ratul-hasibulkarim/Pipe-crawller/docs/acceptance_report.md

# Acceptance test report (software-in-the-loop)

Generated by `tests/acceptance/run_acceptance.py` on 2026-10-12 04:15.
The firmware core runs unmodified against the physics plant; HARDWARE rows need the bench procedures in docs/test_plan.md.

| Test | Size | Result | Criterion | Measured |
|---|---|---|---|---|
| T1 Grip hold, vertical, power off, 3x mass | S | **PASS** | zero axial slip (<0.1 mm) over 10 min at 3x mass, MCU unpowered | drift 0.000 mm, max slip 0.000 mm, unpowered=True |
| T2 Grip hold at 0/30/45/60/90 deg | S | **PASS** | holds at every angle, zero slip (<0.1 mm), powered then unpowered | 0 deg: 0.0 mm, 30 deg: 0.0 mm, 45 deg: 0.0 mm, 60 deg: 0.0 mm, 90 deg: 0.0 mm |
| T3 Crawl speed accuracy | S | **PASS** | true speed within +/-10 % of command (25/50/100 % up, 50 % down, vertical + horizontal), no wheel slip | worst error 0.2 % |
| T4 Diameter sweep | S | **PASS** | 102<->200 mm each way in < 20 s, repeatable and accurate to +/-1 mm | slowest 12.4 s, repeatability 0.03 mm, accuracy 0.32 mm |
| T5 Centering | S | **DEVIATION** | robot axis within 3 mm of the pipe axis at 5 diameters (vertical); horizontal gravity sag reported, bounded by 6.5 mm; reported pipe ID within 2 mm while gripping | vertical worst 0.00 mm, horizontal worst 5.81 mm (spring sag; see docs/real_world_issues.md); reported ID error 0.06 mm |
| T6 Pipe material matrix | S | **PASS** | climbs 0.5 m of 45 deg pipe in steel, PVC, HDPE, cast iron, concrete-lined (dry and wet); biofilm informational | biofilm dry: ok; biofilm wet: cannot climb |
| T7 Wet traction | S | **PASS** | holds and climbs 0.5 m of vertical wet pipe at mu = 0.42 | climbed 0.502 m, max slip 0.00 mm |
| T8 Elbow traversal (geometry) | S | **PASS** | rigid segments fit a 90 deg elbow of bend radius 306 mm at the minimum pipe ID | rear segment passes 90 deg elbow at min pipe: 228.0 vs 335.0; front segment passes 90 deg elbow at min pipe: 182.0 vs 335.0; articulation joint angle needed in the bend: 42.1 vs 45.0 |
| T9 Joint / weld bead traversal | S | **PASS** | crosses a 5 mm bead and a 5 mm step climbing vertically at 80 % speed; no stall, every arm keeps wall contact | reached 1.90 m, min true arm force 28.0 N, faults [] |
| T10 Video latency | S | **HARDWARE** | < 150 ms glass-to-glass over 50 m tether | bench: film a running ms clock and the phone screen together at 240 fps (docs/test_plan.md T10) |
| T11 Telemetry integrity | S | **PASS** | 20 Hz, < 0.1 % packet loss over 60 min, link BER 1e-7 both ways, corrupt frames rejected by CRC | 71991/72000 packets, loss 0.013 %, CRC rejects: host 9, MCU 0 |
| T12 Thermal | S | **PASS** | hottest modelled component (motor winding / driver) < 85 C through 60 min of vertical crawl at 40 C ambient, still crawling at the end | max 69.6 C, derate not needed, no trip, still climbing at end |
| T13 IP68 submersion | S | **HARDWARE** | 30 min at 1 m, no ingress (pressure-decay test first, then dunk) | bench: docs/test_plan.md T13 (vacuum decay 300 mbar / 10 min, then 1 m dunk, humidity log) |
| T14 Failsafe (tether cut mid-crawl) | S | **PASS** | tether power + data lost while climbing at full speed: stops within 1 s, holds, no downward motion | stopped after 20 ms, sank 0.00 mm, supply none (worms hold unpowered) |
| T15 Endurance | S | **N/A** | battery runtime | size S is tether-powered only (no battery) |
| T1 Grip hold, vertical, power off, 3x mass | M | **PASS** | zero axial slip (<0.1 mm) over 10 min at 3x mass, MCU unpowered | drift 0.000 mm, max slip 0.000 mm, unpowered=True |
| T2 Grip hold at 0/30/45/60/90 deg | M | **PASS** | holds at every angle, zero slip (<0.1 mm), powered then unpowered | 0 deg: 0.0 mm, 30 deg: 0.0 mm, 45 deg: 0.0 mm, 60 deg: 0.0 mm, 90 deg: 0.0 mm |
| T3 Crawl speed accuracy | M | **PASS** | true speed within +/-10 % of command (25/50/100 % up, 50 % down, vertical + horizontal), no wheel slip | worst error 0.2 % |
| T4 Diameter sweep | M | **PASS** | 152<->320 mm each way in < 20 s, repeatable and accurate to +/-1 mm | slowest 13.7 s, repeatability 0.01 mm, accuracy 0.32 mm |
| T5 Centering | M | **DEVIATION** | robot axis within 3 mm of the pipe axis at 5 diameters (vertical); horizontal gravity sag reported, bounded by 6.5 mm; reported pipe ID within 2 mm while gripping | vertical worst 0.00 mm, horizontal worst 5.86 mm (spring sag; see docs/real_world_issues.md); reported ID error 0.10 mm |
| T6 Pipe material matrix | M | **PASS** | climbs 0.5 m of 45 deg pipe in steel, PVC, HDPE, cast iron, concrete-lined (dry and wet); biofilm informational | biofilm dry: ok; biofilm wet: cannot climb |
| T7 Wet traction | M | **PASS** | holds and climbs 0.5 m of vertical wet pipe at mu = 0.42 | climbed 0.504 m, max slip 0.00 mm |
| T8 Elbow traversal (geometry) | M | **PASS** | rigid segments fit a 90 deg elbow of bend radius 456 mm at the minimum pipe ID | rear segment passes 90 deg elbow at min pipe: 351.0 vs 526.5; front segment passes 90 deg elbow at min pipe: 192.0 vs 526.5; articulation joint angle needed in the bend: 37.6 vs 45.0 |
| T9 Joint / weld bead traversal | M | **PASS** | crosses a 5 mm bead and a 5 mm step climbing vertically at 80 % speed; no stall, every arm keeps wall contact | reached 1.90 m, min true arm force 65.4 N, faults [] |
| T10 Video latency | M | **HARDWARE** | < 150 ms glass-to-glass over 50 m tether | bench: film a running ms clock and the phone screen together at 240 fps (docs/test_plan.md T10) |
| T11 Telemetry integrity | M | **PASS** | 20 Hz, < 0.1 % packet loss over 60 min, link BER 1e-7 both ways, corrupt frames rejected by CRC | 71991/72000 packets, loss 0.013 %, CRC rejects: host 9, MCU 0 |
| T12 Thermal | M | **PASS** | hottest modelled component (motor winding / driver) < 85 C through 60 min of vertical crawl at 40 C ambient, still crawling at the end | max 70.0 C, derate engaged, no trip, still climbing at end |
| T13 IP68 submersion | M | **HARDWARE** | 30 min at 1 m, no ingress (pressure-decay test first, then dunk) | bench: docs/test_plan.md T13 (vacuum decay 300 mbar / 10 min, then 1 m dunk, humidity log) |
| T14 Failsafe (tether cut mid-crawl) | M | **PASS** | tether power + data lost while climbing at full speed: stops within 1 s, holds, no downward motion | stopped after 240 ms, sank 0.00 mm, supply battery |
| T15 Endurance | M | **PASS** | >= 60 min battery-only crawl (50 % speed, horizontal), then LOW_POWER_SAFE holding grip | runtime 149 min, final state LOW_POWER_SAFE |
| T1 Grip hold, vertical, power off, 3x mass | L | **PASS** | zero axial slip (<0.1 mm) over 10 min at 3x mass, MCU unpowered | drift 0.000 mm, max slip 0.000 mm, unpowered=True |
| T2 Grip hold at 0/30/45/60/90 deg | L | **PASS** | holds at every angle, zero slip (<0.1 mm), powered then unpowered | 0 deg: 0.0 mm, 30 deg: 0.0 mm, 45 deg: 0.0 mm, 60 deg: 0.0 mm, 90 deg: 0.0 mm |
| T3 Crawl speed accuracy | L | **PASS** | true speed within +/-10 % of command (25/50/100 % up, 50 % down, vertical + horizontal), no wheel slip | worst error 0.4 % |
| T4 Diameter sweep | L | **PASS** | 300<->650 mm each way in < 20 s, repeatable and accurate to +/-1 mm | slowest 15.2 s, repeatability 0.01 mm, accuracy 0.31 mm |
| T5 Centering | L | **DEVIATION** | robot axis within 3 mm of the pipe axis at 5 diameters (vertical); horizontal gravity sag reported, bounded by 6.5 mm; reported pipe ID within 2 mm while gripping | vertical worst 0.00 mm, horizontal worst 5.99 mm (spring sag; see docs/real_world_issues.md); reported ID error 0.30 mm |
| T6 Pipe material matrix | L | **PASS** | climbs 0.5 m of 45 deg pipe in steel, PVC, HDPE, cast iron, concrete-lined (dry and wet); biofilm informational | biofilm dry: ok; biofilm wet: cannot climb |
| T7 Wet traction | L | **PASS** | holds and climbs 0.5 m of vertical wet pipe at mu = 0.42 | climbed 0.502 m, max slip 0.00 mm |
| T8 Elbow traversal (geometry) | L | **PASS** | rigid segments fit a 90 deg elbow of bend radius 900 mm at the minimum pipe ID | rear segment passes 90 deg elbow at min pipe: 510.0 vs 1100.3; front segment passes 90 deg elbow at min pipe: 235.0 vs 1100.3; articulation joint angle needed in the bend: 26.6 vs 45.0 |
| T9 Joint / weld bead traversal | L | **PASS** | crosses a 5 mm bead and a 5 mm step climbing vertically at 80 % speed; no stall, every arm keeps wall contact | reached 1.90 m, min true arm force 233.3 N, faults [] |
| T10 Video latency | L | **HARDWARE** | < 150 ms glass-to-glass over 50 m tether | bench: film a running ms clock and the phone screen together at 240 fps (docs/test_plan.md T10) |
| T11 Telemetry integrity | L | **PASS** | 20 Hz, < 0.1 % packet loss over 60 min, link BER 1e-7 both ways, corrupt frames rejected by CRC | 71991/72000 packets, loss 0.013 %, CRC rejects: host 9, MCU 0 |
| T12 Thermal | L | **PASS** | hottest modelled component (motor winding / driver) < 85 C through 60 min of vertical crawl at 40 C ambient, still crawling at the end | max 70.6 C, derate engaged, no trip, still climbing at end |
| T13 IP68 submersion | L | **HARDWARE** | 30 min at 1 m, no ingress (pressure-decay test first, then dunk) | bench: docs/test_plan.md T13 (vacuum decay 300 mbar / 10 min, then 1 m dunk, humidity log) |
| T14 Failsafe (tether cut mid-crawl) | L | **PASS** | tether power + data lost while climbing at full speed: stops within 1 s, holds, no downward motion | stopped after 240 ms, sank 0.00 mm, supply battery |
| T15 Endurance | L | **PASS** | >= 60 min battery-only crawl (50 % speed, horizontal), then LOW_POWER_SAFE holding grip | runtime 180 min (still running at end of sim), final state CRAWLING |

## Details

- T1 S: `{"drift_mm": 0.0}`
- T2 S: `{"0 deg": 0.0, "30 deg": 0.0, "45 deg": 0.0, "60 deg": 0.0, "90 deg": 0.0}`
- T3 S: `{"0deg 15mm/s": 15.0, "0deg 30mm/s": 30.0, "0deg 60mm/s": 60.1, "0deg -30mm/s": -30.0, "90deg 15mm/s": 15.0, "90deg 30mm/s": 30.0, "90deg 60mm/s": 60.1, "90deg -30mm/s": -30.0}`
- T4 S: `{"times_s": [12.45, 12.35, 12.25, 12.35, 12.2, 12.35], "hi": [199.68538532722695, 199.7051261738537, 199.67528394753992], "lo": [102.30971284118687, 102.29364131746902, 102.31530294335711]}`
- T5 S: `{"90deg 102mm": 0.0, "90deg 126mm": 0.0, "90deg 151mm": 0.0, "90deg 176mm": 0.0, "90deg 200mm": 0.0, "0deg 102mm": 5.81, "0deg 126mm": 5.81, "0deg 151mm": 5.81, "0deg 176mm": 5.81, "0deg 200mm": 5.81}`
- T6 S: `{"steel dry": "0.50 m", "steel wet": "0.50 m", "pvc dry": "0.50 m", "pvc wet": "0.50 m", "hdpe dry": "0.50 m", "hdpe wet": "0.50 m", "cast_iron dry": "0.50 m", "cast_iron wet": "0.50 m", "concrete_lined dry": "0.50 m", "concrete_lined wet": "0.50 m", "biofilm_drain dry": "0.50 m", "biofilm_drain wet": "-1.00 m FAIL"}`
- T1 M: `{"drift_mm": 0.0}`
- T2 M: `{"0 deg": 0.0, "30 deg": 0.0, "45 deg": 0.0, "60 deg": 0.0, "90 deg": 0.0}`
- T3 M: `{"0deg 24mm/s": 24.0, "0deg 48mm/s": 48.0, "0deg 95mm/s": 95.1, "0deg -48mm/s": -48.0, "90deg 24mm/s": 24.0, "90deg 48mm/s": 48.1, "90deg 95mm/s": 95.1, "90deg -48mm/s": -48.0}`
- T4 M: `{"times_s": [13.7, 13.7, 13.55, 13.7, 13.55, 13.7], "hi": [319.70058153696004, 319.68895429772954, 319.69799766534595], "lo": [152.30944709877522, 152.31521255611705, 152.30829406071163]}`
- T5 M: `{"90deg 152mm": 0.0, "90deg 194mm": 0.0, "90deg 236mm": 0.0, "90deg 278mm": 0.0, "90deg 320mm": 0.0, "0deg 152mm": 5.86, "0deg 194mm": 5.86, "0deg 236mm": 5.86, "0deg 278mm": 5.86, "0deg 320mm": 5.86}`
- T6 M: `{"steel dry": "0.50 m", "steel wet": "0.50 m", "pvc dry": "0.50 m", "pvc wet": "0.50 m", "hdpe dry": "0.50 m", "hdpe wet": "0.50 m", "cast_iron dry": "0.50 m", "cast_iron wet": "0.50 m", "concrete_lined dry": "0.50 m", "concrete_lined wet": "0.50 m", "biofilm_drain dry": "0.50 m", "biofilm_drain wet": "-1.00 m FAIL"}`
- T1 L: `{"drift_mm": 0.0}`
- T2 L: `{"0 deg": 0.0, "30 deg": 0.0, "45 deg": 0.0, "60 deg": 0.0, "90 deg": 0.0}`
- T3 L: `{"0deg 18mm/s": 18.0, "0deg 35mm/s": 35.1, "0deg 70mm/s": 70.1, "0deg -35mm/s": -35.0, "90deg 18mm/s": 18.1, "90deg 35mm/s": 35.1, "90deg 70mm/s": 70.1, "90deg -35mm/s": -35.1}`
- T4 L: `{"times_s": [15.1, 15.2, 15.2, 15.2, 15.05, 15.2], "hi": [649.6954932157279, 649.7079596335313, 649.7011609057913], "lo": [300.3092881055281, 300.3043819199976, 300.30928817776004]}`
- T5 L: `{"90deg 300mm": 0.0, "90deg 388mm": 0.0, "90deg 475mm": 0.0, "90deg 562mm": 0.0, "90deg 650mm": 0.0, "0deg 300mm": 5.99, "0deg 388mm": 5.99, "0deg 475mm": 5.99, "0deg 562mm": 5.99, "0deg 650mm": 5.99}`
- T6 L: `{"steel dry": "0.50 m", "steel wet": "0.50 m", "pvc dry": "0.50 m", "pvc wet": "0.50 m", "hdpe dry": "0.50 m", "hdpe wet": "0.50 m", "cast_iron dry": "0.50 m", "cast_iron wet": "0.50 m", "concrete_lined dry": "0.50 m", "concrete_lined wet": "0.50 m", "biofilm_drain dry": "0.50 m", "biofilm_drain wet": "-1.00 m FAIL"}`
