ratul-hasibulkarim/Pipe-crawller/docs/mass_report.md

# Mass report

Generated by `cad/build.py`. Made parts: CAD volume x density; purchased parts: catalogue mass.

## Size S

| Module | Mass (kg) |
|---|---|
| A_body | 0.348 |
| B_expansion | 0.365 |
| C_wheel | 0.170 |
| D_gimbal | 0.016 |
| E_accessories | 0.043 |
| purchased | 0.551 |
| **CAD total** | **1.492** |
| + 12 % wiring/grease/potting/fasteners | 0.179 |
| **Estimated flight mass** | **1.671** |

Target 1.8 kg: within target. CG at [-0.13, -0.02, 53.84] mm (radial offset 0.13 mm; roll calc assumes 3 mm).

## Size M

| Module | Mass (kg) |
|---|---|
| A_body | 0.681 |
| B_expansion | 1.034 |
| C_wheel | 0.459 |
| D_gimbal | 0.030 |
| E_accessories | 0.088 |
| purchased | 1.302 |
| **CAD total** | **3.593** |
| + 12 % wiring/grease/potting/fasteners | 0.431 |
| **Estimated flight mass** | **4.024** |

Target 4.2 kg: within target. CG at [-0.2, -0.03, 67.76] mm (radial offset 0.21 mm; roll calc assumes 5 mm).

## Size L

| Module | Mass (kg) |
|---|---|
| A_body | 2.076 |
| B_expansion | 4.605 |
| C_wheel | 1.251 |
| D_gimbal | 0.123 |
| E_accessories | 0.313 |
| purchased | 4.953 |
| **CAD total** | **13.321** |
| + 12 % wiring/grease/potting/fasteners | 1.599 |
| **Estimated flight mass** | **14.920** |

Target 15.0 kg: within target. CG at [0.09, -0.06, 61.67] mm (radial offset 0.11 mm; roll calc assumes 8 mm).
