ratul-hasibulkarim/Pipe-crawller/docs/fastener_table.md

# Fastener table

Per robot, generated by `cad/build.py` (rule 6: M2/M2.5/M3/M4 SHCS + heat-set inserts only).

## Size S

| Fastener | Qty |
|---|---|
| E-clip | 28 |
| M2 heat-set insert | 4 |
| M2.5 heat-set insert | 8 |
| M2.5x10 SHCS | 8 |
| M2.5x10 SHCS (spine) | 4 |
| M2.5x5 SHCS | 8 |
| M2.5x6 SHCS | 6 |
| M2.5x6 SHCS (pod) | 12 |
| M2.5x8 SHCS | 8 |
| M2.5x8 SHCS (radial) | 24 |
| M2x4 SHCS | 4 |
| M2x5 SHCS | 4 |
| M2x6 SHCS | 16 |
| M2x8 SHCS (eccentric) | 3 |
| M3 set screw | 2 |
| centring torsion spring | 2 |
| hose clamp | 2 |
| oil-impregnated bronze bushing (pivot) | 6 |
| split collet clamp (Kevlar strength member) | 1 |

## Size M

| Fastener | Qty |
|---|---|
| E-clip | 28 |
| M2 heat-set insert | 4 |
| M2.5 heat-set insert | 8 |
| M2.5x5 SHCS | 8 |
| M2x4 SHCS | 4 |
| M2x5 SHCS | 4 |
| M2x6 SHCS | 4 |
| M2x8 SHCS (eccentric) | 3 |
| M3 set screw | 2 |
| M3x10 SHCS | 8 |
| M3x10 SHCS (spine) | 4 |
| M3x6 SHCS | 6 |
| M3x6 SHCS (pod) | 12 |
| M3x8 SHCS | 20 |
| M3x8 SHCS (radial) | 24 |
| centring torsion spring | 2 |
| hose clamp | 2 |
| oil-impregnated bronze bushing (pivot) | 6 |
| split collet clamp (Kevlar strength member) | 1 |

## Size L

| Fastener | Qty |
|---|---|
| E-clip | 28 |
| M2 heat-set insert | 4 |
| M2.5 heat-set insert | 8 |
| M2.5x5 SHCS | 8 |
| M2x4 SHCS | 4 |
| M2x5 SHCS | 4 |
| M2x6 SHCS | 4 |
| M2x8 SHCS (eccentric) | 3 |
| M3 set screw | 2 |
| M3x8 SHCS | 12 |
| M4x10 SHCS | 8 |
| M4x10 SHCS (spine) | 4 |
| M4x6 SHCS | 6 |
| M4x6 SHCS (pod) | 12 |
| M4x8 SHCS | 8 |
| M4x8 SHCS (radial) | 24 |
| centring torsion spring | 2 |
| hose clamp | 2 |
| oil-impregnated bronze bushing (pivot) | 6 |
| split collet clamp (Kevlar strength member) | 1 |
