ratul-hasibulkarim/Pipe-crawller/cad/exports/common/png/tether_reel_frame.png

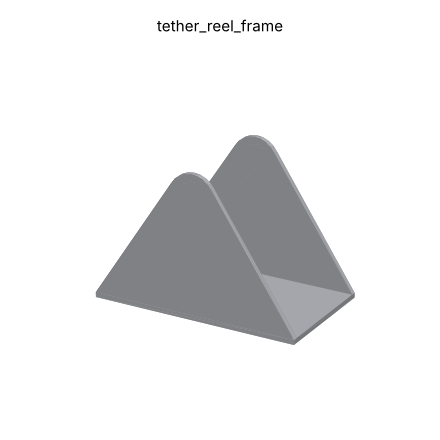
cad/exports/common/png/tether_reel_frame.png
