ratul-hasibulkarim/Pipe-crawller/cad/exports/common/png/tether_reel_motor_NEMA17.png

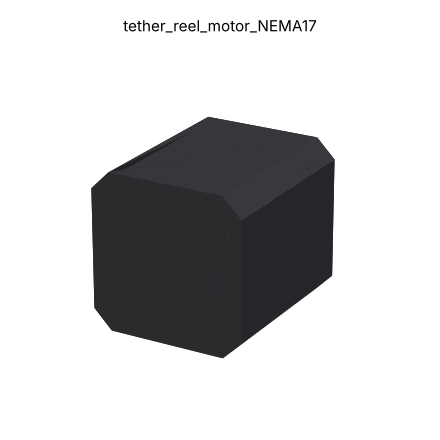
cad/exports/common/png/tether_reel_motor_NEMA17.png
