ratul-hasibulkarim/Pipe-crawller/cad/exports/common/png/tether_reel_slip_ring.png

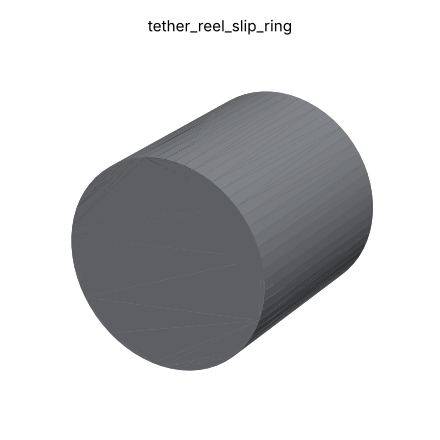
cad/exports/common/png/tether_reel_slip_ring.png
