ratul-hasibulkarim/Pipe-crawller/cad/exports/common/png/tether_reel_spool.png

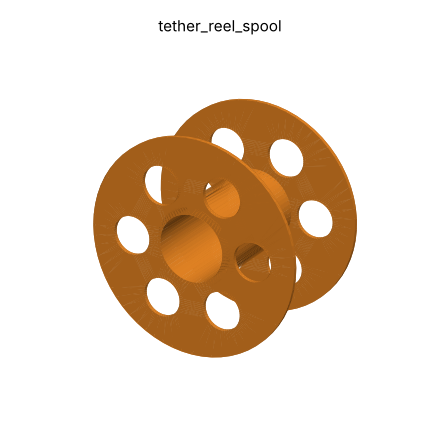
cad/exports/common/png/tether_reel_spool.png
