ratul-hasibulkarim/Pipe-crawller/cad/exports/common/tether_reel.png

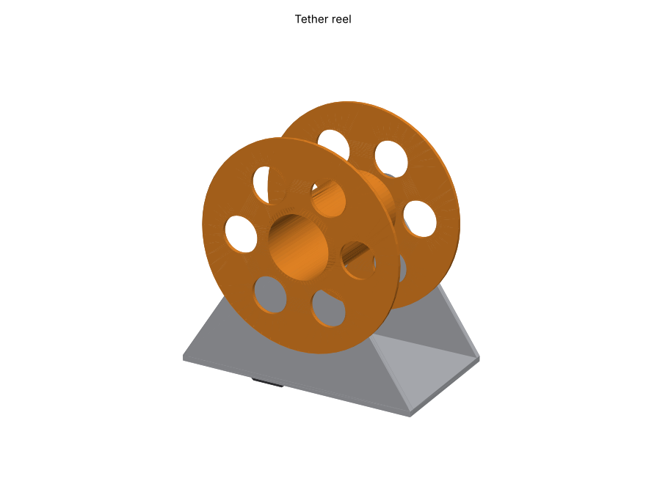
cad/exports/common/tether_reel.png
