ratul-hasibulkarim/Pipe-crawller/cad/exports/L/exploded.png

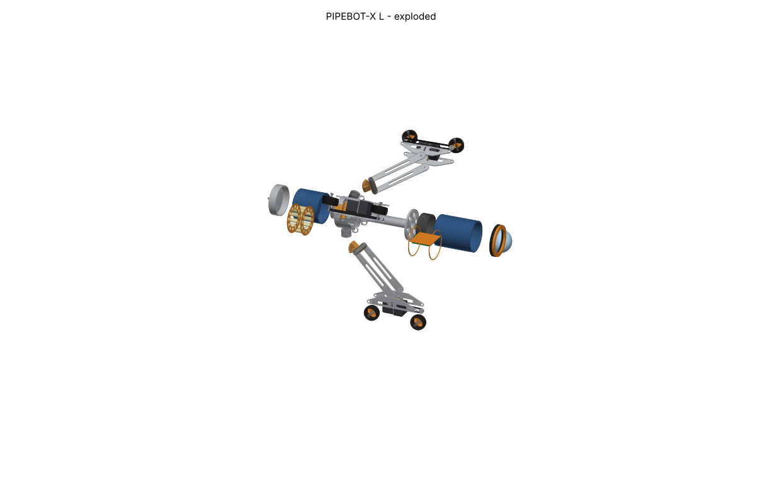
cad/exports/L/exploded.png
