ratul-hasibulkarim/Pipe-crawller/cad/exports/L/front_view_max.png

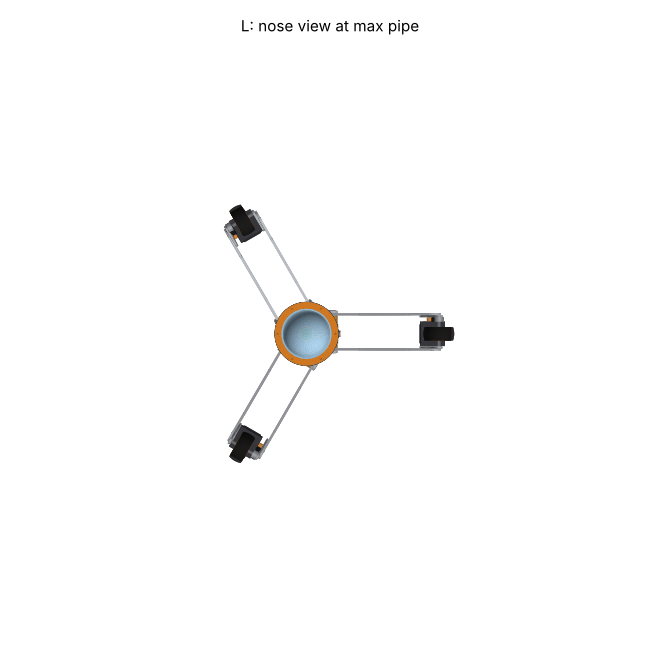
cad/exports/L/front_view_max.png
