ratul-hasibulkarim/Pipe-crawller/cad/exports/L/png/articulation_spider.png

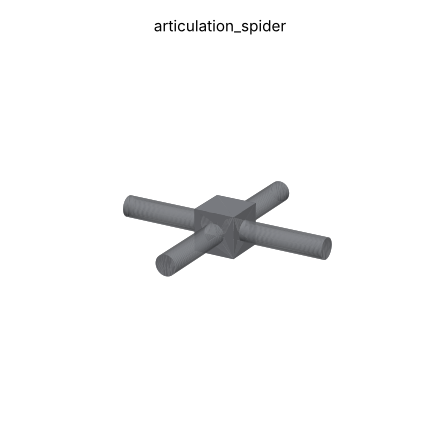
cad/exports/L/png/articulation_spider.png
