ratul-hasibulkarim/Pipe-crawller/cad/exports/L/png/articulation_yoke_front.png

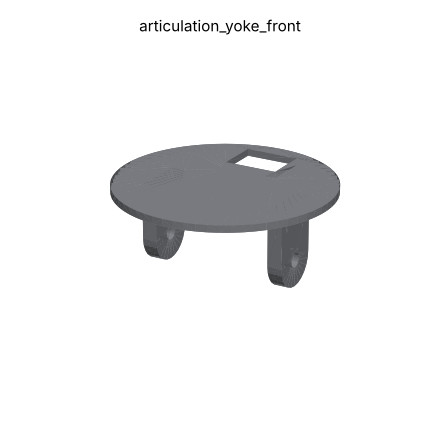
cad/exports/L/png/articulation_yoke_front.png
