ratul-hasibulkarim/Pipe-crawller/cad/exports/L/png/articulation_yoke_rear.png

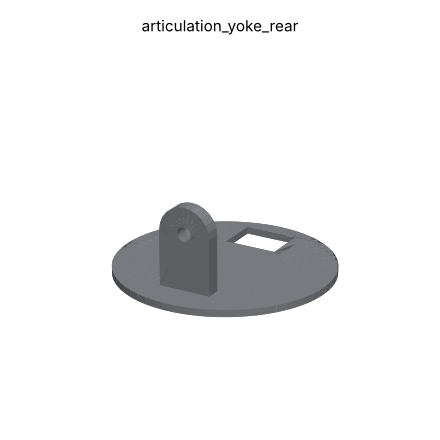
cad/exports/L/png/articulation_yoke_rear.png
