ratul-hasibulkarim/Pipe-crawller/cad/exports/L/png/battery_caddy.png

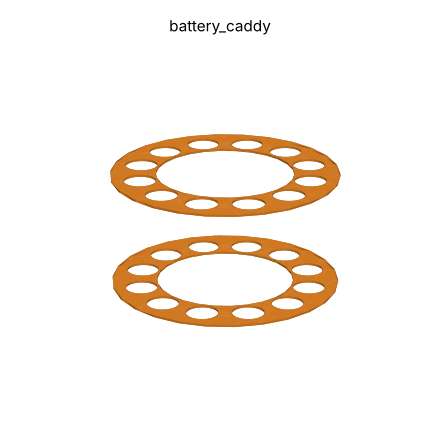
cad/exports/L/png/battery_caddy.png
