ratul-hasibulkarim/Pipe-crawller/cad/exports/L/png/bearing_MR128ZZ.png

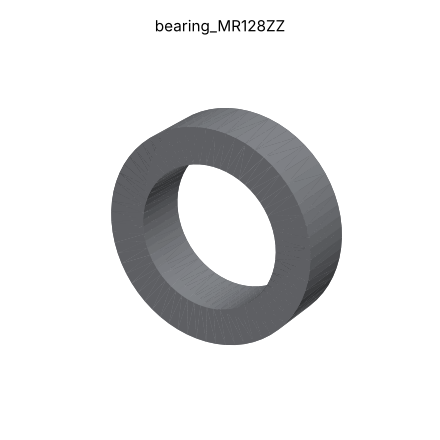
cad/exports/L/png/bearing_MR128ZZ.png
