ratul-hasibulkarim/Pipe-crawller/cad/exports/L/png/belt_tensioner.png

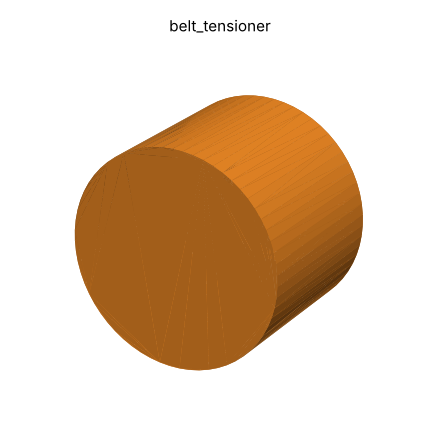
cad/exports/L/png/belt_tensioner.png
