ratul-hasibulkarim/Pipe-crawller/cad/exports/L/png/bevel_crown.png

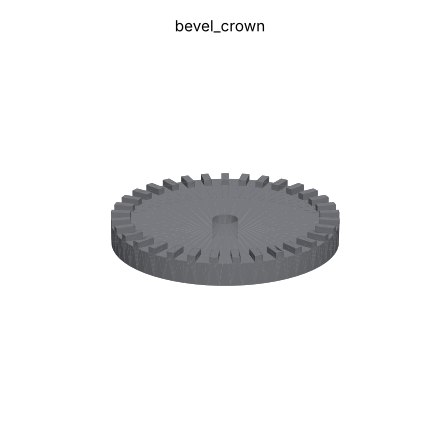
cad/exports/L/png/bevel_crown.png
