ratul-hasibulkarim/Pipe-crawller/cad/exports/L/png/bevel_pinion.png

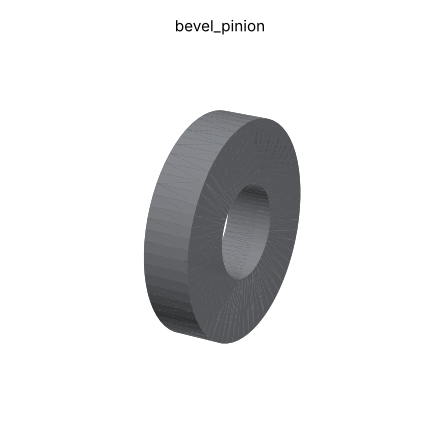
cad/exports/L/png/bevel_pinion.png
