ratul-hasibulkarim/Pipe-crawller/cad/exports/L/png/body_front_shell.png

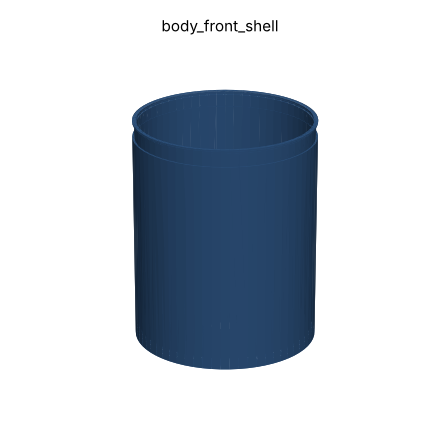
cad/exports/L/png/body_front_shell.png
