ratul-hasibulkarim/Pipe-crawller/cad/exports/L/png/body_mid_chassis.png

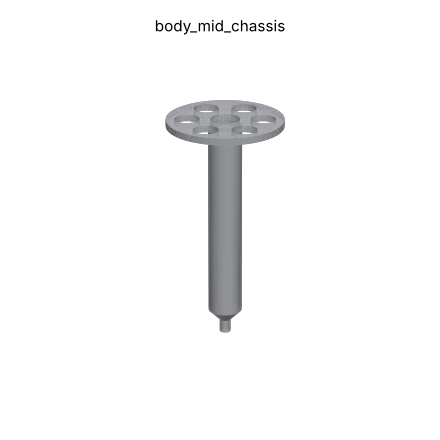
cad/exports/L/png/body_mid_chassis.png
