ratul-hasibulkarim/Pipe-crawller/cad/exports/L/png/buck_48v_12v_5v.png

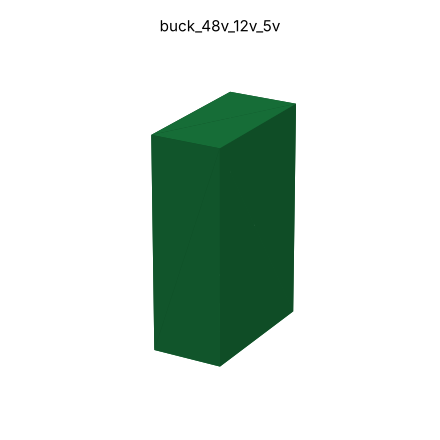
cad/exports/L/png/buck_48v_12v_5v.png
