ratul-hasibulkarim/Pipe-crawller/cad/exports/L/png/camera_module.png

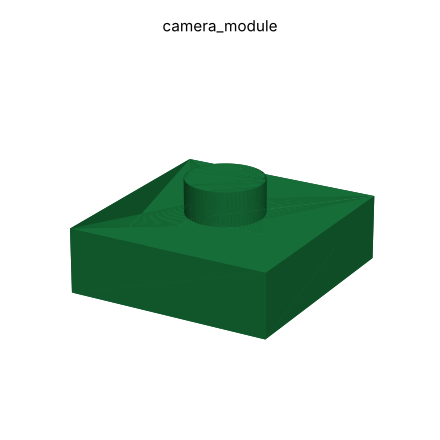
cad/exports/L/png/camera_module.png
