ratul-hasibulkarim/Pipe-crawller/cad/exports/L/png/cell_18650.png

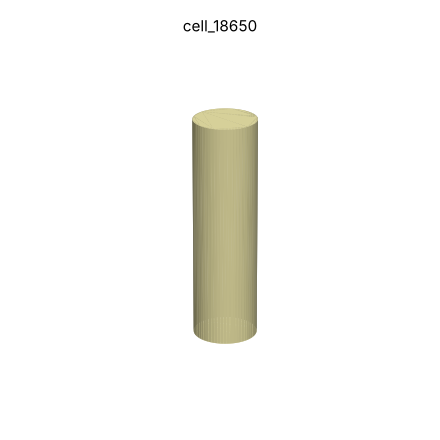
cad/exports/L/png/cell_18650.png
