ratul-hasibulkarim/Pipe-crawller/cad/exports/L/png/compliance_spring_retainer.png

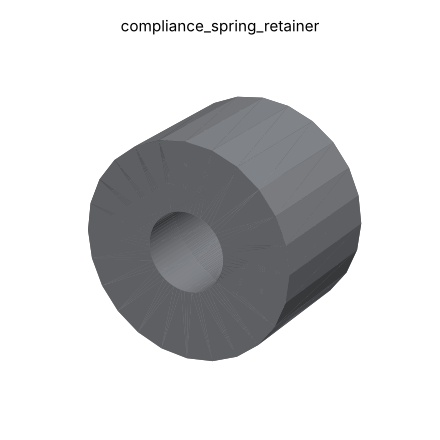
cad/exports/L/png/compliance_spring_retainer.png
