ratul-hasibulkarim/Pipe-crawller/cad/exports/L/png/drive_belt_GT2.png

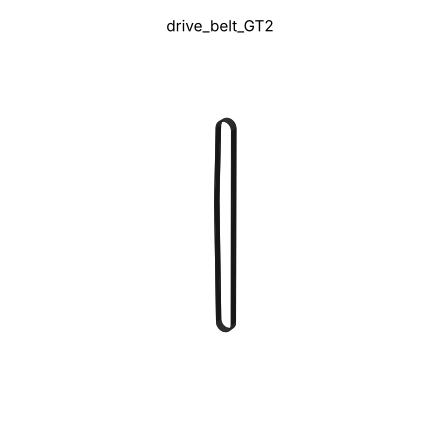
cad/exports/L/png/drive_belt_GT2.png
