ratul-hasibulkarim/Pipe-crawller/cad/exports/L/png/drive_motor_mount.png

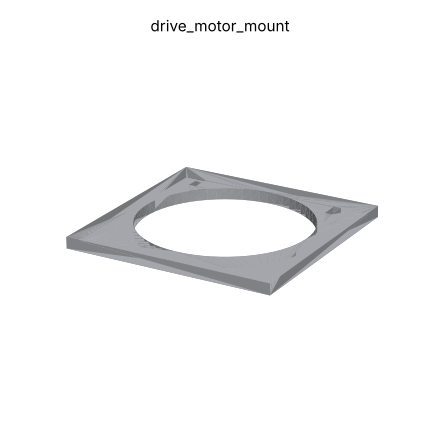
cad/exports/L/png/drive_motor_mount.png
