ratul-hasibulkarim/Pipe-crawller/cad/exports/L/png/drive_stepper_NEMA23.png

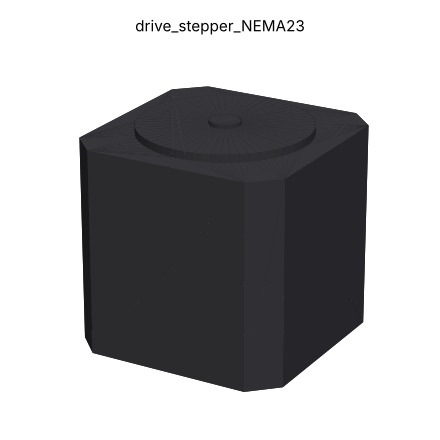
cad/exports/L/png/drive_stepper_NEMA23.png
