ratul-hasibulkarim/Pipe-crawller/cad/exports/L/png/drive_worm_gearbox_21to1.png

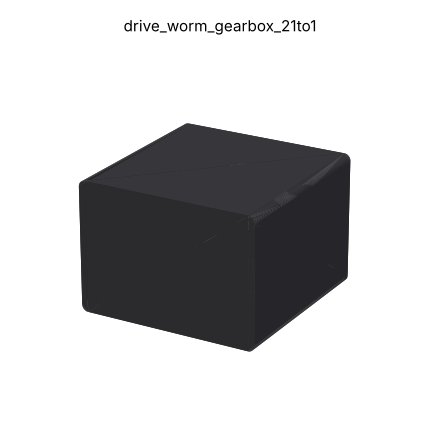
cad/exports/L/png/drive_worm_gearbox_21to1.png
