ratul-hasibulkarim/Pipe-crawller/cad/exports/L/png/electronics_tray.png

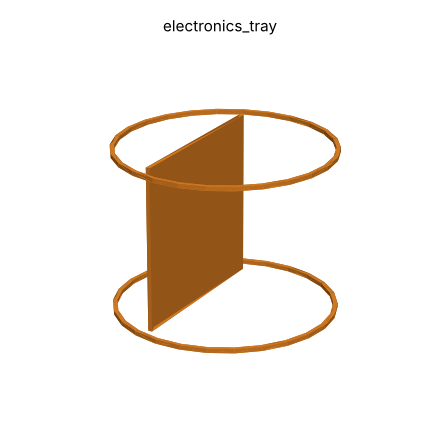
cad/exports/L/png/electronics_tray.png
