ratul-hasibulkarim/Pipe-crawller/cad/exports/L/png/expansion_motor_NEMA23L.png

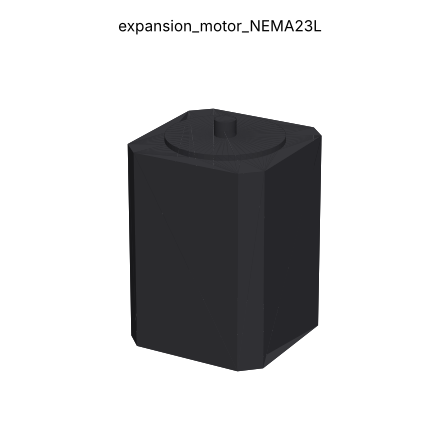
cad/exports/L/png/expansion_motor_NEMA23L.png
