ratul-hasibulkarim/Pipe-crawller/cad/exports/L/png/expansion_worm.png

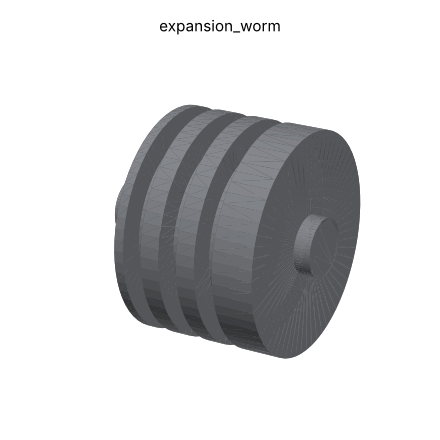
cad/exports/L/png/expansion_worm.png
