ratul-hasibulkarim/Pipe-crawller/cad/exports/L/png/gearbox_bulkhead.png

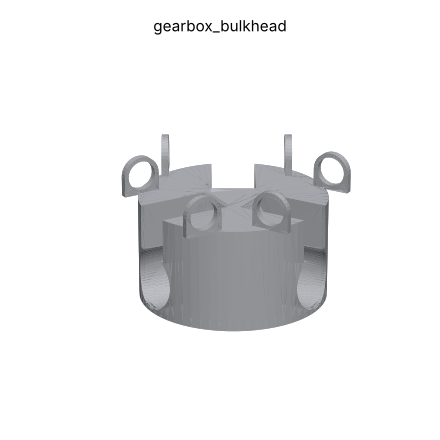
cad/exports/L/png/gearbox_bulkhead.png
