ratul-hasibulkarim/Pipe-crawller/cad/exports/L/png/gimbal_tilt_cradle.png

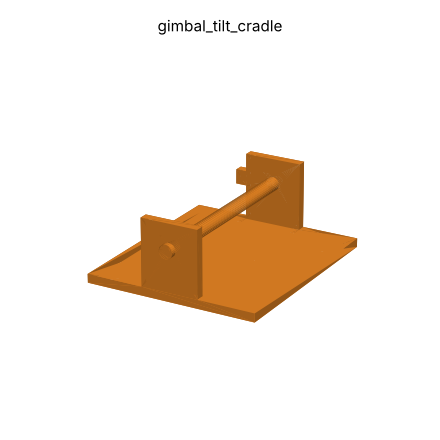
cad/exports/L/png/gimbal_tilt_cradle.png
