ratul-hasibulkarim/Pipe-crawller/cad/exports/L/png/joint_boot.png

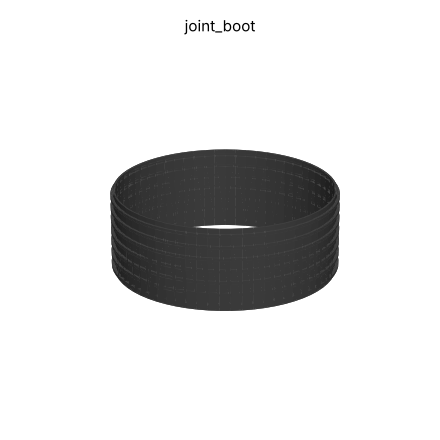
cad/exports/L/png/joint_boot.png
