ratul-hasibulkarim/Pipe-crawller/cad/exports/L/png/led_ring_mount.png

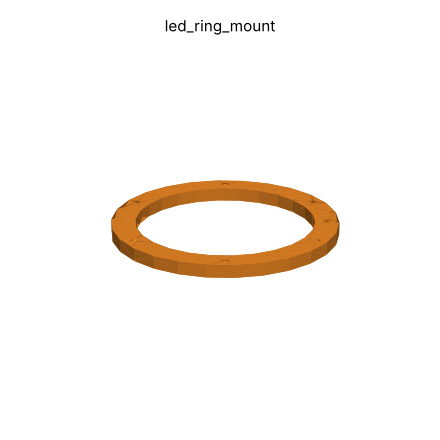
cad/exports/L/png/led_ring_mount.png
