ratul-hasibulkarim/Pipe-crawller/cad/exports/L/png/mcu_board_RP2040.png

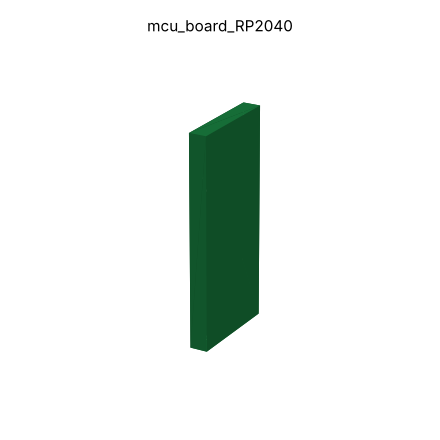
cad/exports/L/png/mcu_board_RP2040.png
