ratul-hasibulkarim/Pipe-crawller/cad/exports/L/png/pan_gearmotor_ga25.png

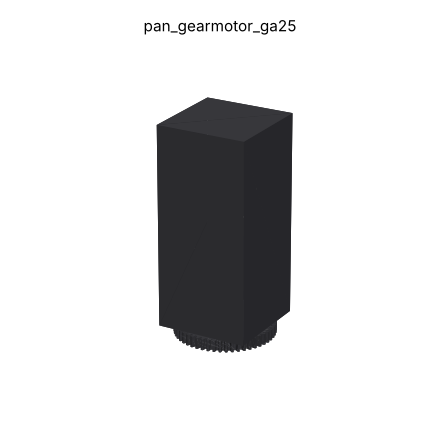
cad/exports/L/png/pan_gearmotor_ga25.png
