ratul-hasibulkarim/Pipe-crawller/cad/exports/L/png/pipe_size_adapter.png

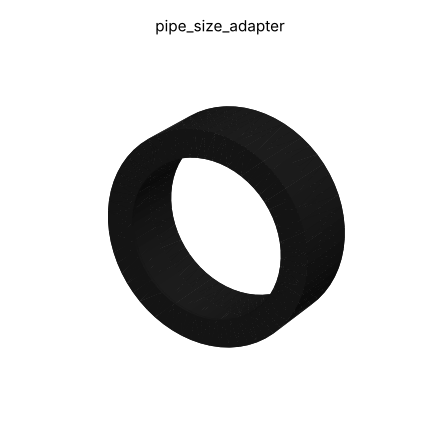
cad/exports/L/png/pipe_size_adapter.png
