ratul-hasibulkarim/Pipe-crawller/cad/exports/L/png/pivot_shaft.png

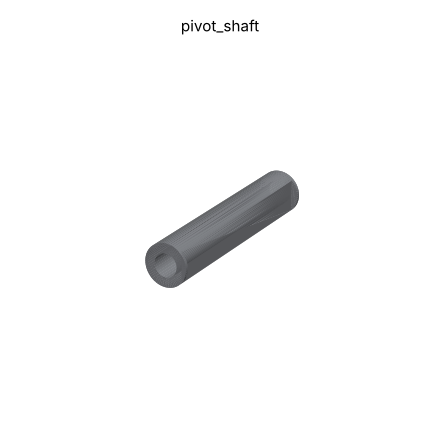
cad/exports/L/png/pivot_shaft.png
