ratul-hasibulkarim/Pipe-crawller/cad/exports/L/png/service_hatch_gasket.png

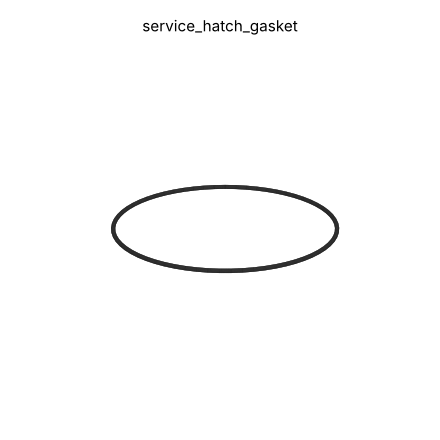
cad/exports/L/png/service_hatch_gasket.png
