ratul-hasibulkarim/Pipe-crawller/cad/exports/L/png/stub_pin.png

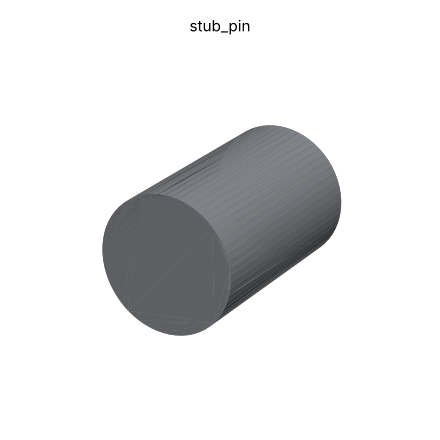
cad/exports/L/png/stub_pin.png
