ratul-hasibulkarim/Pipe-crawller/cad/exports/L/png/tether_strain_relief.png

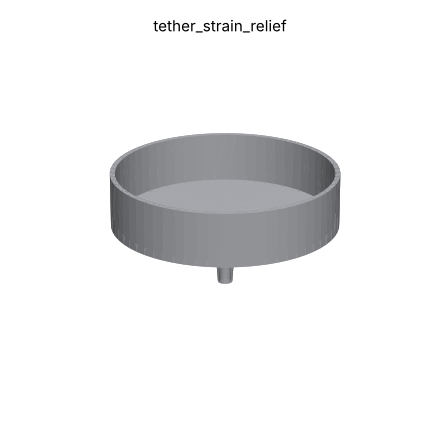
cad/exports/L/png/tether_strain_relief.png
