ratul-hasibulkarim/Pipe-crawller/cad/exports/L/png/tilt_servo_micro.png

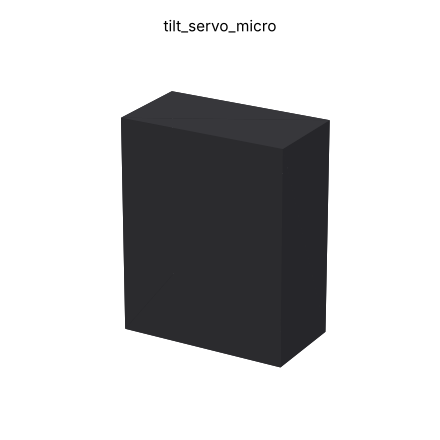
cad/exports/L/png/tilt_servo_micro.png
