ratul-hasibulkarim/Pipe-crawller/cad/exports/L/png/timing_pulley_GT2.png

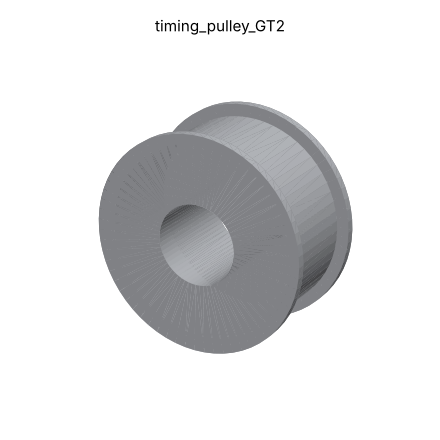
cad/exports/L/png/timing_pulley_GT2.png
