ratul-hasibulkarim/Pipe-crawller/cad/exports/L/png/wheel_crown_mold.png

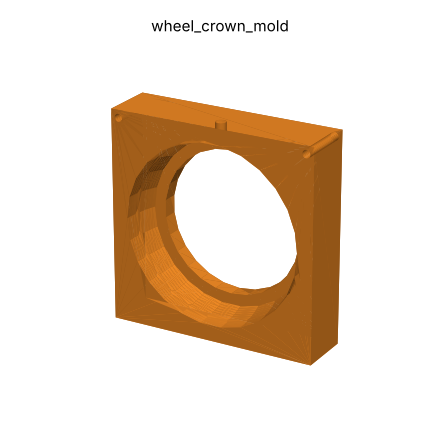
cad/exports/L/png/wheel_crown_mold.png
