ratul-hasibulkarim/Pipe-crawller/cad/exports/L/png/wheel_hub.png

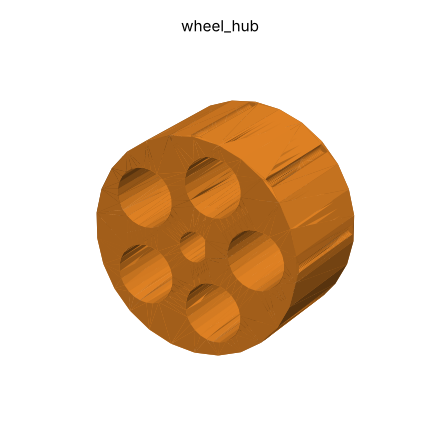
cad/exports/L/png/wheel_hub.png
