ratul-hasibulkarim/Pipe-crawller/cad/exports/L/png/wheel_tread.png

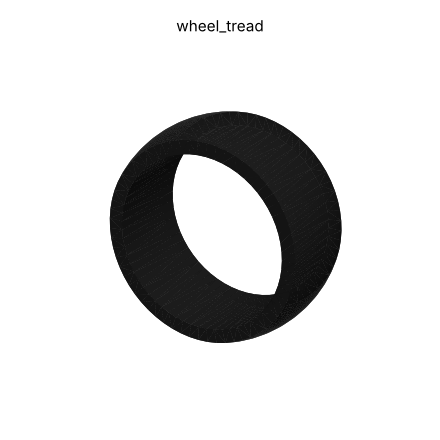
cad/exports/L/png/wheel_tread.png
