ratul-hasibulkarim/Pipe-crawller/cad/exports/L/png/worm_sector.png

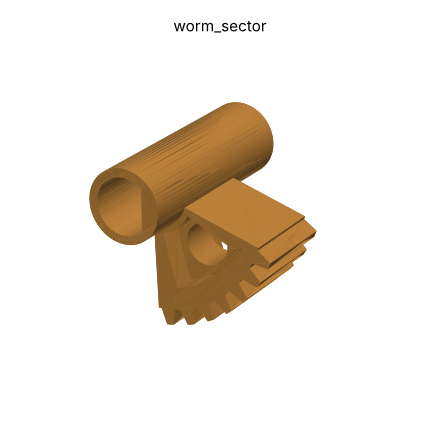
cad/exports/L/png/worm_sector.png
