ratul-hasibulkarim/Pipe-crawller/cad/exports/M/png/battery_caddy.png

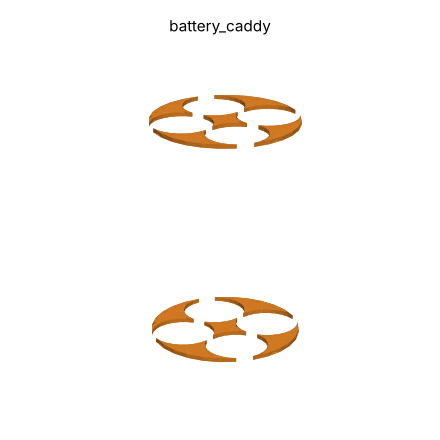
cad/exports/M/png/battery_caddy.png
