ratul-hasibulkarim/Pipe-crawller/cad/exports/M/png/drive_stepper_NEMA14.png

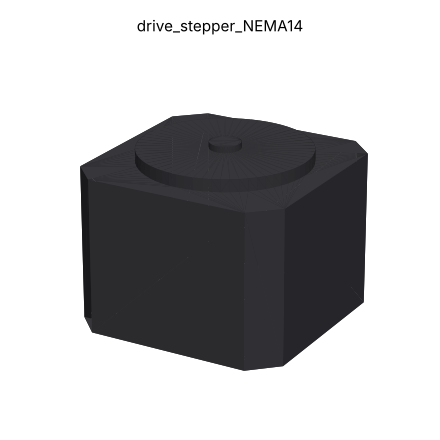
cad/exports/M/png/drive_stepper_NEMA14.png
