ratul-hasibulkarim/Pipe-crawller/cad/exports/M/png/electronics_tray.png

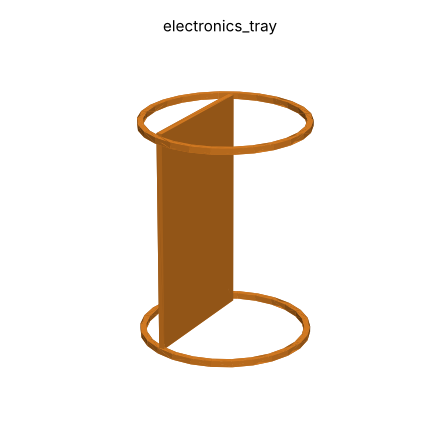
cad/exports/M/png/electronics_tray.png
