ratul-hasibulkarim/Pipe-crawller/cad/exports/M/png/gimbal_pan_yoke.png

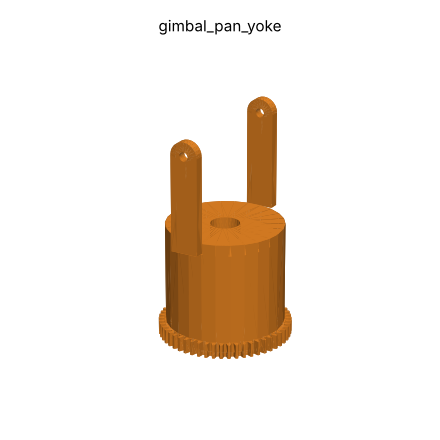
cad/exports/M/png/gimbal_pan_yoke.png
