ratul-hasibulkarim/Pipe-crawller/cad/exports/M/png/planetary_5to1.png

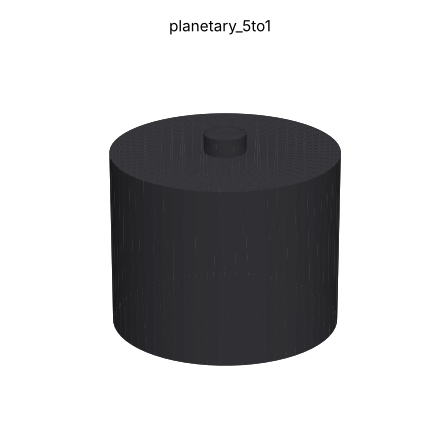
cad/exports/M/png/planetary_5to1.png
