ratul-hasibulkarim/Pipe-crawller/cad/exports/M/png/tilt_servo_nano.png

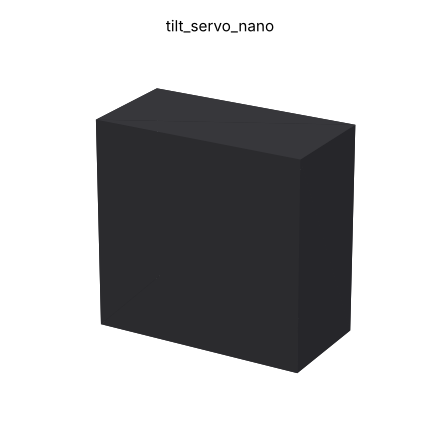
cad/exports/M/png/tilt_servo_nano.png
