ratul-hasibulkarim/Pipe-crawller/cad/exports/M/png/wheel_crown_mold.png

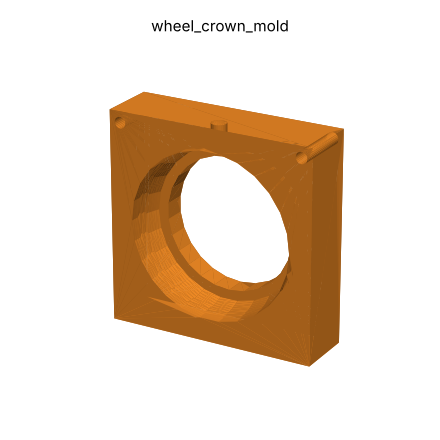
cad/exports/M/png/wheel_crown_mold.png
