ratul-hasibulkarim/Pipe-crawller/cad/exports/S/png/drive_motor_mount.png

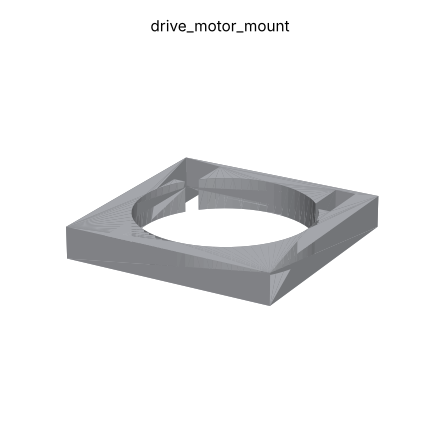
cad/exports/S/png/drive_motor_mount.png
