ratul-hasibulkarim/Pipe-crawller/cad/exports/S/png/expansion_motor_NEMA14.png

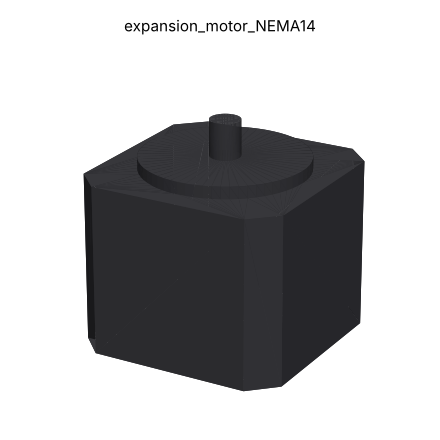
cad/exports/S/png/expansion_motor_NEMA14.png
