ratul-hasibulkarim/Pipe-crawller/cad/exports/S/png/tether_strain_relief.png

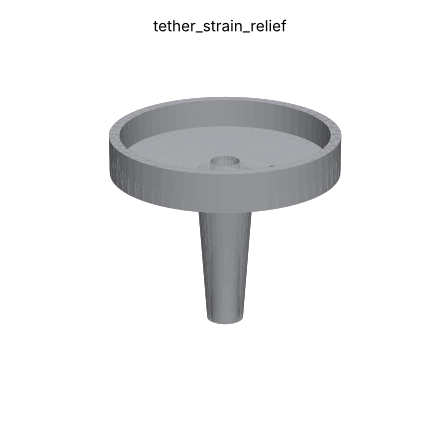
cad/exports/S/png/tether_strain_relief.png
