ratul-hasibulkarim/Pipe-crawller/docs/img/sil_T9_M.png

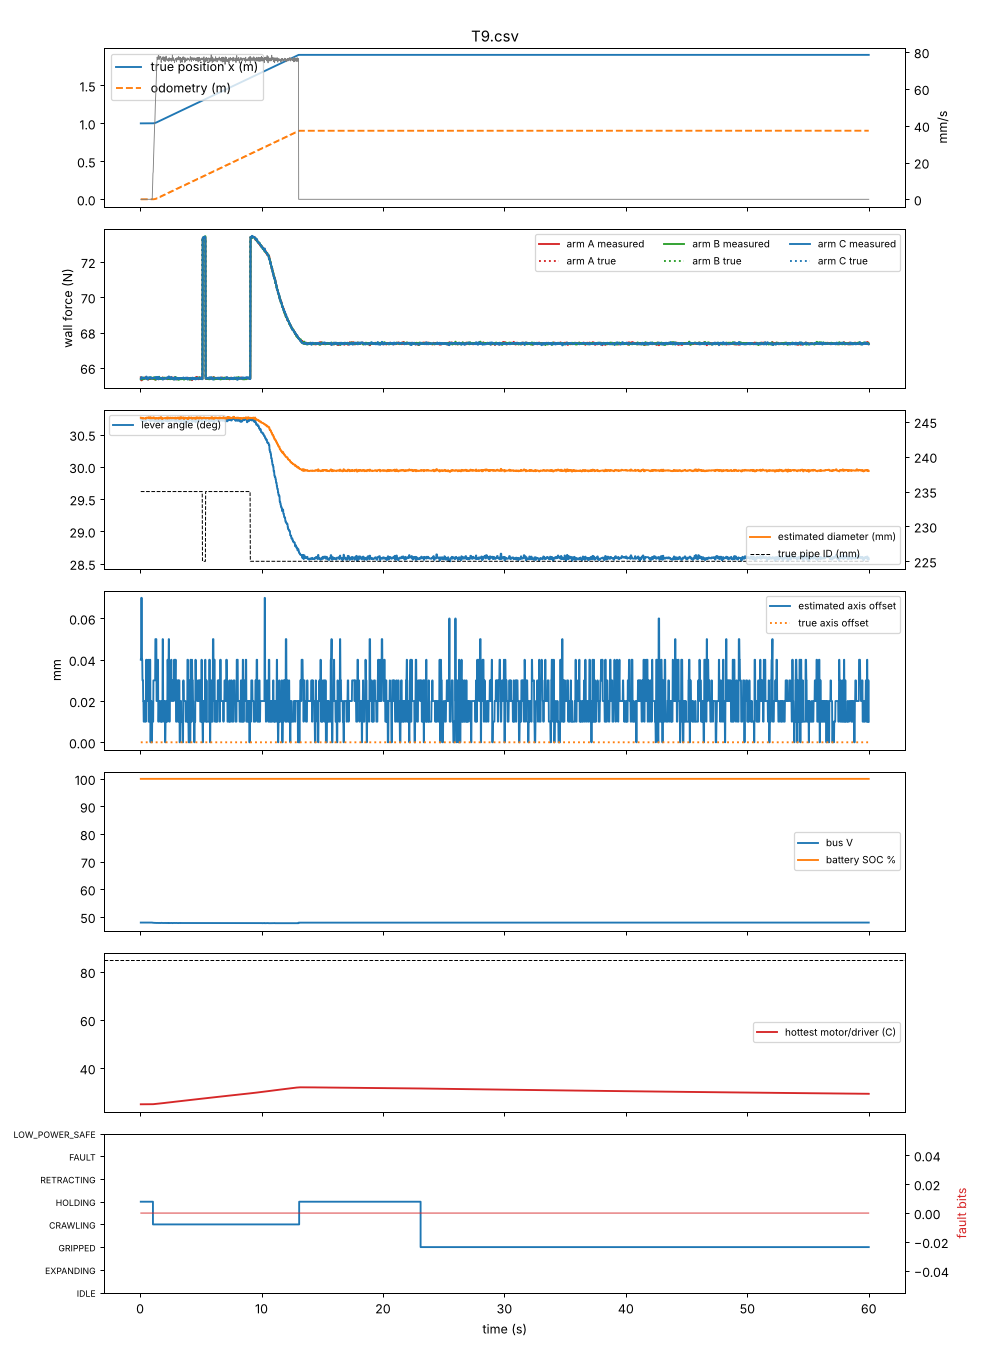
docs/img/sil_T9_M.png
