ratul-hasibulkarim/Pipe-crawller/docs/img/sil_T14_L.png

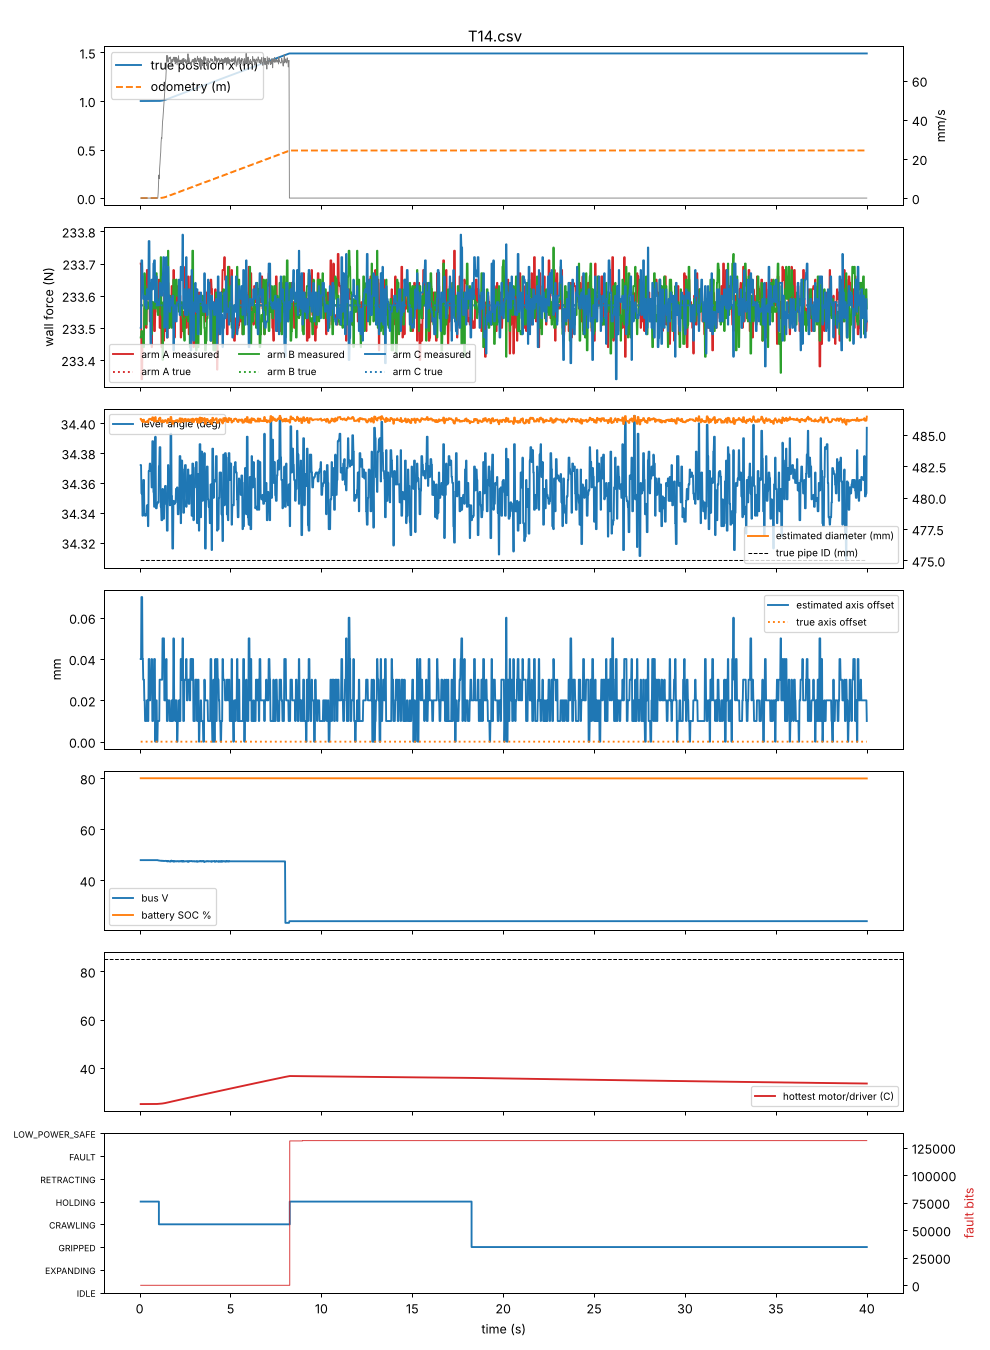
docs/img/sil_T14_L.png
