ratul-hasibulkarim/Pipe-crawller/docs/img/ui_connect.png

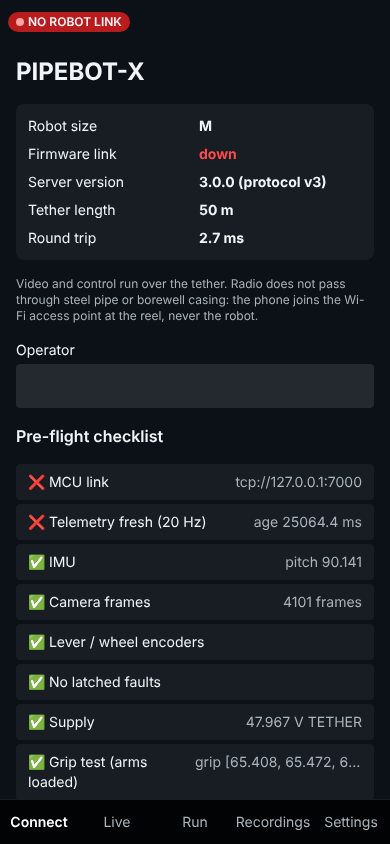
docs/img/ui_connect.png
