ratul-hasibulkarim/Pipe-crawller/docs/img/ui_live_stale.png

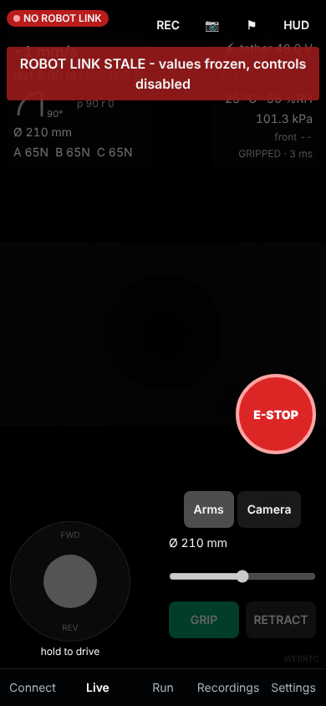
docs/img/ui_live_stale.png
