ratul-hasibulkarim/Pipe-crawller/docs/img/ui_run.png

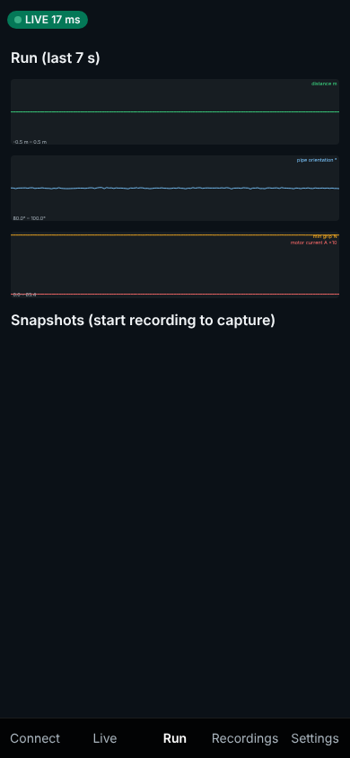
docs/img/ui_run.png
