ratul-hasibulkarim/Pipe-crawller/docs/img/ui_settings.png

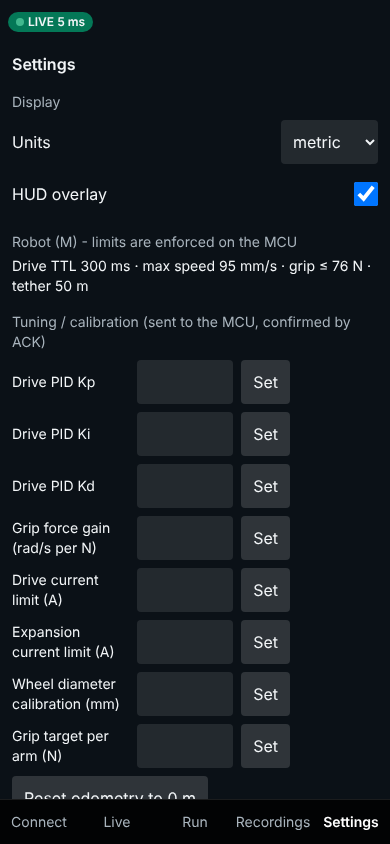
docs/img/ui_settings.png
