ratul-hasibulkarim/Pipe-crawller/cad/exports/M/assembly.step

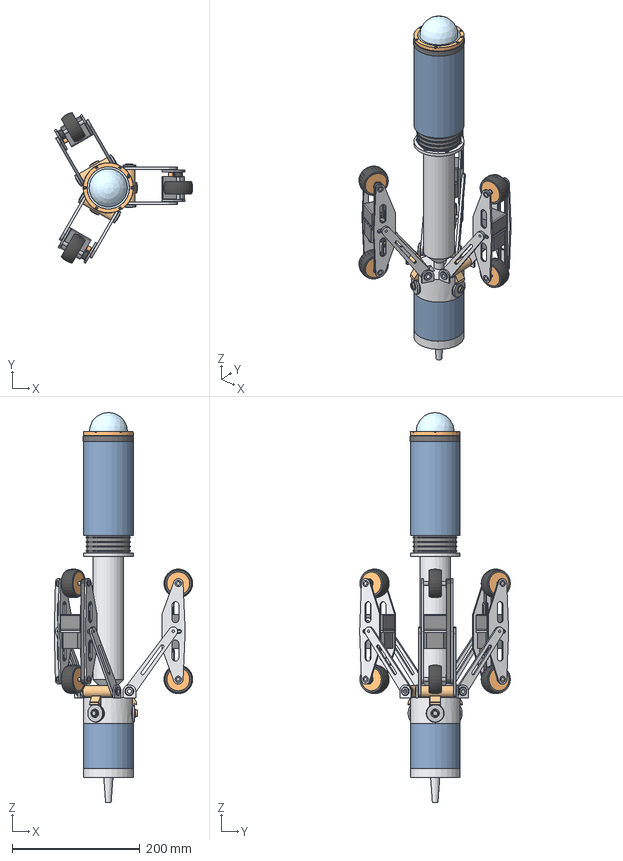
[picture p64: CAD file, 2026-10-12]
cad/exports/M/assembly.step
216.4 x 235.9 x 610.0 mm
body_rear_shell
tether_strain_relief
body_mid_chassis
body_front_shell
electronics_tray
gearbox_bulkhead
bevel_crown
camera_window
led_ring_mount
nose_bumper
articulation_yoke_rear
articulation_yoke_front
articulation_spider
joint_boot
battery_caddy
expansion_motor_NEMA17
planetary_5to1
pan_gearmotor_n20
slip_ring_6w
service_hatch_gasket_0 x 6
compute_CM4
mcu_board_RP2040
buck_48v_12v_5v
cell_18650_0 x 4
gimbal_pan_yoke
tilt_servo_nano
gimbal_tilt_cradle
camera_module
expansion_worm_0 x 3
bevel_pinion_0 x 3
worm_bearing_block_0_0 x 6
lever_plate_n_0 x 6
worm_sector_0 x 3
pivot_shaft_0 x 3
rocker_plate_n_0 x 6
wheel_hub_0_0 x 6
wheel_tread_0_0 x 6
wheel_axle_0_0 x 6
bearing_00_0 x 12
pulley_rear_0 x 9
drive_belt_GT2_0 x 3
belt_tensioner_0 x 3
drive_motor_mount_0 x 3
drive_stepper_NEMA14_0 x 3
drive_worm_gearbox_20to1_0 x 3
compliance_spring_retainer_n_0 x 6
slide_bushing_n_0 x 6
stub_pin_n_0 x 6
