ratul-hasibulkarim/Pipe-crawller/cad/exports/S/assembly.step

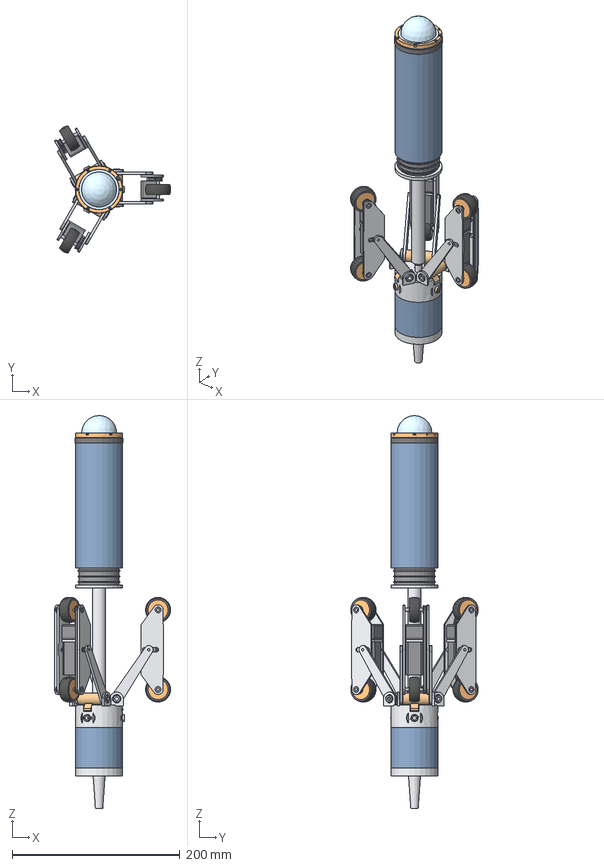
[picture p65: CAD file, 2026-10-12]
cad/exports/S/assembly.step
138.8 x 152.2 x 469.0 mm
body_rear_shell
tether_strain_relief
body_mid_chassis
body_front_shell
electronics_tray
gearbox_bulkhead
bevel_crown
camera_window
led_ring_mount
nose_bumper
articulation_yoke_rear
articulation_yoke_front
articulation_spider
joint_boot
expansion_motor_NEMA14
planetary_5to1
pan_gearmotor_n20
slip_ring_6w
service_hatch_gasket_0 x 6
compute_Pi_Zero_2_W
mcu_board_RP2040
buck_48v_12v_5v
gimbal_pan_yoke
tilt_servo_nano
gimbal_tilt_cradle
camera_module
expansion_worm_0 x 3
bevel_pinion_0 x 3
worm_bearing_block_0_0 x 6
lever_plate_n_0 x 6
worm_sector_0 x 3
pivot_shaft_0 x 3
rocker_plate_n_0 x 6
wheel_hub_0_0 x 6
wheel_tread_0_0 x 6
wheel_axle_0_0 x 6
bearing_00_0 x 12
pulley_rear_0 x 9
drive_belt_GT2_0 x 3
belt_tensioner_0 x 3
drive_motor_mount_0 x 3
drive_stepper_NEMA8_0 x 3
drive_worm_gearbox_35to1_0 x 3
compliance_spring_retainer_n_0 x 6
slide_bushing_n_0 x 6
stub_pin_n_0 x 6
