ratul-hasibulkarim/Pipe-crawller/cad/exports/common/step/tether_reel_frame.step

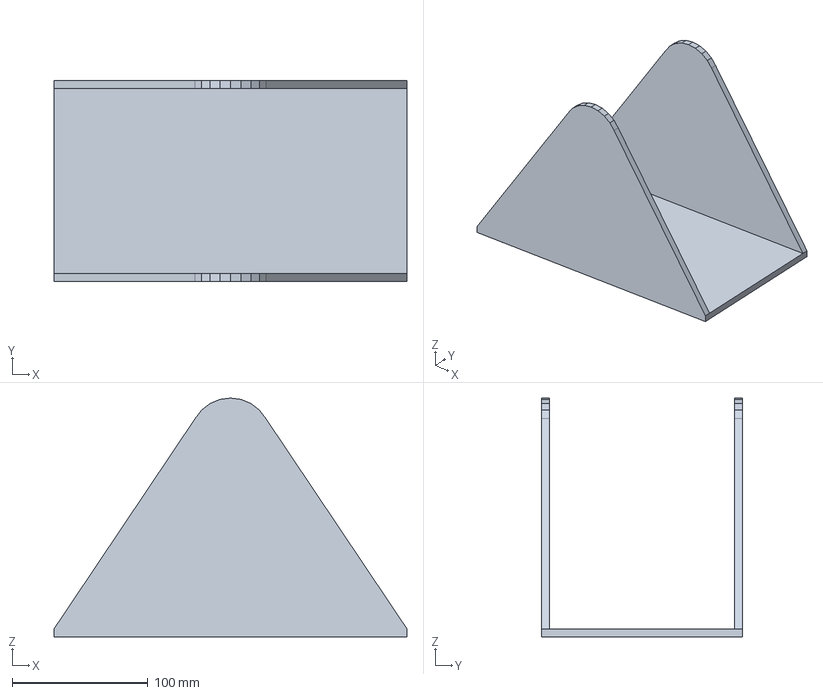
[picture p66: CAD file, 2026-10-12]
cad/exports/common/step/tether_reel_frame.step
260.0 x 148.0 x 176.0 mm
