ratul-hasibulkarim/Pipe-crawller/cad/exports/L/step/cell_18650.step

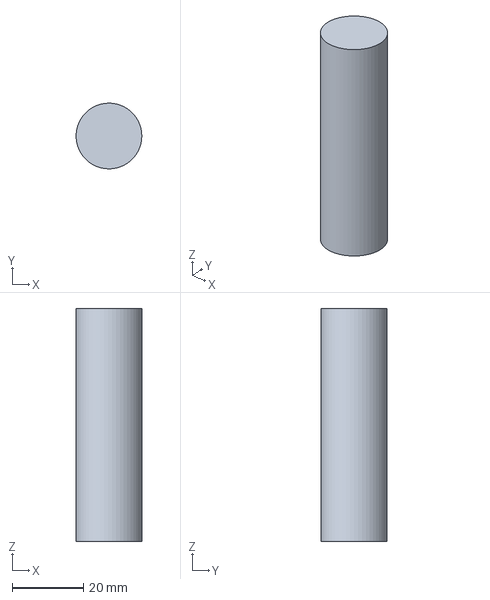
[picture p67: CAD file, 2026-10-12]
cad/exports/L/step/cell_18650.step
18.4 x 18.4 x 65.2 mm
