ratul-hasibulkarim/Pipe-crawller/cad/exports/M/step/stub_pin.step

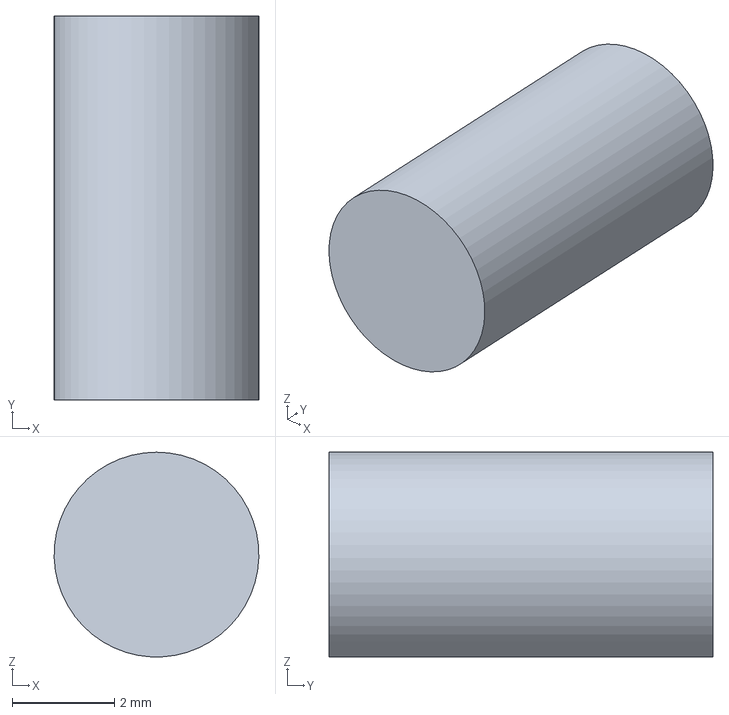
[picture p68: CAD file, 2026-10-12]
cad/exports/M/step/stub_pin.step
4.00 x 7.50 x 4.00 mm
