ratul-hasibulkarim/Pipe-crawller/cad/exports/S/step/camera_module.step

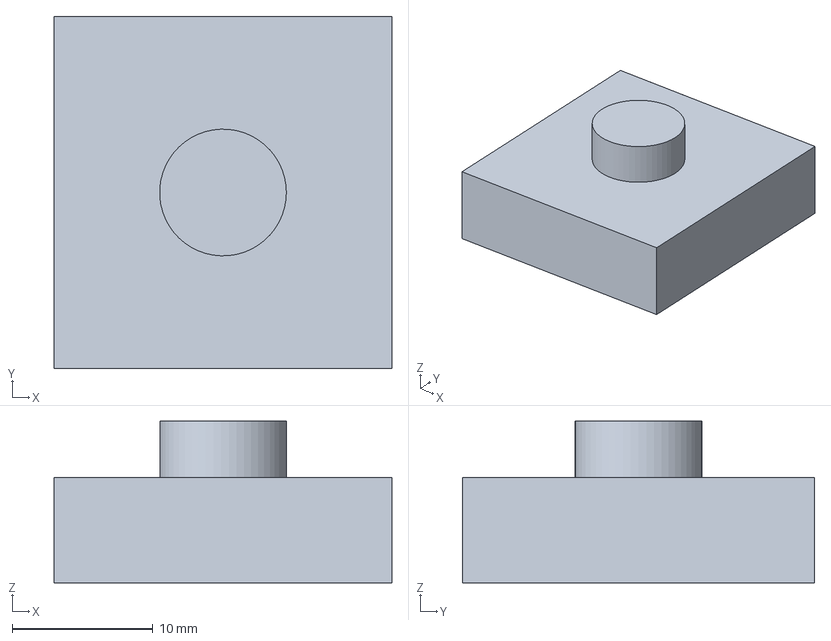
[picture p69: CAD file, 2026-10-12]
cad/exports/S/step/camera_module.step
24.0 x 25.0 x 11.5 mm
