ratul-hasibulkarim/Pipe-crawller/cad/exports/common/step/tether_reel_spool.step

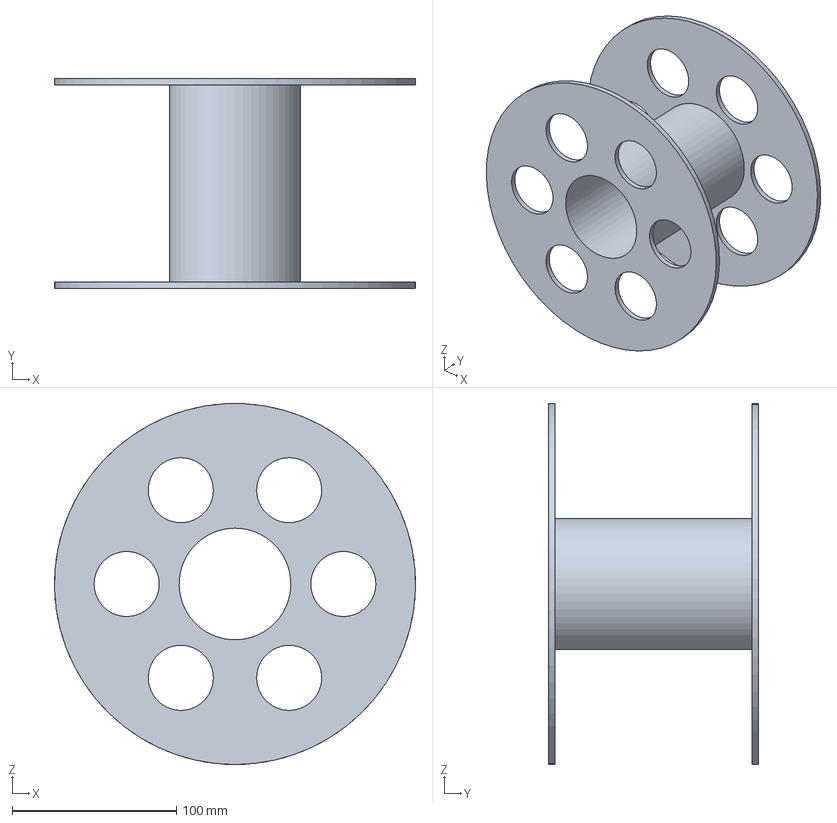
[picture p70: CAD file, 2026-10-12]
cad/exports/common/step/tether_reel_spool.step
219.9 x 128.0 x 220.0 mm
