ratul-hasibulkarim/Pipe-crawller/cad/exports/L/step/battery_caddy.step

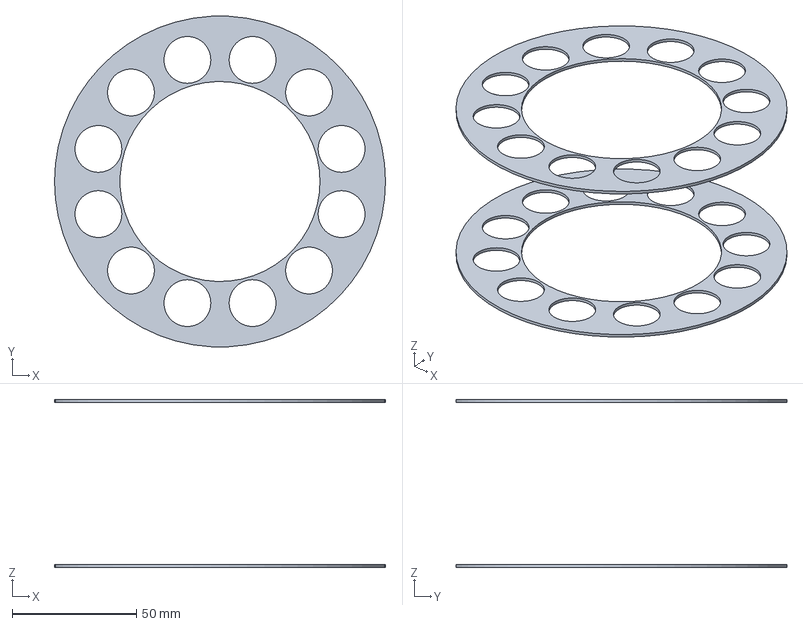
[picture p71: CAD file, 2026-10-12]
cad/exports/L/step/battery_caddy.step
133.0 x 132.8 x 67.6 mm
