ratul-hasibulkarim/Pipe-crawller/cad/exports/M/step/compliance_spring_retainer.step

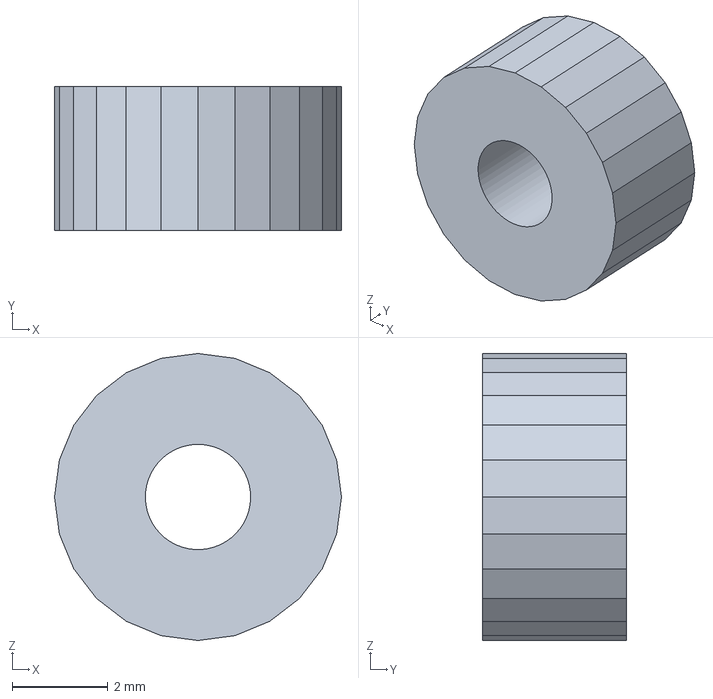
[picture p72: CAD file, 2026-10-12]
cad/exports/M/step/compliance_spring_retainer.step
6.00 x 3.00 x 6.00 mm
