ratul-hasibulkarim/Pipe-crawller/cad/exports/S/step/worm_bearing_block.step

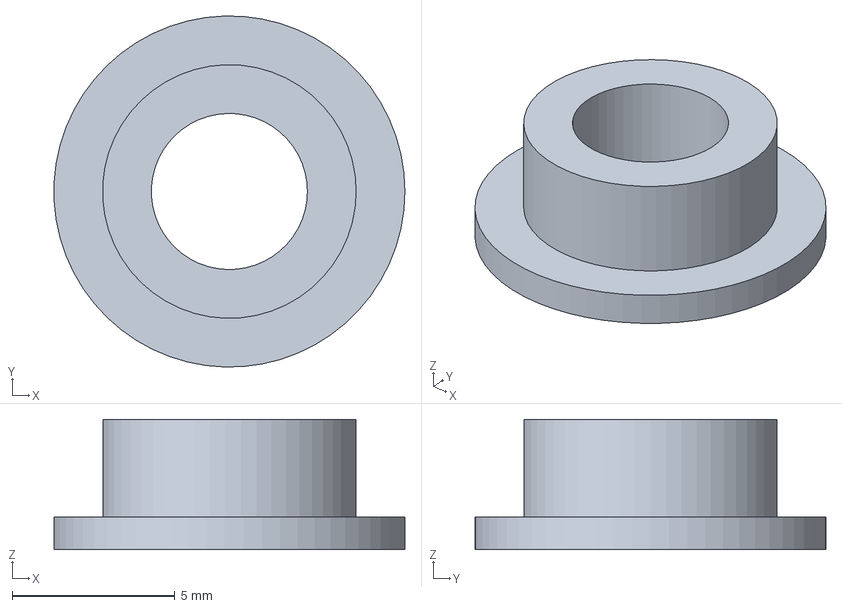
[picture p73: CAD file, 2026-10-12]
cad/exports/S/step/worm_bearing_block.step
10.8 x 10.8 x 4.00 mm
