ratul-hasibulkarim/Pipe-crawller/cad/exports/common/step/tether_reel_axle.step

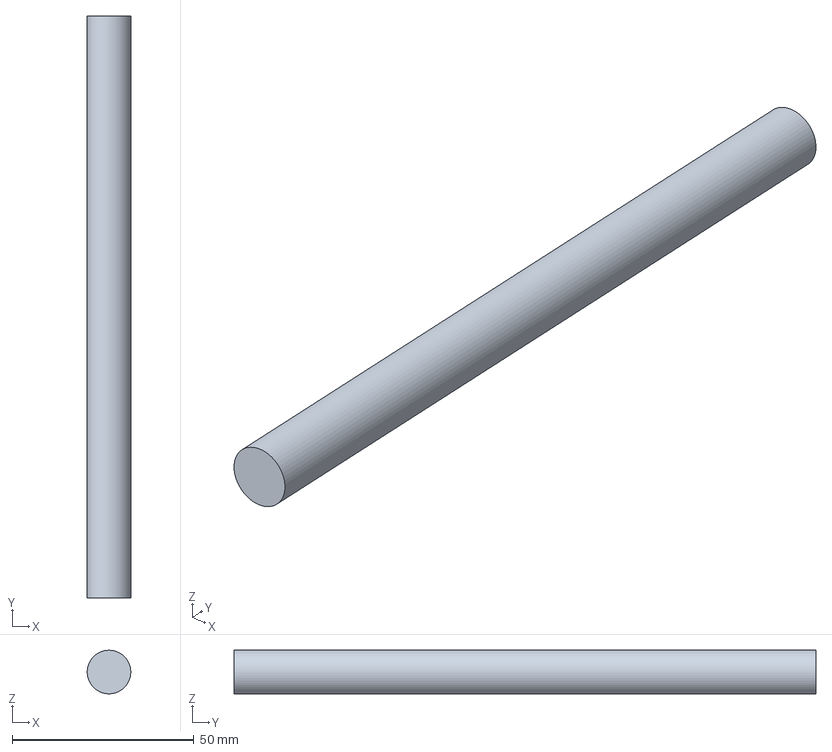
[picture p74: CAD file, 2026-10-12]
cad/exports/common/step/tether_reel_axle.step
12.0 x 160.0 x 12.0 mm
