ratul-hasibulkarim/Pipe-crawller/cad/exports/L/step/wheel_axle.step

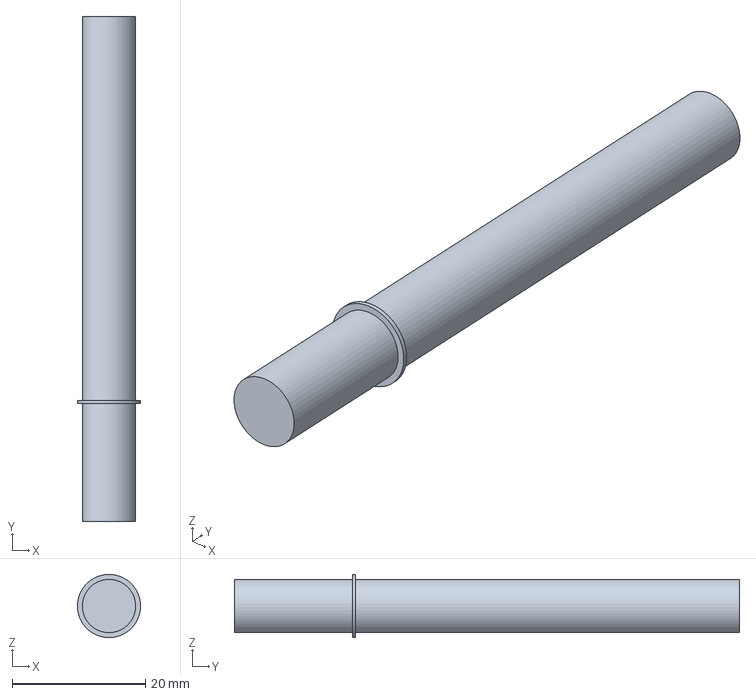
[picture p75: CAD file, 2026-10-12]
cad/exports/L/step/wheel_axle.step
9.50 x 75.9 x 9.49 mm
