ratul-hasibulkarim/Pipe-crawller/cad/exports/M/step/drive_belt_GT2.step

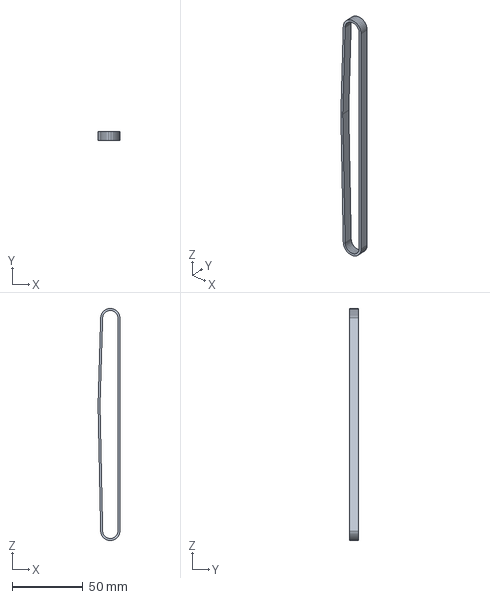
[picture p76: CAD file, 2026-10-12]
cad/exports/M/step/drive_belt_GT2.step
15.4 x 6.00 x 163.6 mm
