ratul-hasibulkarim/Pipe-crawller/cad/exports/S/step/body_front_shell.step

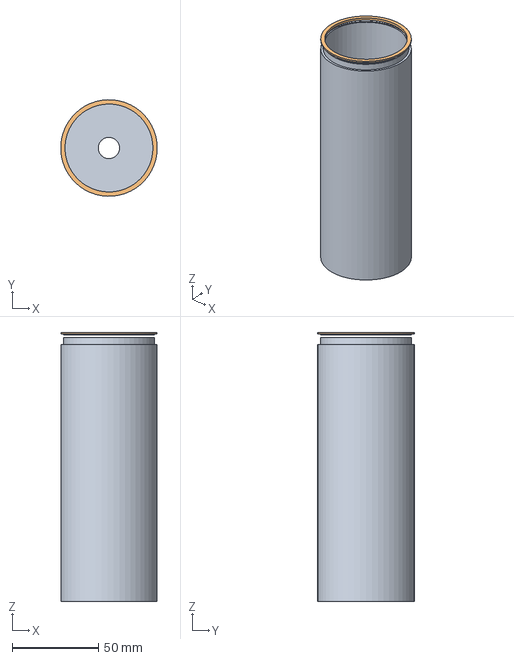
[picture p77: CAD file, 2026-10-12]
cad/exports/S/step/body_front_shell.step
55.9 x 56.0 x 156.0 mm
