ratul-hasibulkarim/Pipe-crawller/cad/exports/common/step/tether_reel_motor_NEMA17.step

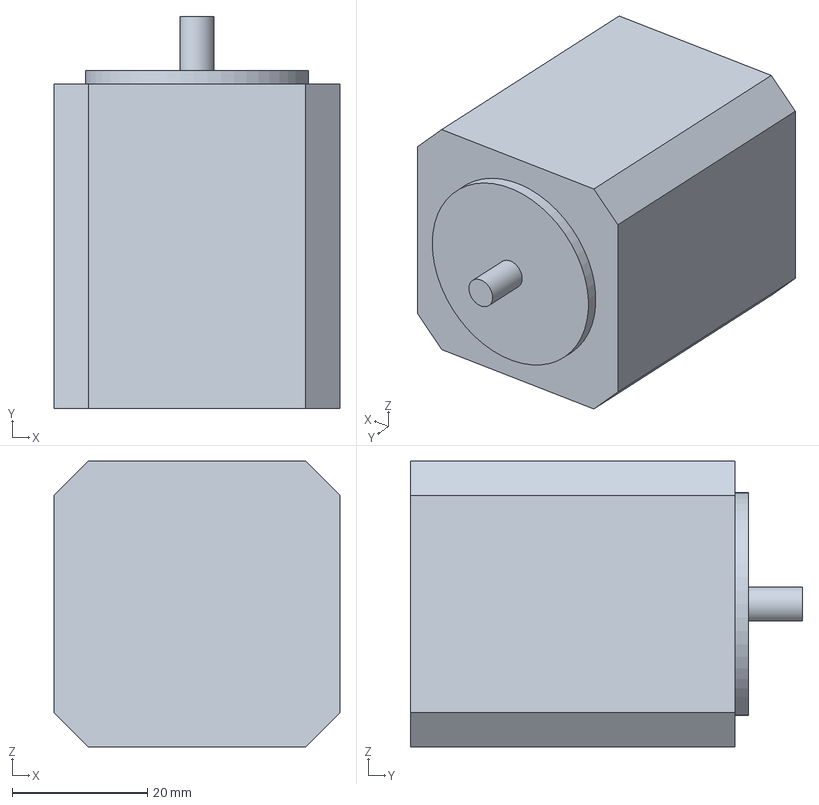
[picture p78: CAD file, 2026-10-12]
cad/exports/common/step/tether_reel_motor_NEMA17.step
42.3 x 58.0 x 42.3 mm
