ratul-hasibulkarim/Pipe-crawller/cad/exports/L/step/worm_sector.step

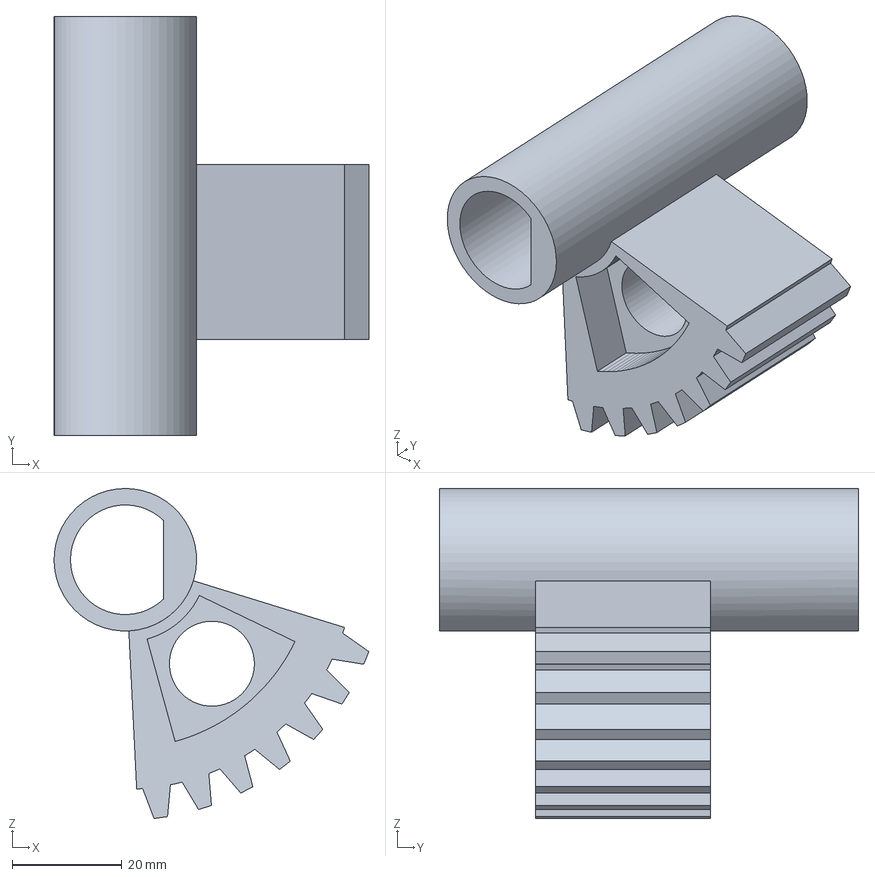
[picture p79: CAD file, 2026-10-12]
cad/exports/L/step/worm_sector.step
57.4 x 76.5 x 60.2 mm
