ratul-hasibulkarim/Pipe-crawller/cad/exports/M/step/tether_strain_relief.step

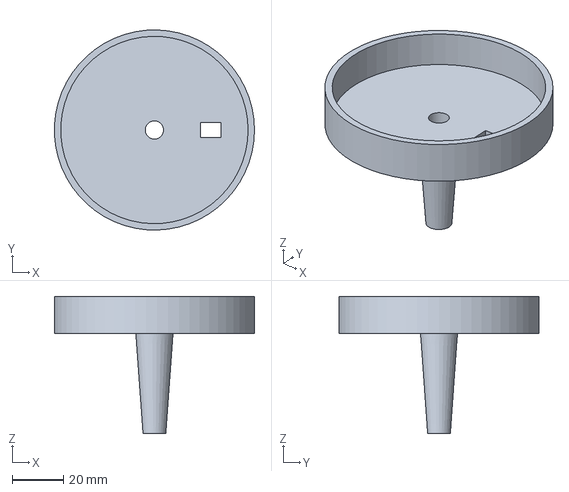
[picture p80: CAD file, 2026-10-12]
cad/exports/M/step/tether_strain_relief.step
77.9 x 78.0 x 53.5 mm
