ratul-hasibulkarim/Pipe-crawller/cad/exports/S/step/gimbal_tilt_cradle.step

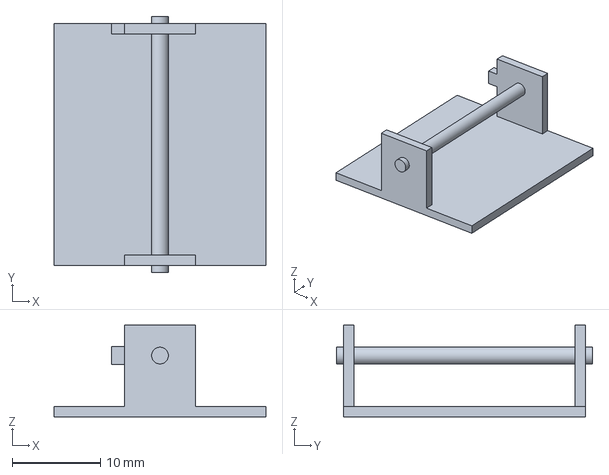
[picture p81: CAD file, 2026-10-12]
cad/exports/S/step/gimbal_tilt_cradle.step
24.0 x 29.0 x 10.4 mm
