ratul-hasibulkarim/Pipe-crawller/cad/exports/common/step/tether_reel_slip_ring.step

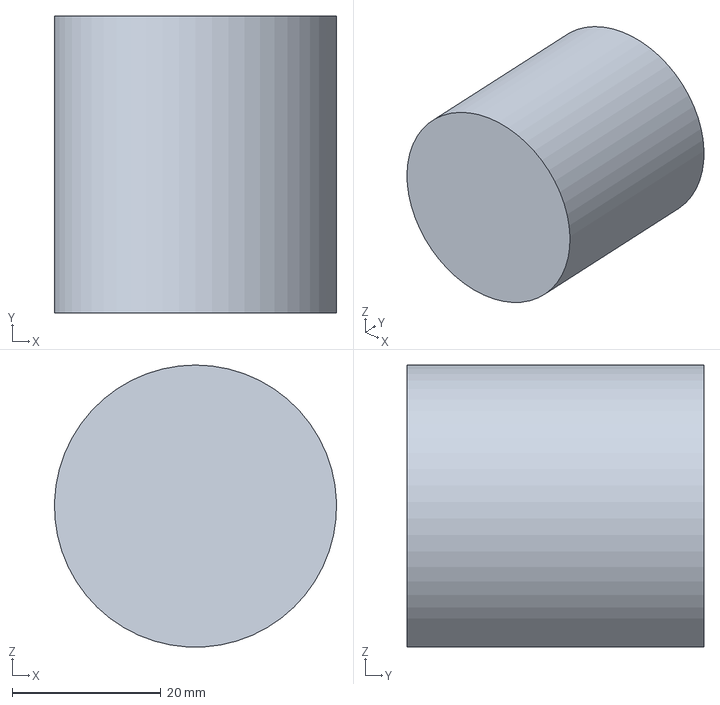
[picture p82: CAD file, 2026-10-12]
cad/exports/common/step/tether_reel_slip_ring.step
38.0 x 40.0 x 38.0 mm
