ratul-hasibulkarim/Pipe-crawller/cad/exports/L/step/tilt_servo_micro.step

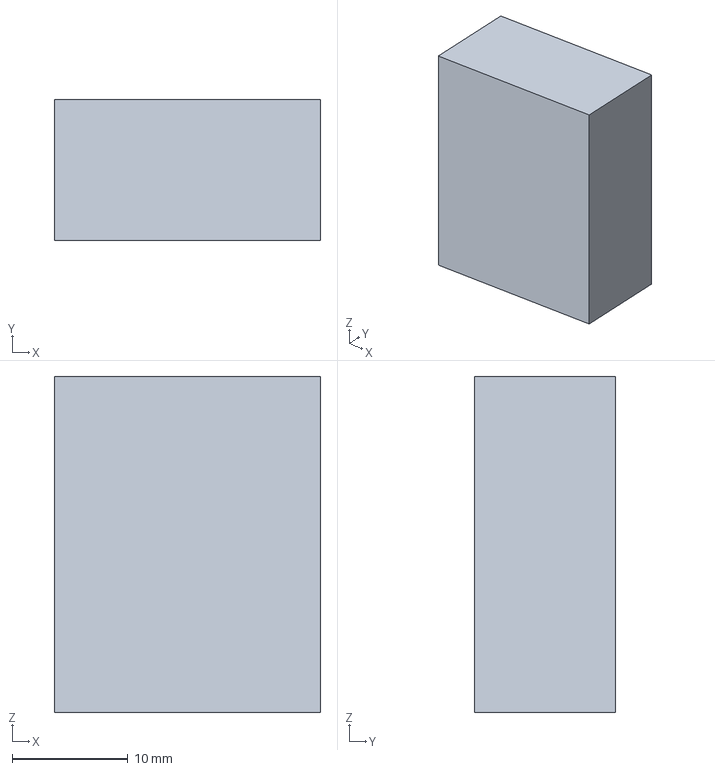
[picture p83: CAD file, 2026-10-12]
cad/exports/L/step/tilt_servo_micro.step
23.0 x 12.2 x 29.0 mm
