ratul-hasibulkarim/Pipe-crawller/cad/exports/S/step/drive_motor_mount.step

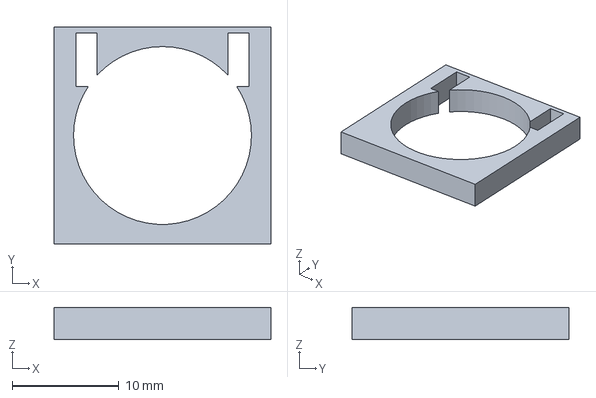
[picture p84: CAD file, 2026-10-12]
cad/exports/S/step/drive_motor_mount.step
20.3 x 20.3 x 3.00 mm
