ratul-hasibulkarim/Pipe-crawller/cad/exports/L/step/tether_strain_relief.step

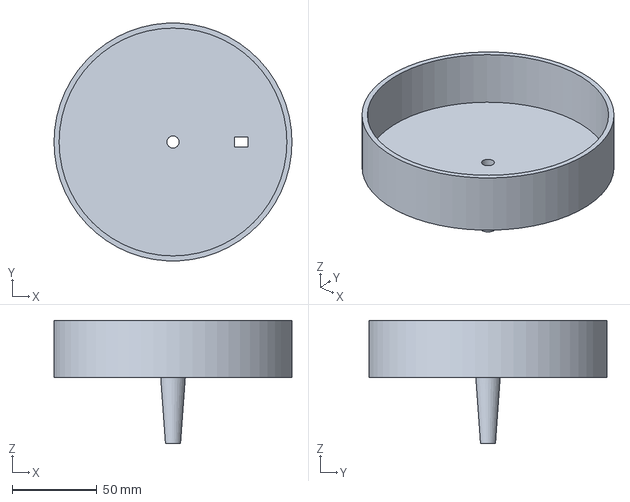
[picture p85: CAD file, 2026-10-12]
cad/exports/L/step/tether_strain_relief.step
140.0 x 139.8 x 72.5 mm
