ratul-hasibulkarim/Pipe-crawller/cad/exports/M/step/pivot_shaft.step

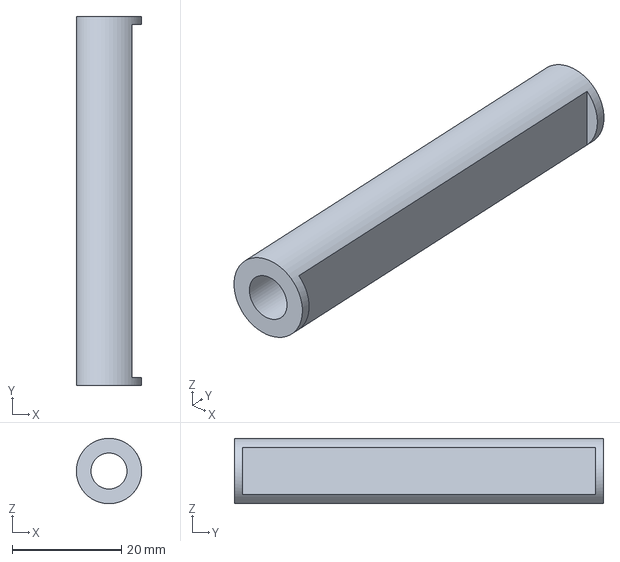
[picture p86: CAD file, 2026-10-12]
cad/exports/M/step/pivot_shaft.step
12.0 x 67.7 x 12.0 mm
