ratul-hasibulkarim/Pipe-crawller/cad/exports/S/step/rocker_plate.step

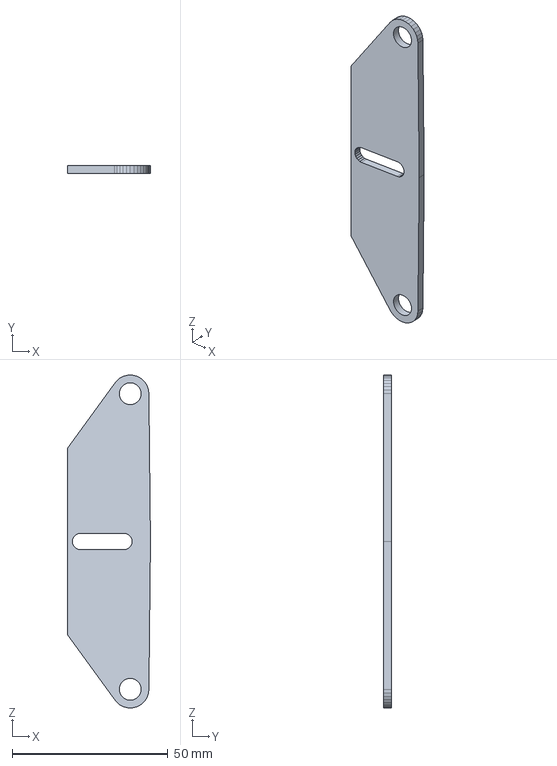
[picture p87: CAD file, 2026-10-12]
cad/exports/S/step/rocker_plate.step
26.6 x 2.50 x 107.0 mm
