ratul-hasibulkarim/Pipe-crawller/cad/exports/L/step/pivot_shaft.step

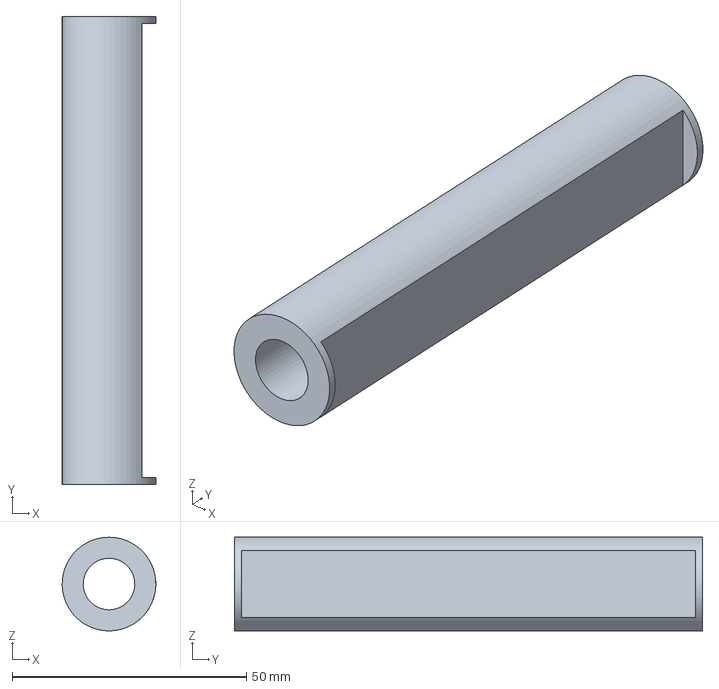
[picture p88: CAD file, 2026-10-12]
cad/exports/L/step/pivot_shaft.step
20.0 x 99.9 x 20.0 mm
