ratul-hasibulkarim/Pipe-crawller/cad/exports/M/step/body_rear_shell.step

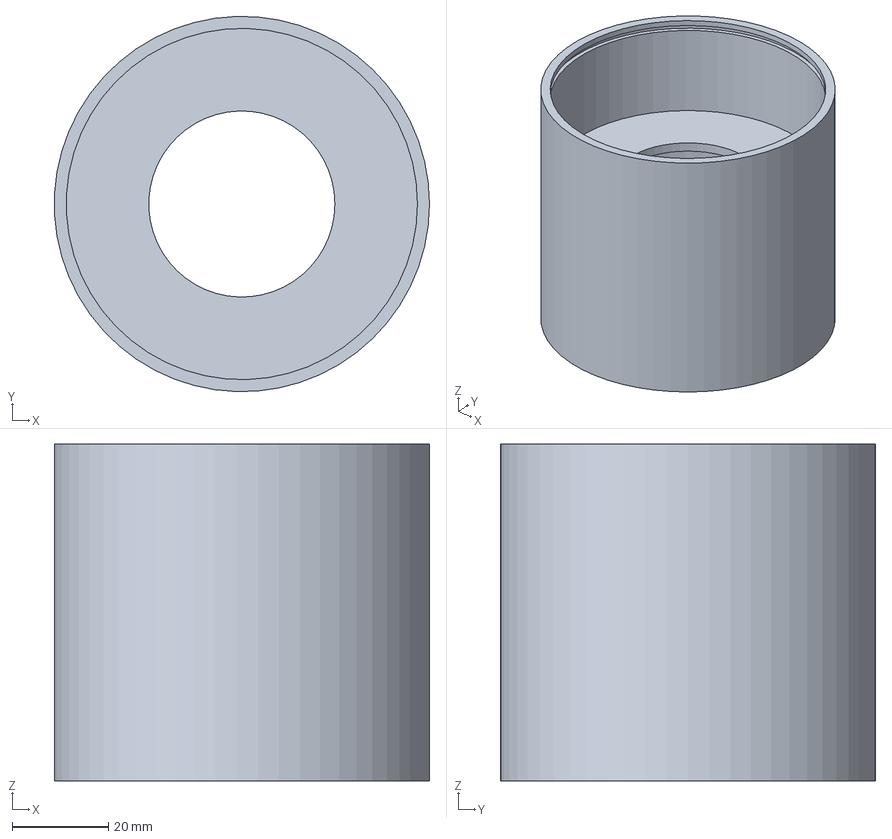
[picture p89: CAD file, 2026-10-12]
cad/exports/M/step/body_rear_shell.step
77.9 x 78.0 x 70.0 mm
