ratul-hasibulkarim/Pipe-crawller/cad/exports/S/step/buck_48v_12v_5v.step

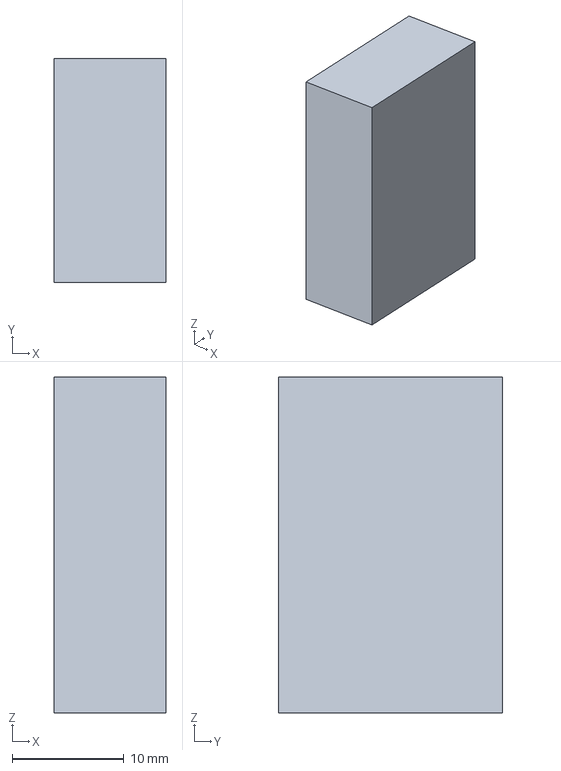
[picture p90: CAD file, 2026-10-12]
cad/exports/S/step/buck_48v_12v_5v.step
10.0 x 20.0 x 30.0 mm
