ratul-hasibulkarim/Pipe-crawller/cad/exports/L/step/bearing_MR128ZZ.step

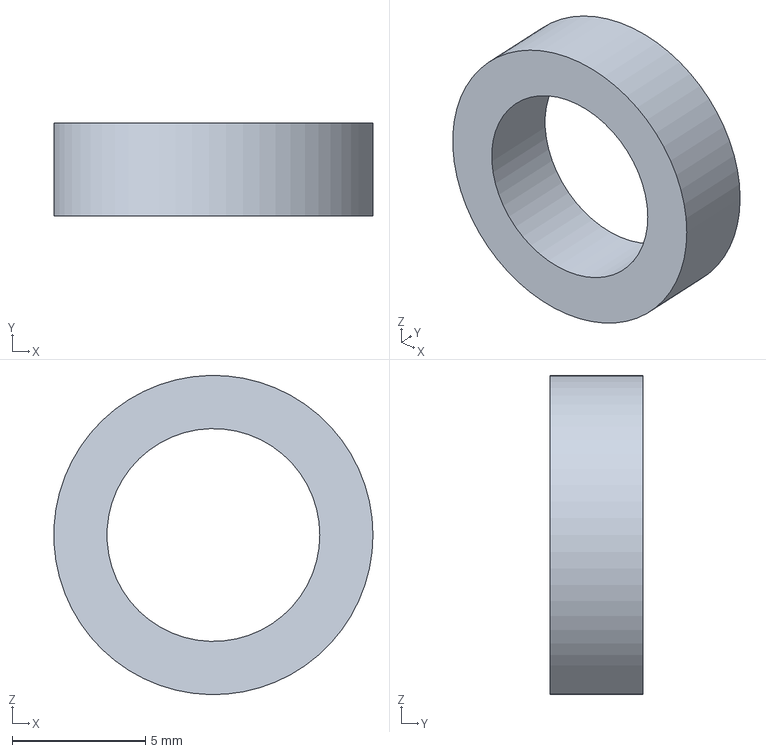
[picture p91: CAD file, 2026-10-12]
cad/exports/L/step/bearing_MR128ZZ.step
12.0 x 3.50 x 12.0 mm
