ratul-hasibulkarim/Pipe-crawller/cad/exports/M/step/planetary_5to1.step

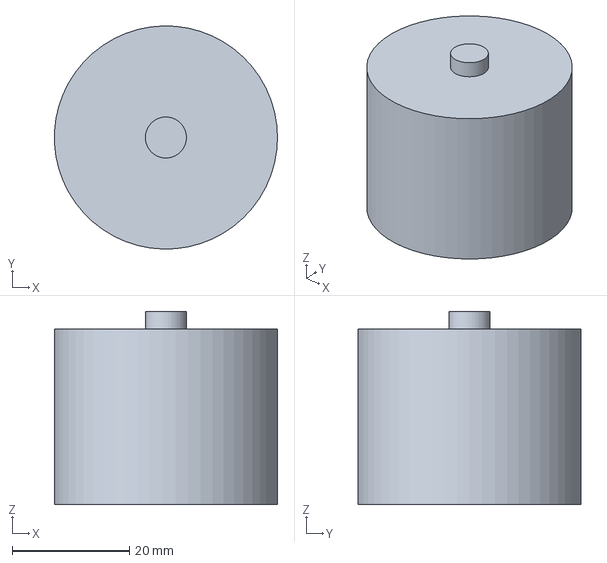
[picture p92: CAD file, 2026-10-12]
cad/exports/M/step/planetary_5to1.step
38.0 x 38.1 x 33.0 mm
