ratul-hasibulkarim/Pipe-crawller/cad/exports/S/step/pan_gearmotor_n20.step

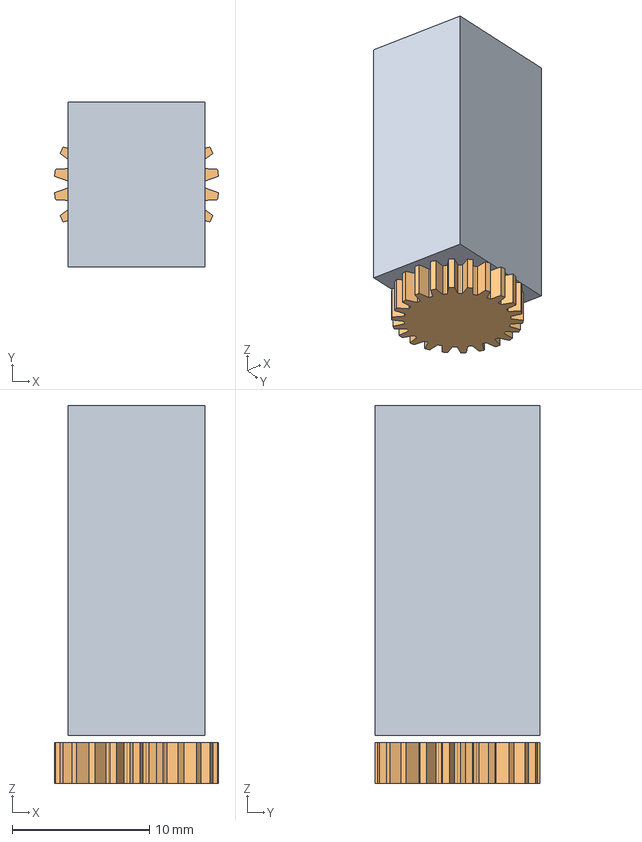
[picture p93: CAD file, 2026-10-12]
cad/exports/S/step/pan_gearmotor_n20.step
11.9 x 12.0 x 27.5 mm
