ratul-hasibulkarim/Pipe-crawller/cad/exports/L/step/bevel_crown.step

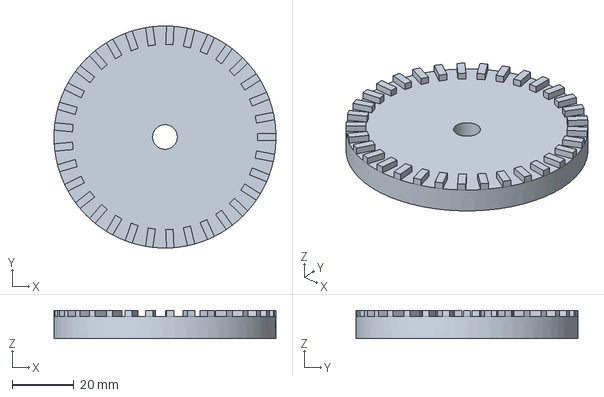
[picture p94: CAD file, 2026-10-12]
cad/exports/L/step/bevel_crown.step
72.0 x 72.0 x 9.20 mm
