ratul-hasibulkarim/Pipe-crawller/cad/exports/M/step/bevel_pinion.step

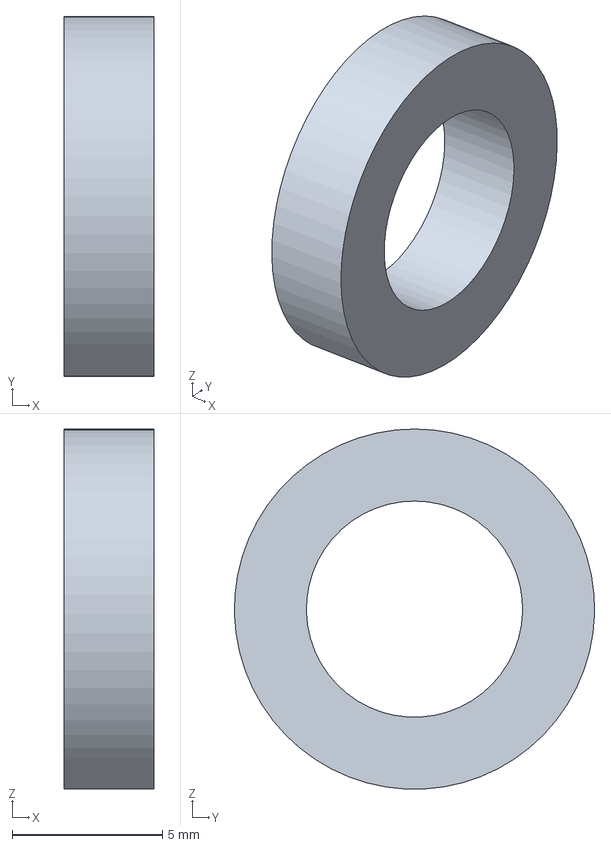
[picture p95: CAD file, 2026-10-12]
cad/exports/M/step/bevel_pinion.step
3.00 x 12.0 x 12.0 mm
