ratul-hasibulkarim/Pipe-crawller/cad/exports/S/step/nose_bumper.step

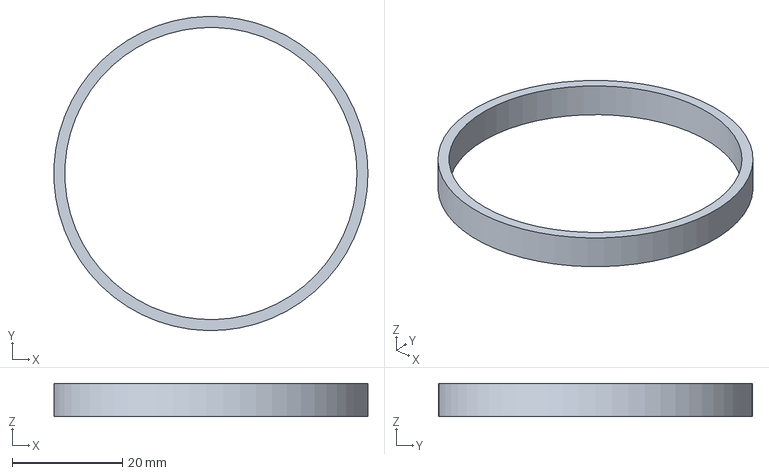
[picture p96: CAD file, 2026-10-12]
cad/exports/S/step/nose_bumper.step
57.0 x 57.0 x 6.00 mm
