ratul-hasibulkarim/Pipe-crawller/cad/exports/L/step/mcu_board_RP2040.step

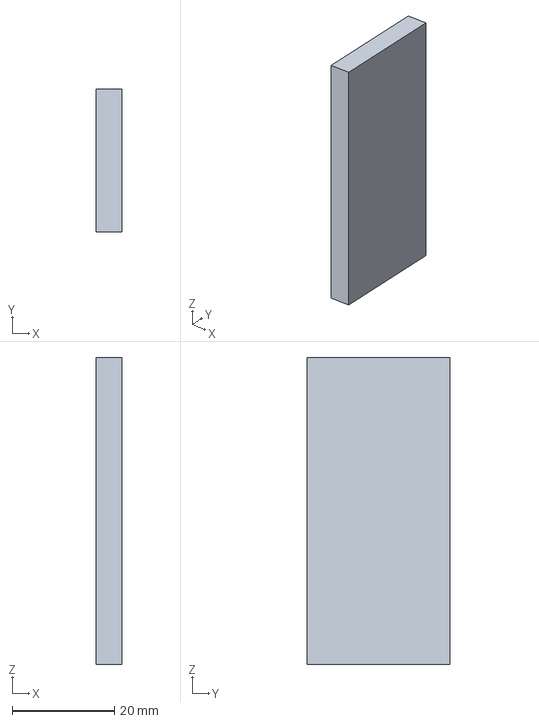
[picture p97: CAD file, 2026-10-12]
cad/exports/L/step/mcu_board_RP2040.step
5.00 x 28.0 x 60.0 mm
