ratul-hasibulkarim/Pipe-crawller/cad/exports/M/step/body_front_shell.step

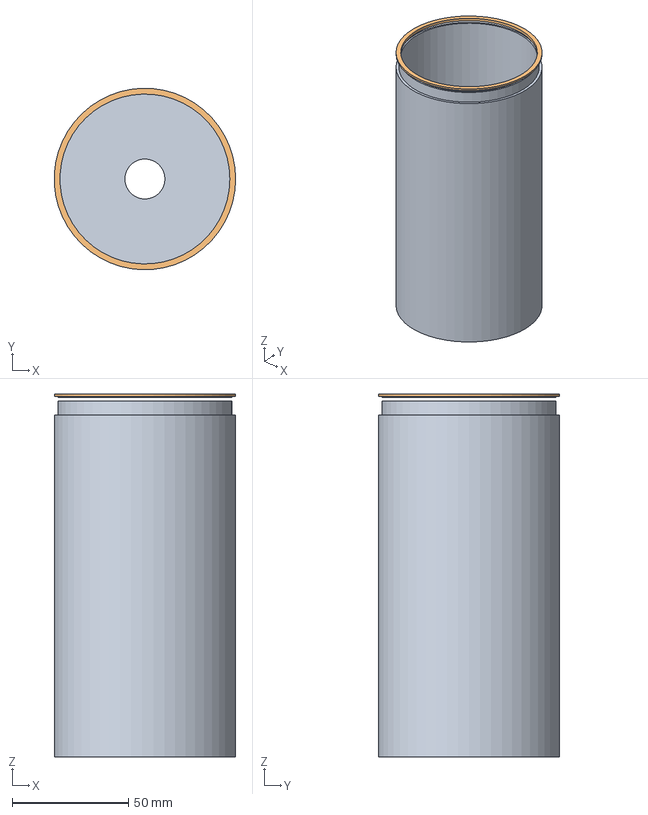
[picture p98: CAD file, 2026-10-12]
cad/exports/M/step/body_front_shell.step
77.9 x 78.0 x 156.0 mm
