ratul-hasibulkarim/Pipe-crawller/cad/exports/S/step/articulation_spider.step

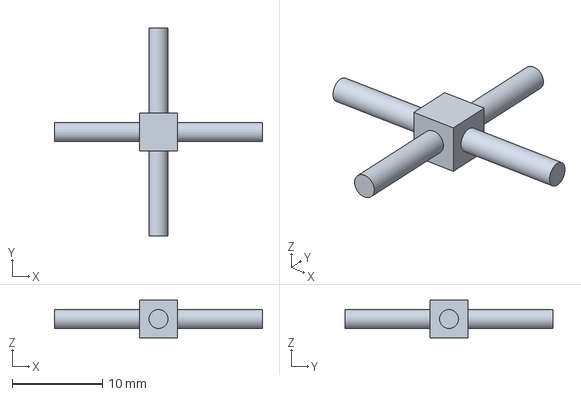
[picture p99: CAD file, 2026-10-12]
cad/exports/S/step/articulation_spider.step
23.0 x 23.0 x 4.20 mm
