ratul-hasibulkarim/Pipe-crawller/cad/exports/L/step/wheel_tread.step

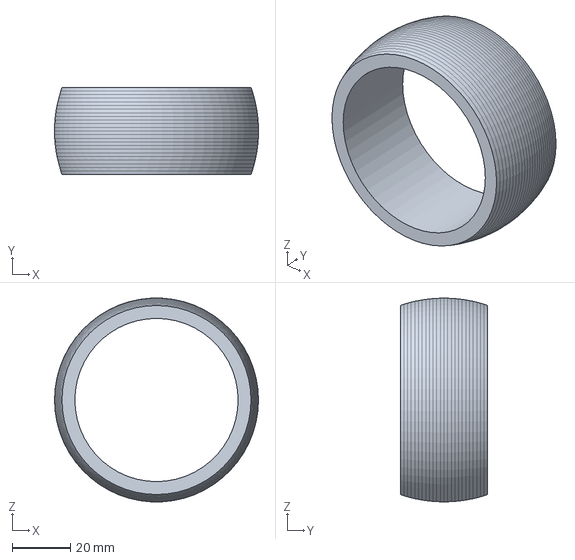
[picture p100: CAD file, 2026-10-12]
cad/exports/L/step/wheel_tread.step
70.0 x 30.0 x 69.9 mm
