ratul-hasibulkarim/Pipe-crawller/cad/exports/M/step/nose_bumper.step

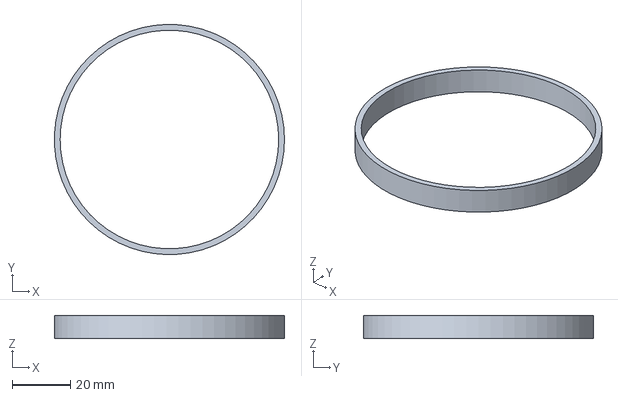
[picture p101: CAD file, 2026-10-12]
cad/exports/M/step/nose_bumper.step
78.9 x 79.0 x 8.00 mm
