ratul-hasibulkarim/Pipe-crawller/cad/exports/S/step/slip_ring_6w.step

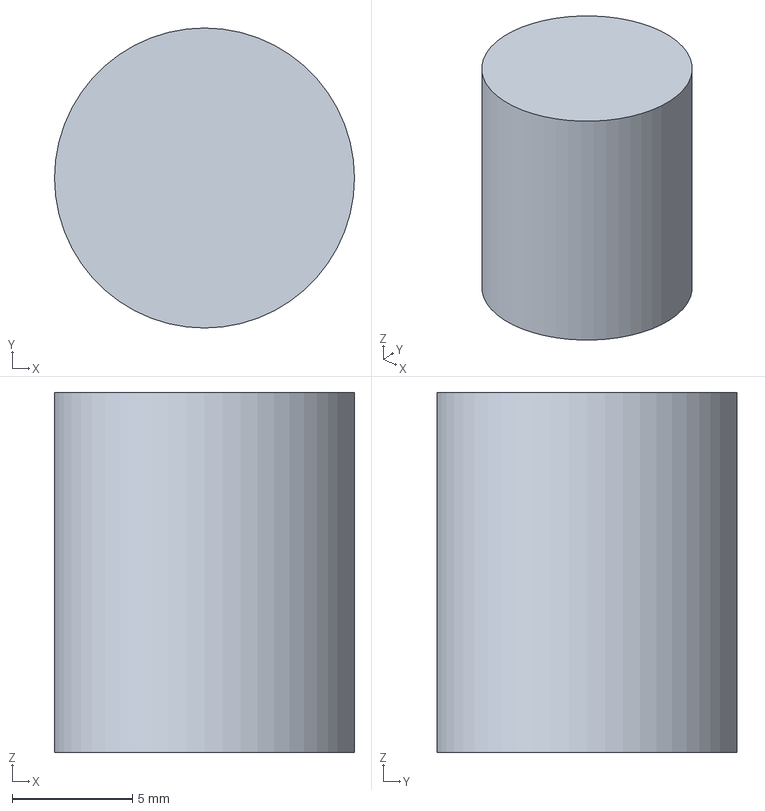
[picture p102: CAD file, 2026-10-12]
cad/exports/S/step/slip_ring_6w.step
12.5 x 12.5 x 15.0 mm
