ratul-hasibulkarim/Pipe-crawller/cad/exports/L/step/articulation_spider.step

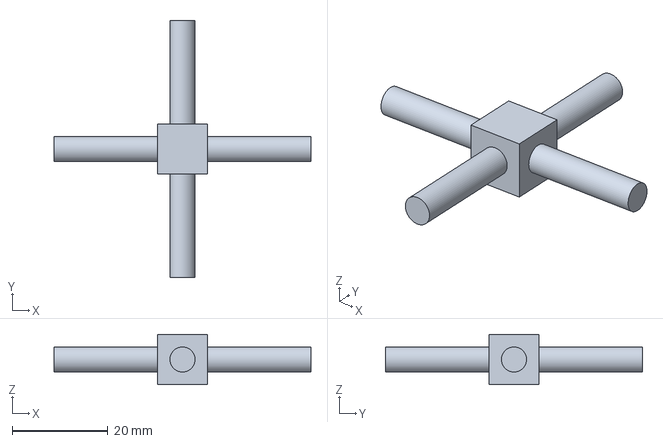
[picture p103: CAD file, 2026-10-12]
cad/exports/L/step/articulation_spider.step
53.7 x 53.7 x 10.5 mm
