ratul-hasibulkarim/Pipe-crawller/cad/exports/M/step/wheel_crown_mold.step

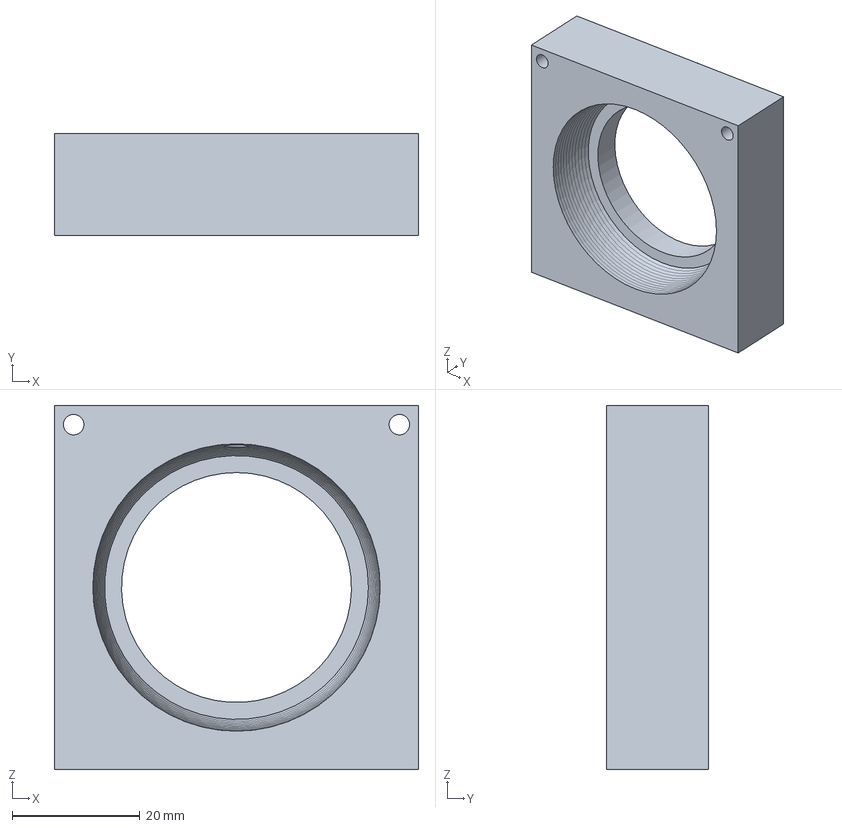
[picture p104: CAD file, 2026-10-12]
cad/exports/M/step/wheel_crown_mold.step
57.0 x 16.0 x 57.0 mm
