ratul-hasibulkarim/Pipe-crawller/cad/exports/L/step/nose_bumper.step

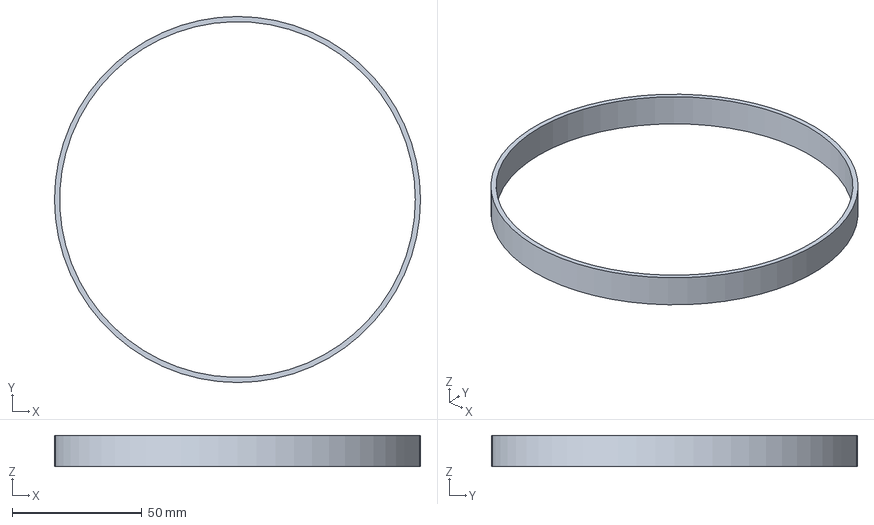
[picture p105: CAD file, 2026-10-12]
cad/exports/L/step/nose_bumper.step
141.0 x 141.0 x 12.0 mm
