ratul-hasibulkarim/Pipe-crawller/cad/exports/M/step/drive_motor_mount.step

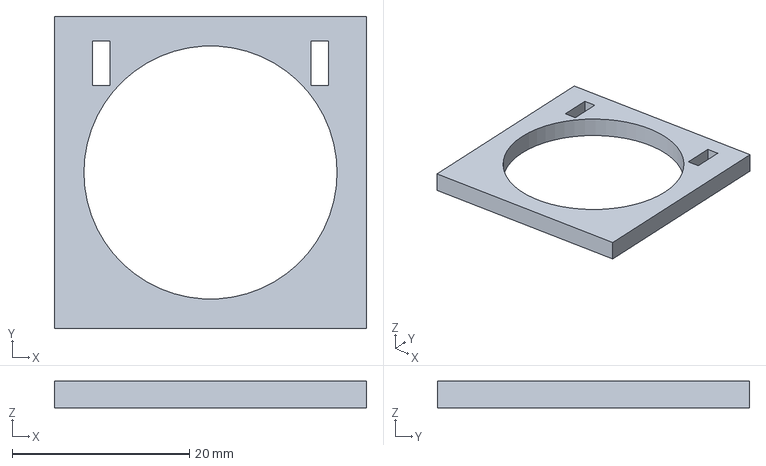
[picture p106: CAD file, 2026-10-12]
cad/exports/M/step/drive_motor_mount.step
35.2 x 35.2 x 3.00 mm
