ratul-hasibulkarim/Pipe-crawller/cad/exports/S/step/led_ring_mount.step

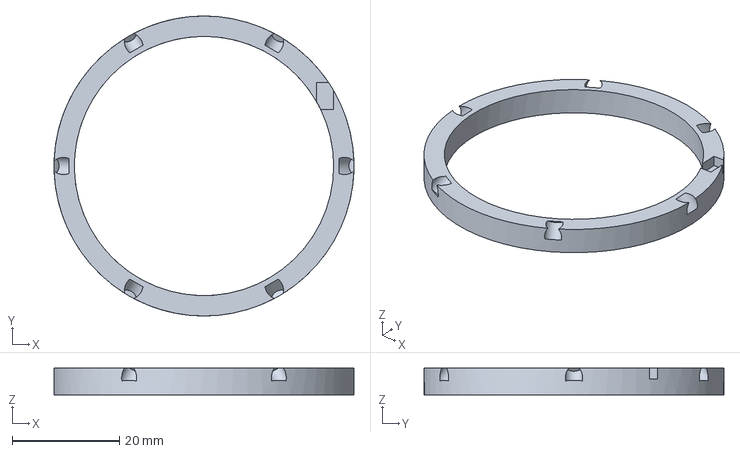
[picture p107: CAD file, 2026-10-12]
cad/exports/S/step/led_ring_mount.step
56.0 x 56.0 x 5.00 mm
