ratul-hasibulkarim/Pipe-crawller/cad/exports/L/step/body_front_shell.step

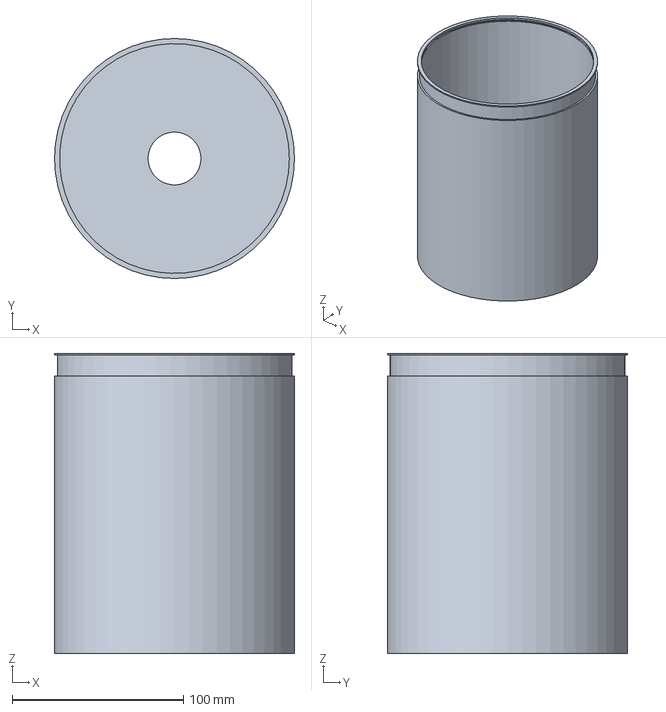
[picture p108: CAD file, 2026-10-12]
cad/exports/L/step/body_front_shell.step
140.0 x 140.0 x 175.0 mm
