ratul-hasibulkarim/Pipe-crawller/cad/exports/S/step/planetary_5to1.step

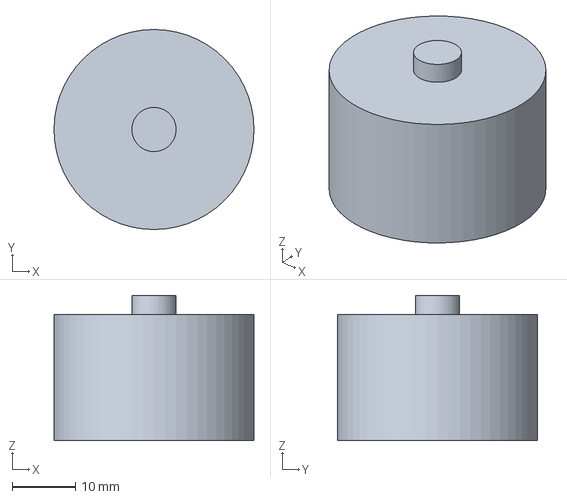
[picture p110: CAD file, 2026-10-12]
cad/exports/S/step/planetary_5to1.step
31.7 x 31.7 x 23.0 mm
