ratul-hasibulkarim/Pipe-crawller/cad/exports/L/step/wheel_hub.step

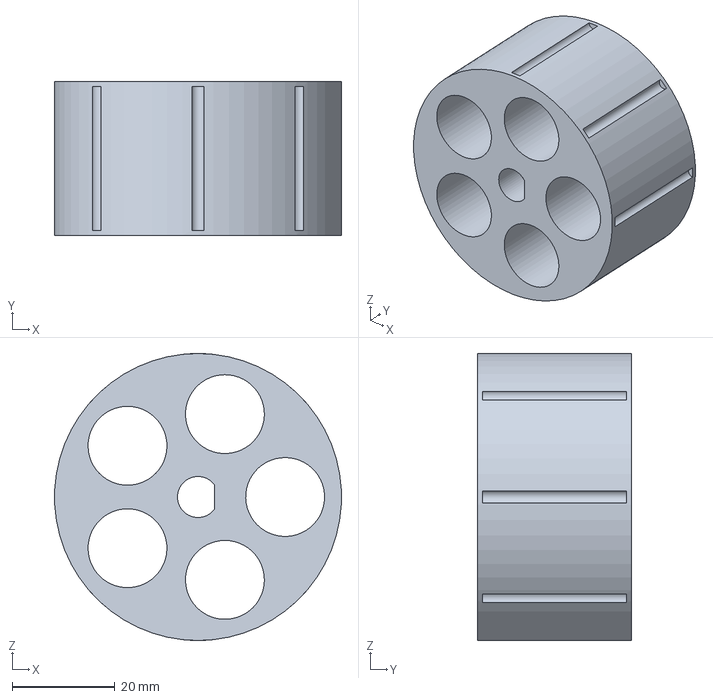
[picture p111: CAD file, 2026-10-12]
cad/exports/L/step/wheel_hub.step
56.0 x 30.0 x 56.0 mm
