ratul-hasibulkarim/Pipe-crawller/cad/exports/M/step/wheel_hub.step

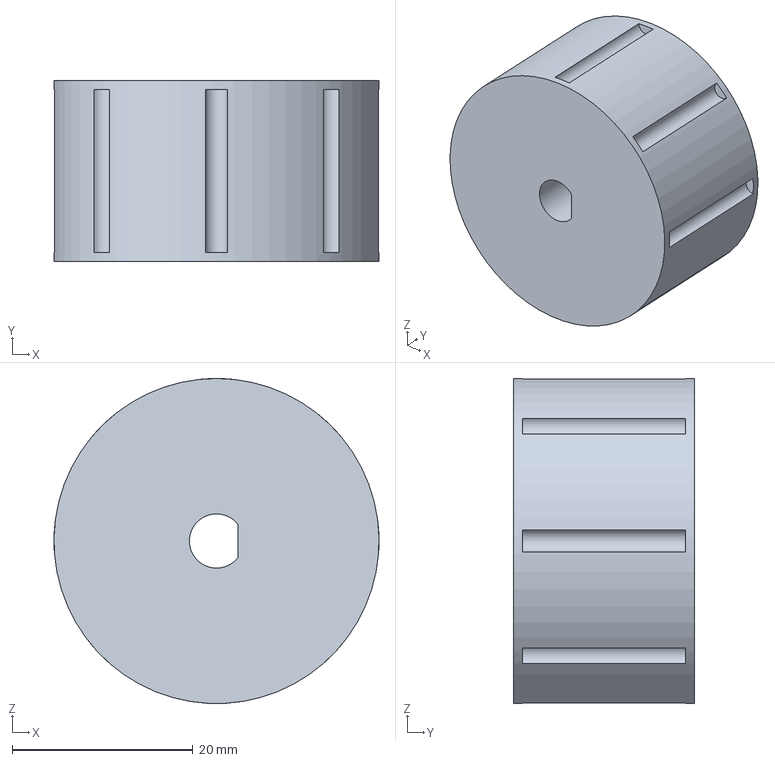
[picture p112: CAD file, 2026-10-12]
cad/exports/M/step/wheel_hub.step
36.0 x 20.0 x 36.0 mm
