ratul-hasibulkarim/Pipe-crawller/cad/exports/S/step/gimbal_pan_yoke.step

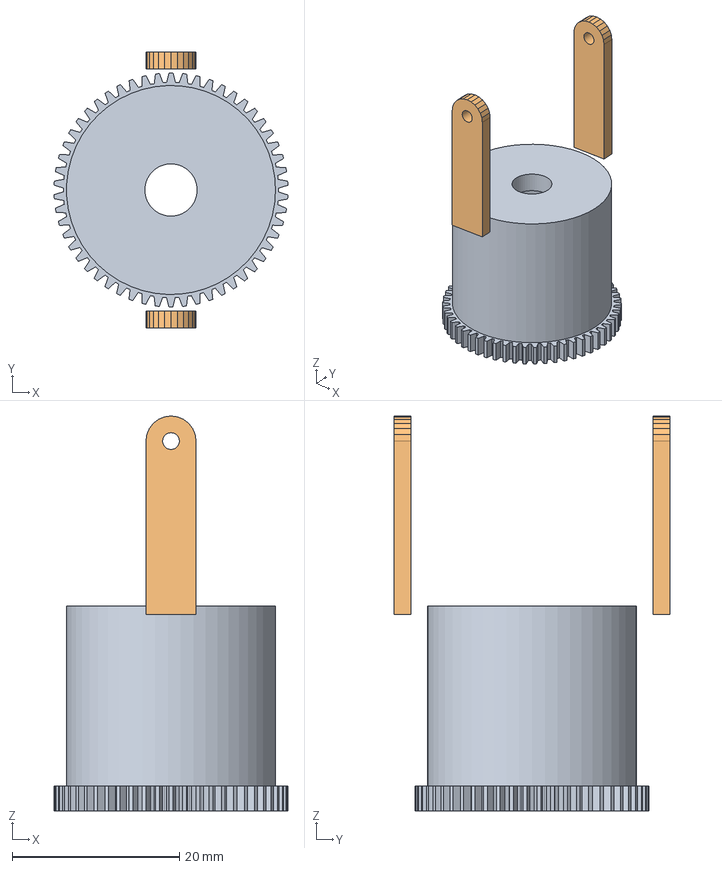
[picture p113: CAD file, 2026-10-12]
cad/exports/S/step/gimbal_pan_yoke.step
28.0 x 33.0 x 47.3 mm
