ratul-hasibulkarim/Pipe-crawller/cad/exports/M/step/wheel_tread.step

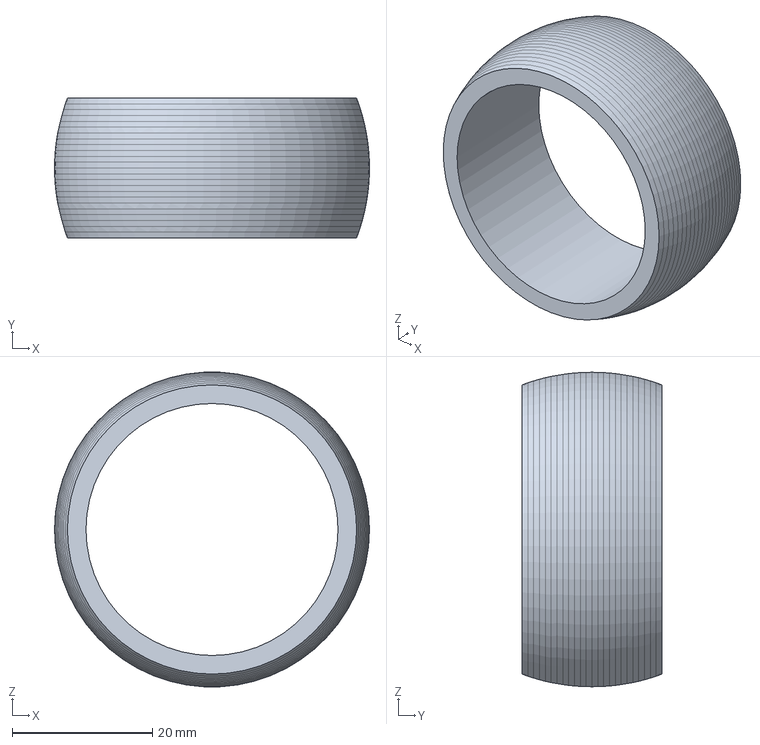
[picture p114: CAD file, 2026-10-12]
cad/exports/M/step/wheel_tread.step
45.0 x 20.0 x 44.9 mm
