ratul-hasibulkarim/Pipe-crawller/cad/exports/S/step/camera_window.step

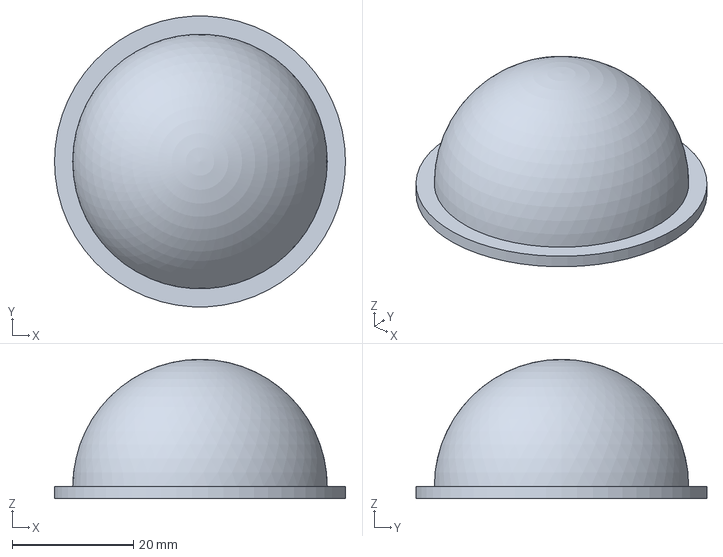
[picture p115: CAD file, 2026-10-12]
cad/exports/S/step/camera_window.step
48.0 x 47.9 x 23.0 mm
