ratul-hasibulkarim/Pipe-crawller/cad/exports/L/step/planetary_10to1.step

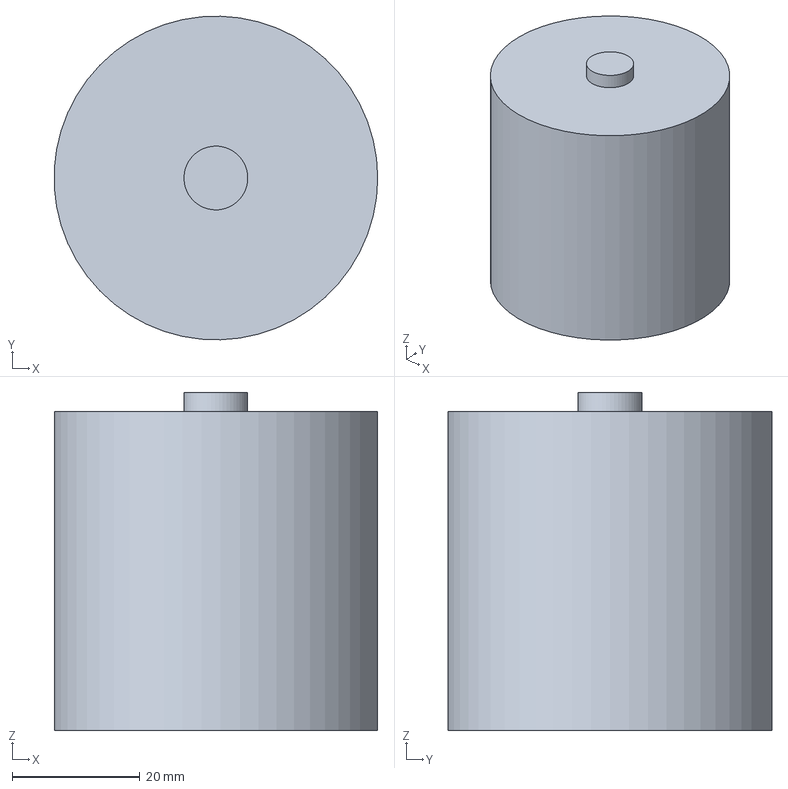
[picture p116: CAD file, 2026-10-12]
cad/exports/L/step/planetary_10to1.step
50.7 x 50.7 x 53.0 mm
