ratul-hasibulkarim/Pipe-crawller/cad/exports/M/step/compute_CM4.step

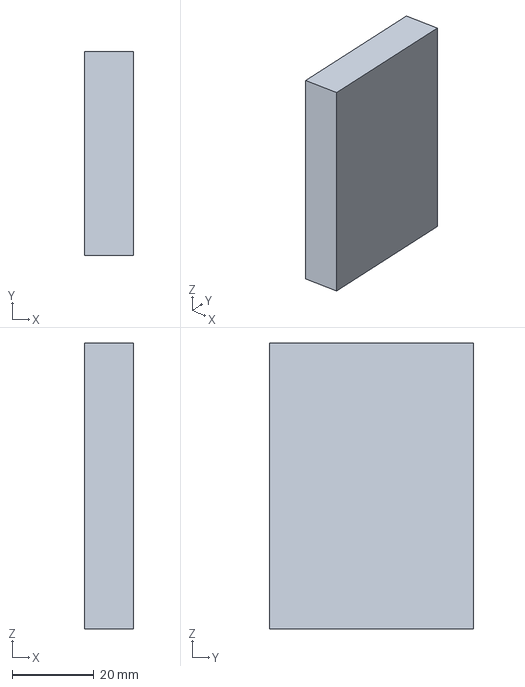
[picture p117: CAD file, 2026-10-12]
cad/exports/M/step/compute_CM4.step
12.0 x 50.0 x 70.0 mm
