ratul-hasibulkarim/Pipe-crawller/cad/exports/S/step/drive_worm_gearbox_35to1.step

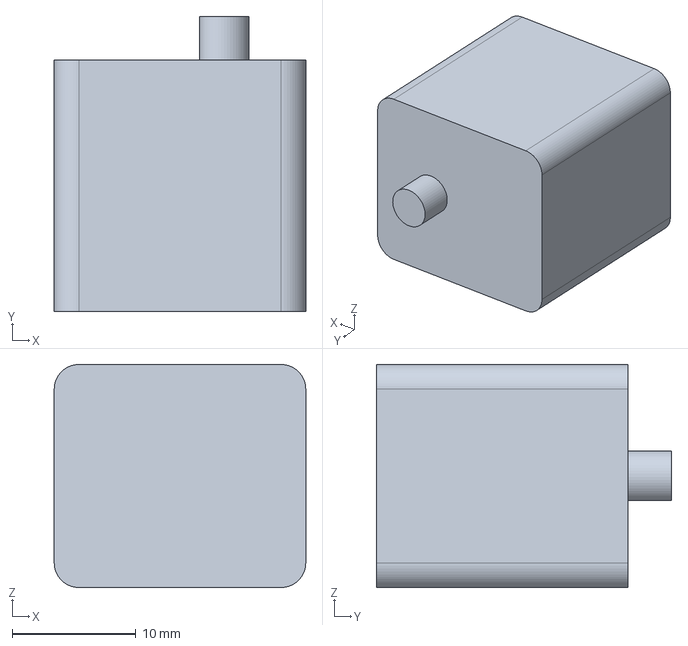
[picture p118: CAD file, 2026-10-12]
cad/exports/S/step/drive_worm_gearbox_35to1.step
20.3 x 23.8 x 18.0 mm
