ratul-hasibulkarim/Pipe-crawller/cad/exports/L/step/service_hatch_gasket.step

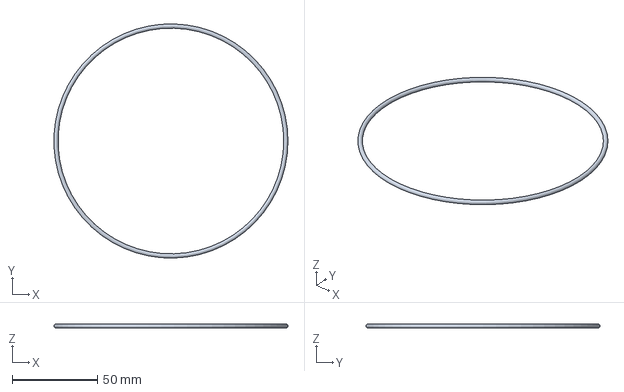
[picture p119: CAD file, 2026-10-12]
cad/exports/L/step/service_hatch_gasket.step
137.0 x 137.0 x 2.50 mm
