ratul-hasibulkarim/Pipe-crawller/cad/exports/M/step/pipe_size_adapter.step

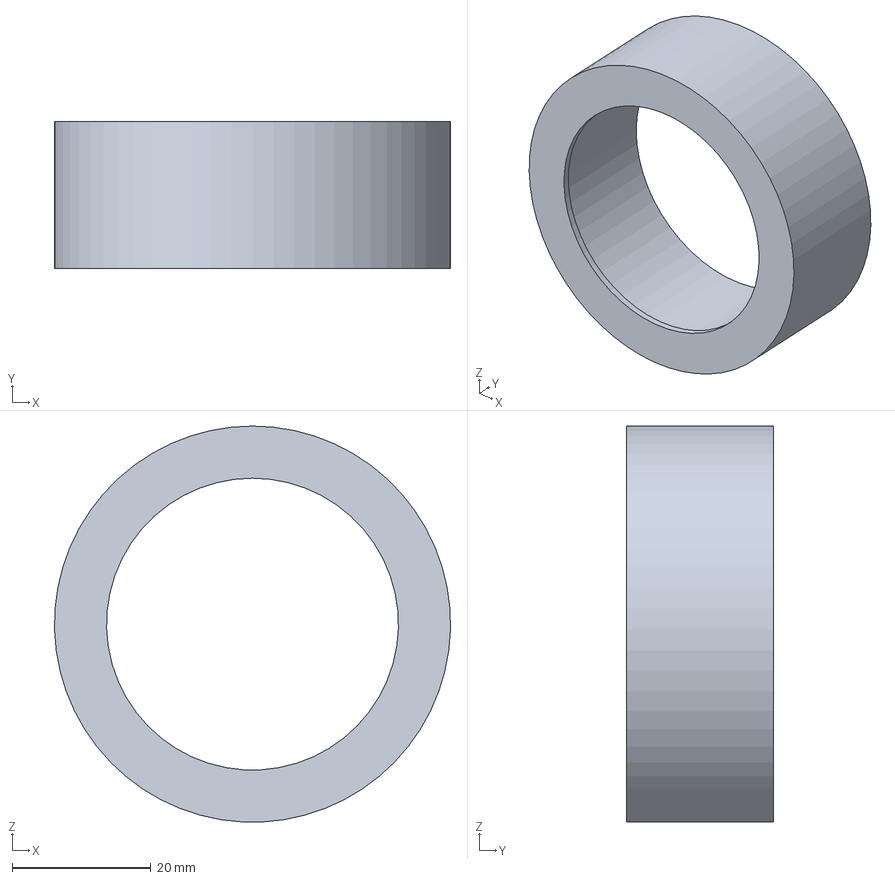
[picture p120: CAD file, 2026-10-12]
cad/exports/M/step/pipe_size_adapter.step
57.0 x 21.2 x 57.0 mm
