ratul-hasibulkarim/Pipe-crawller/cad/exports/S/step/wheel_crown_mold.step

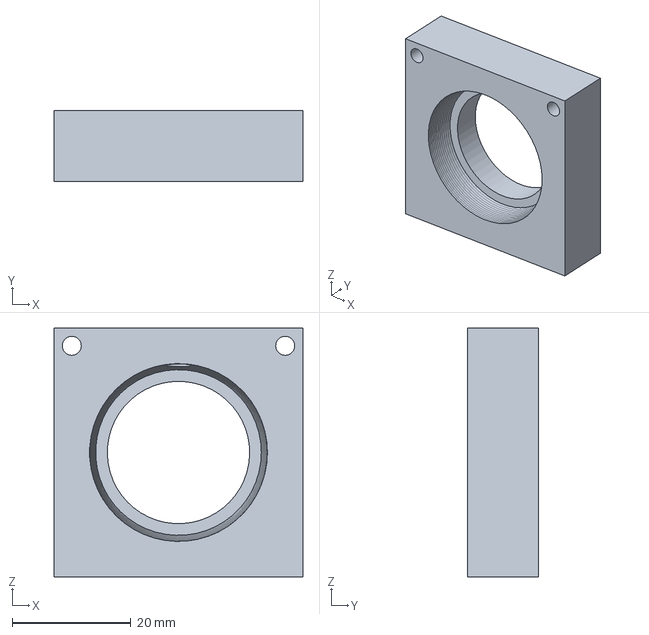
[picture p121: CAD file, 2026-10-12]
cad/exports/S/step/wheel_crown_mold.step
42.0 x 12.0 x 42.0 mm
