ratul-hasibulkarim/Pipe-crawller/cad/exports/L/step/pipe_size_adapter.step

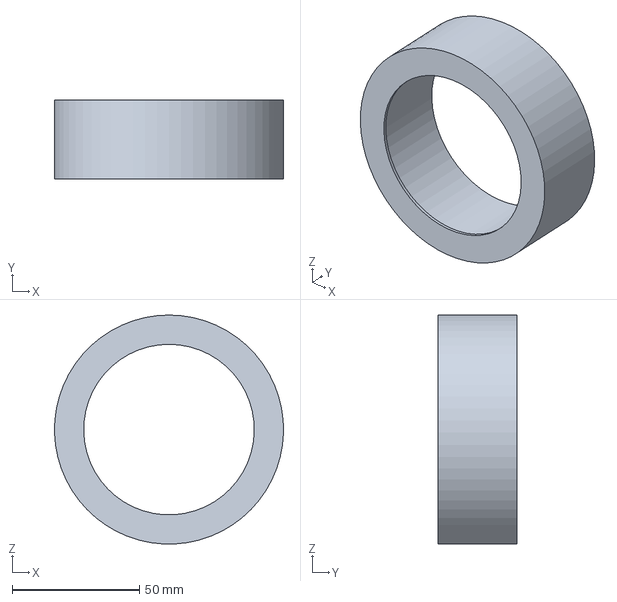
[picture p122: CAD file, 2026-10-12]
cad/exports/L/step/pipe_size_adapter.step
90.0 x 31.2 x 89.9 mm
