ratul-hasibulkarim/Pipe-crawller/cad/exports/M/step/worm_sector.step

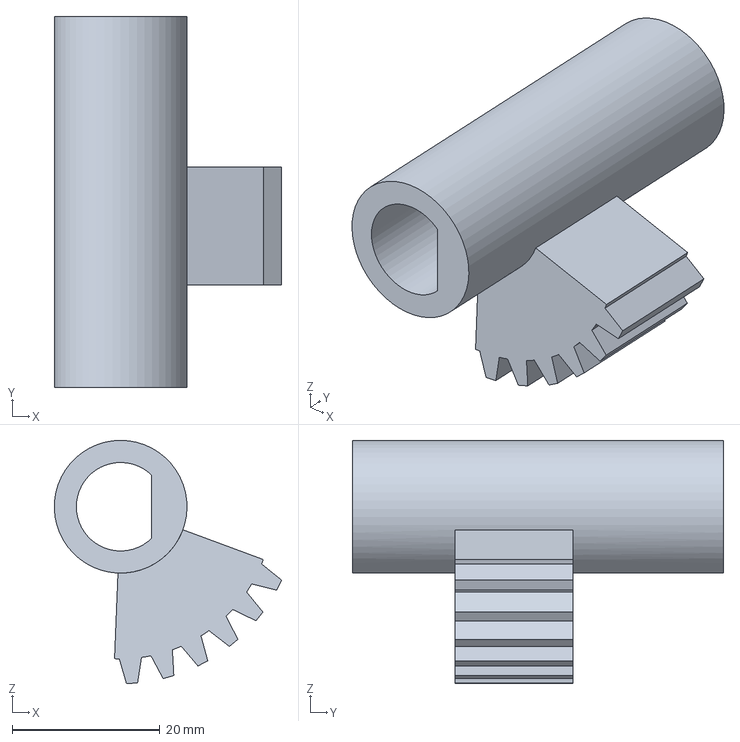
[picture p123: CAD file, 2026-10-12]
cad/exports/M/step/worm_sector.step
30.8 x 50.3 x 33.0 mm
