ratul-hasibulkarim/Pipe-crawller/cad/exports/S/step/articulation_yoke_front.step

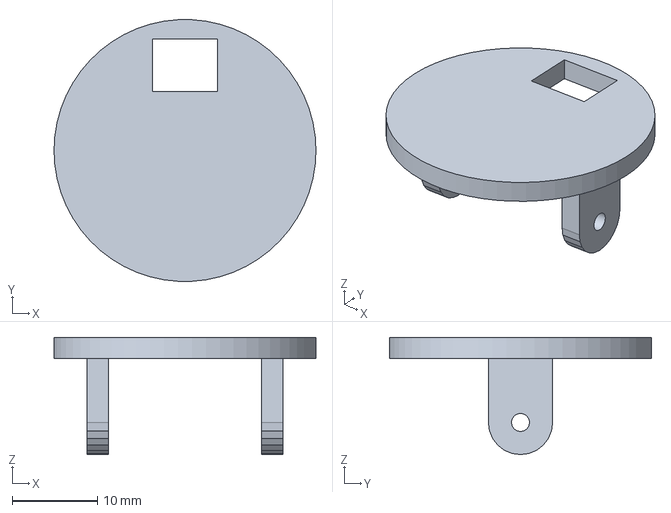
[picture p124: CAD file, 2026-10-12]
cad/exports/S/step/articulation_yoke_front.step
30.8 x 30.8 x 13.8 mm
