ratul-hasibulkarim/Pipe-crawller/cad/exports/M/step/body_mid_chassis.step

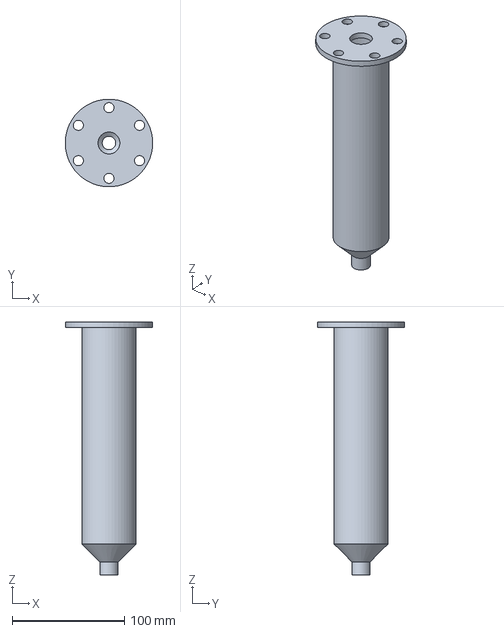
[picture p125: CAD file, 2026-10-12]
cad/exports/M/step/body_mid_chassis.step
77.9 x 78.0 x 225.5 mm
