ratul-hasibulkarim/Pipe-crawller/cad/exports/S/step/compute_Pi_Zero_2_W.step

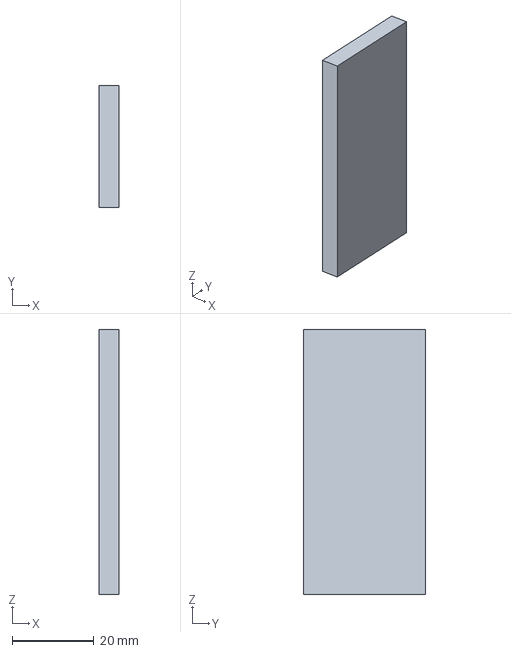
[picture p126: CAD file, 2026-10-12]
cad/exports/S/step/compute_Pi_Zero_2_W.step
5.00 x 30.0 x 65.0 mm
