ratul-hasibulkarim/Pipe-crawller/cad/exports/L/step/wheel_crown_mold.step

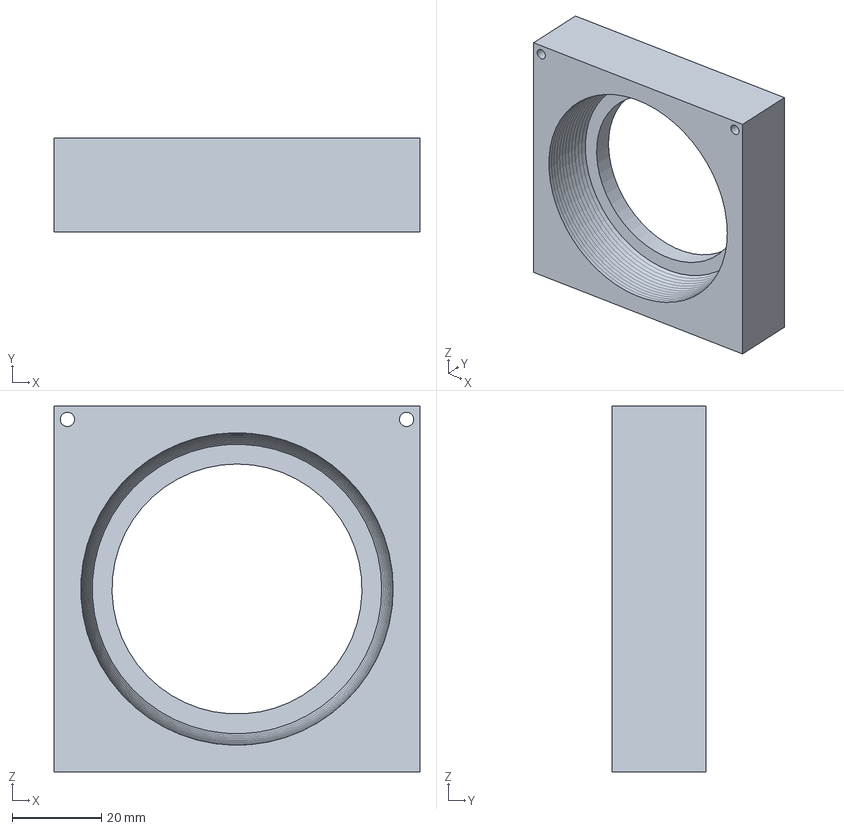
[picture p127: CAD file, 2026-10-12]
cad/exports/L/step/wheel_crown_mold.step
82.0 x 21.0 x 82.0 mm
