ratul-hasibulkarim/Pipe-crawller/cad/exports/M/step/tilt_servo_nano.step

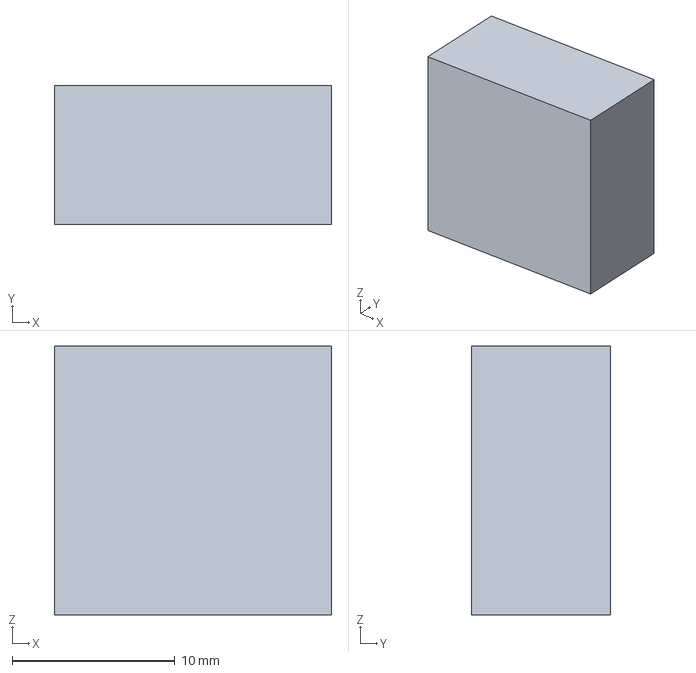
[picture p128: CAD file, 2026-10-12]
cad/exports/M/step/tilt_servo_nano.step
17.0 x 8.50 x 16.5 mm
