ratul-hasibulkarim/Pipe-crawller/cad/exports/S/step/drive_belt_GT2.step

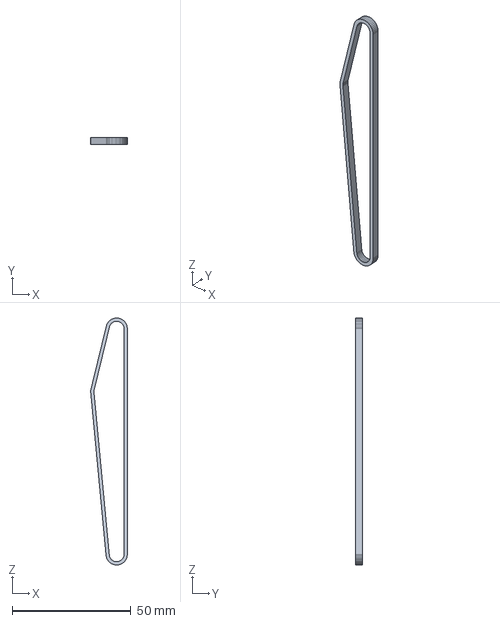
[picture p129: CAD file, 2026-10-12]
cad/exports/S/step/drive_belt_GT2.step
15.4 x 3.00 x 104.0 mm
