ratul-hasibulkarim/Pipe-crawller/cad/exports/L/step/compliance_spring_retainer.step

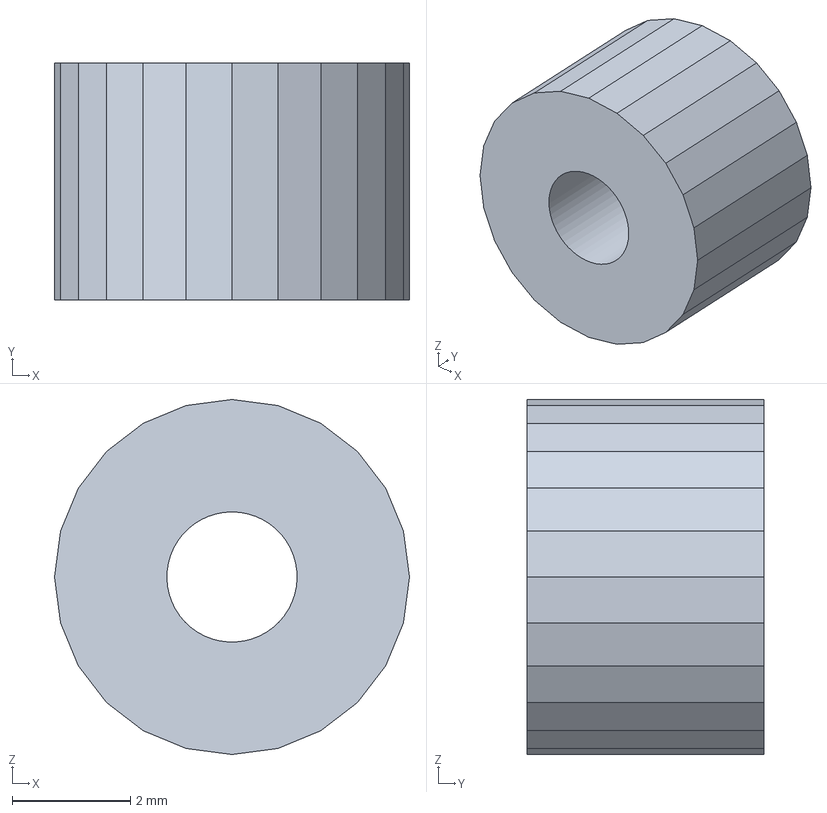
[picture p130: CAD file, 2026-10-12]
cad/exports/L/step/compliance_spring_retainer.step
6.00 x 4.00 x 6.00 mm
