ratul-hasibulkarim/Pipe-crawller/cad/exports/M/step/electronics_tray.step

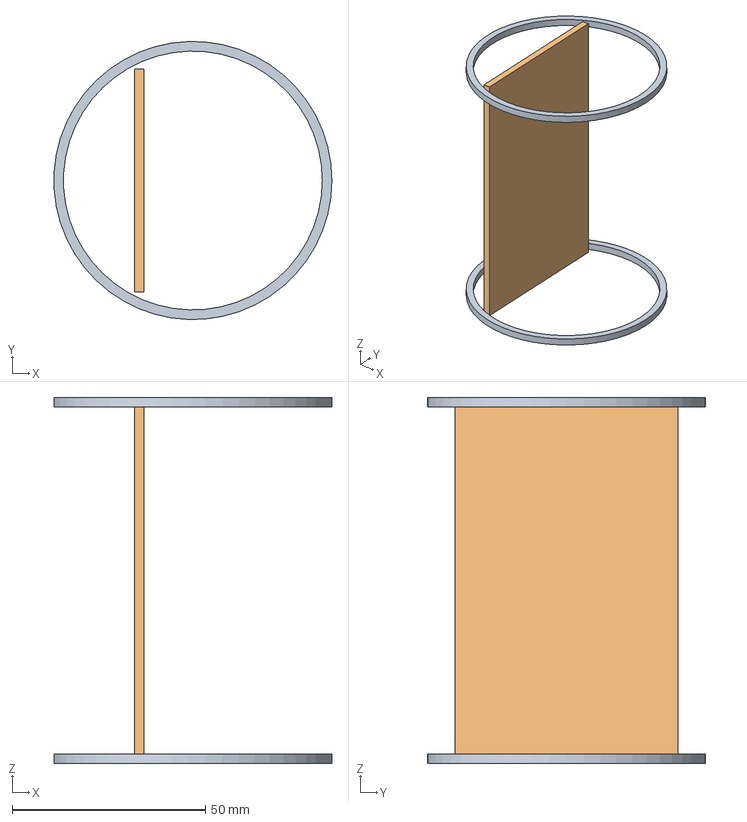
[picture p131: CAD file, 2026-10-12]
cad/exports/M/step/electronics_tray.step
71.9 x 72.0 x 94.7 mm
