ratul-hasibulkarim/Pipe-crawller/cad/exports/S/step/joint_boot.step

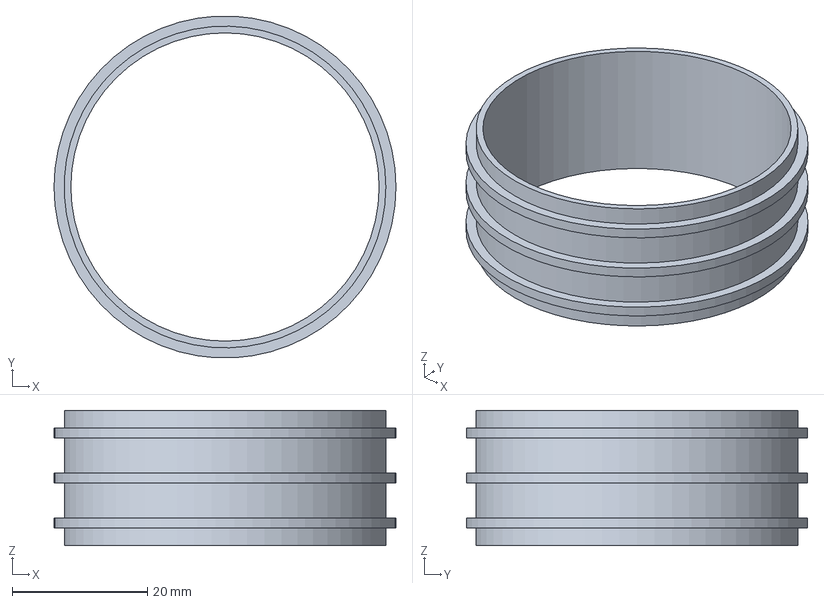
[picture p132: CAD file, 2026-10-12]
cad/exports/S/step/joint_boot.step
50.6 x 50.5 x 20.0 mm
