ratul-hasibulkarim/Pipe-crawller/cad/exports/L/step/worm_bearing_block.step

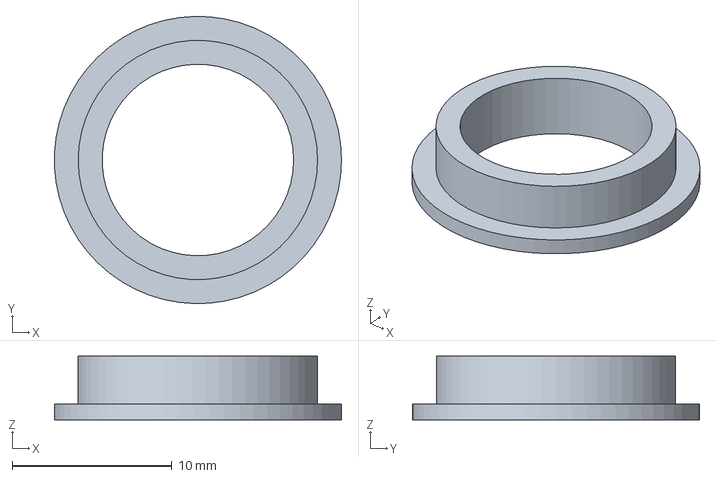
[picture p133: CAD file, 2026-10-12]
cad/exports/L/step/worm_bearing_block.step
18.0 x 18.0 x 4.00 mm
