ratul-hasibulkarim/Pipe-crawller/cad/exports/M/step/gearbox_bulkhead.step

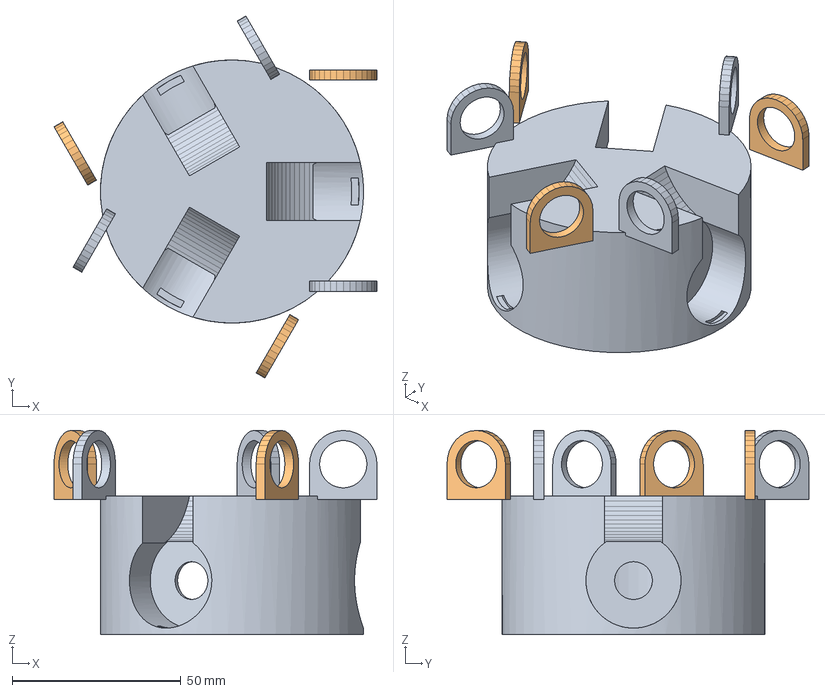
[picture p134: CAD file, 2026-10-12]
cad/exports/M/step/gearbox_bulkhead.step
95.8 x 107.3 x 60.5 mm
