ratul-hasibulkarim/Pipe-crawller/cad/exports/S/step/bevel_pinion.step

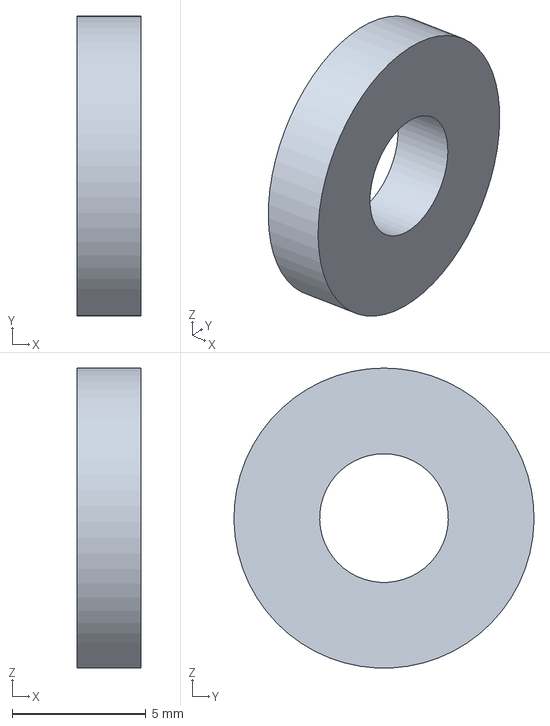
[picture p135: CAD file, 2026-10-12]
cad/exports/S/step/bevel_pinion.step
2.40 x 11.2 x 11.2 mm
