ratul-hasibulkarim/Pipe-crawller/cad/exports/L/step/drive_belt_GT2.step

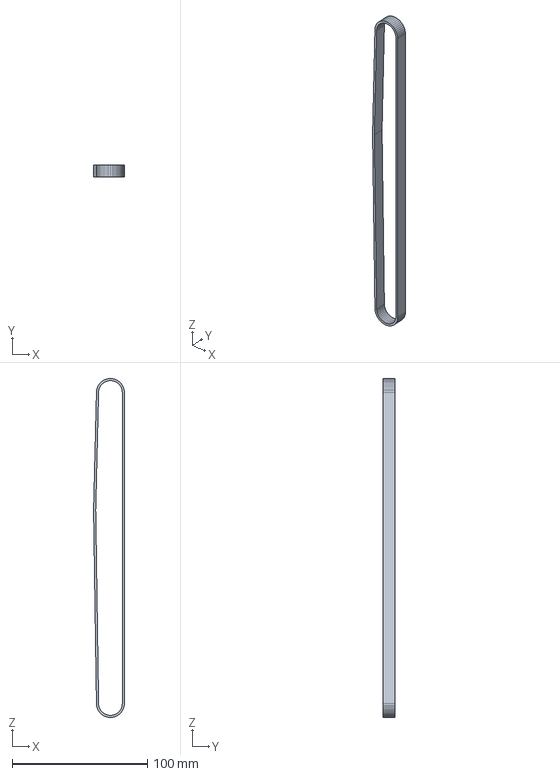
[picture p136: CAD file, 2026-10-12]
cad/exports/L/step/drive_belt_GT2.step
22.8 x 9.00 x 250.7 mm
