ratul-hasibulkarim/Pipe-crawller/cad/exports/M/step/led_ring_mount.step

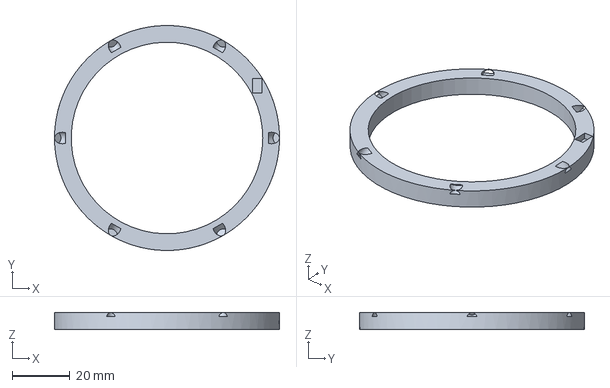
[picture p137: CAD file, 2026-10-12]
cad/exports/M/step/led_ring_mount.step
78.0 x 78.0 x 6.00 mm
