ratul-hasibulkarim/Pipe-crawller/cad/exports/S/step/wheel_tread.step

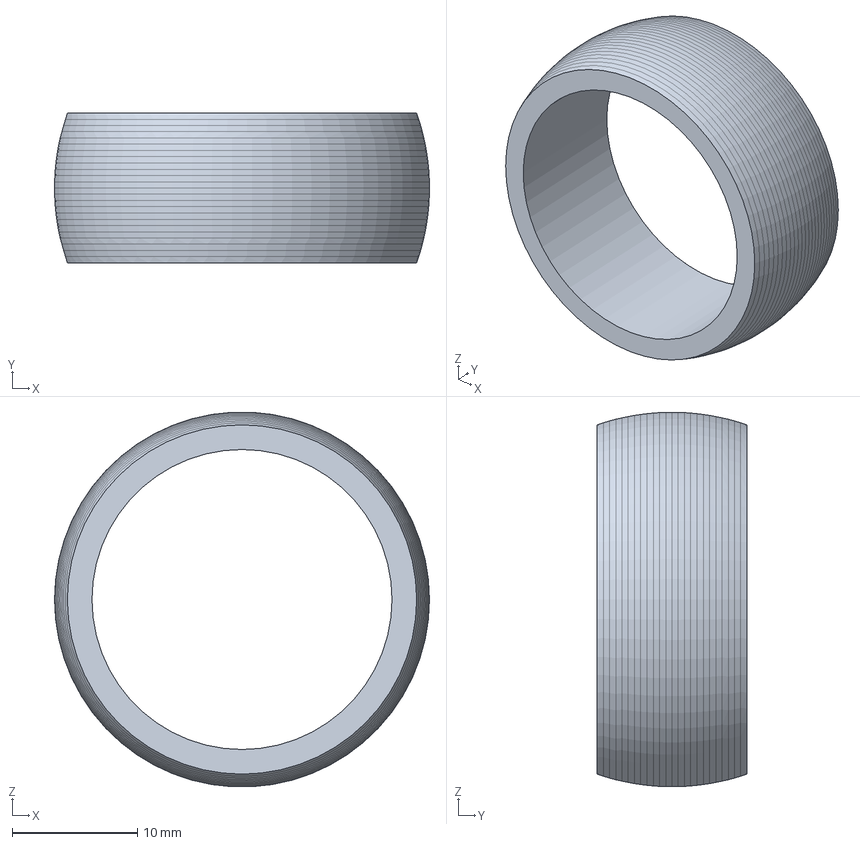
[picture p138: CAD file, 2026-10-12]
cad/exports/S/step/wheel_tread.step
30.0 x 12.0 x 30.0 mm
