ratul-hasibulkarim/Pipe-crawller/cad/exports/L/step/stub_pin.step

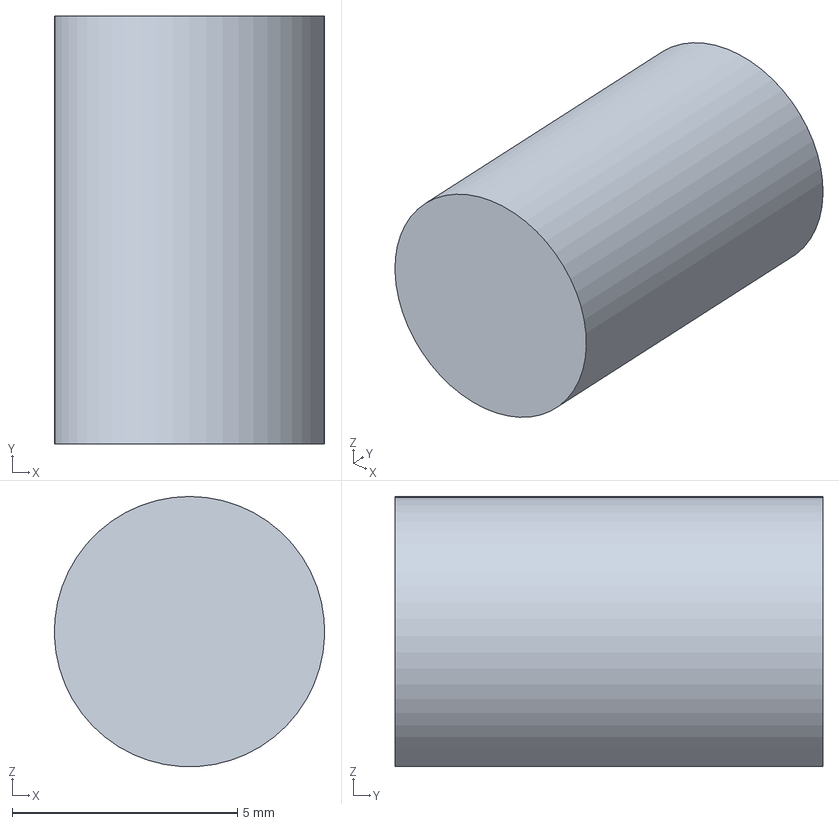
[picture p139: CAD file, 2026-10-12]
cad/exports/L/step/stub_pin.step
6.00 x 9.50 x 5.99 mm
