ratul-hasibulkarim/Pipe-crawller/cad/exports/M/step/joint_boot.step

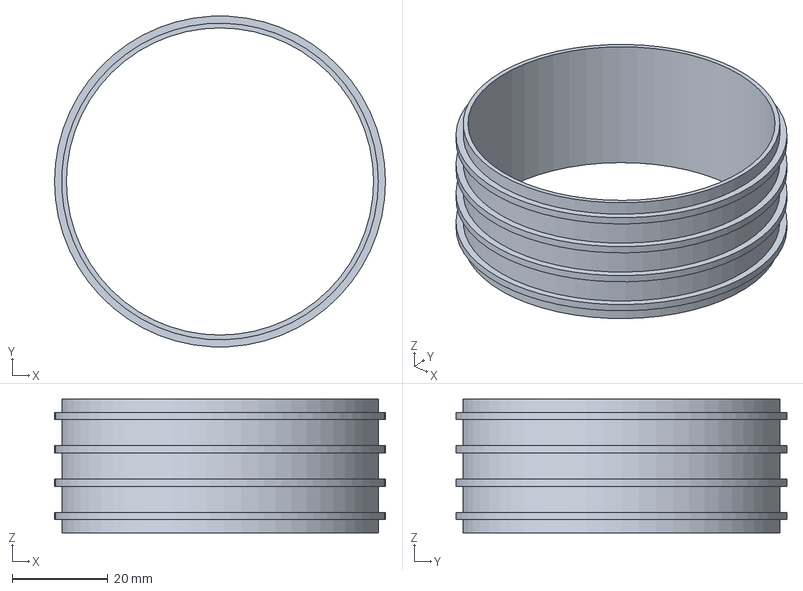
[picture p140: CAD file, 2026-10-12]
cad/exports/M/step/joint_boot.step
69.3 x 69.2 x 28.0 mm
