ratul-hasibulkarim/Pipe-crawller/cad/exports/S/step/electronics_tray.step

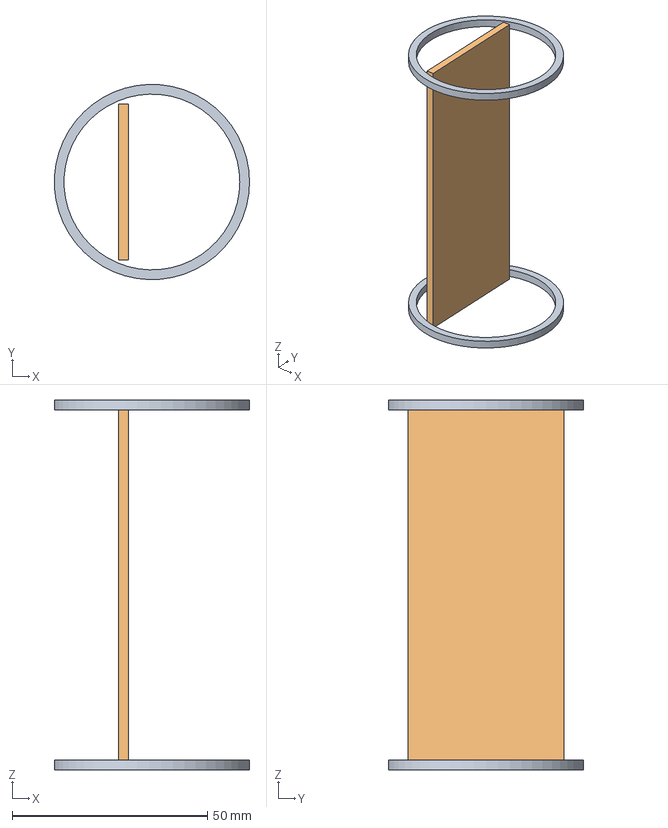
[picture p141: CAD file, 2026-10-12]
cad/exports/S/step/electronics_tray.step
50.0 x 50.0 x 94.7 mm
