ratul-hasibulkarim/Pipe-crawller/cad/exports/L/step/compute_Pi_5.step

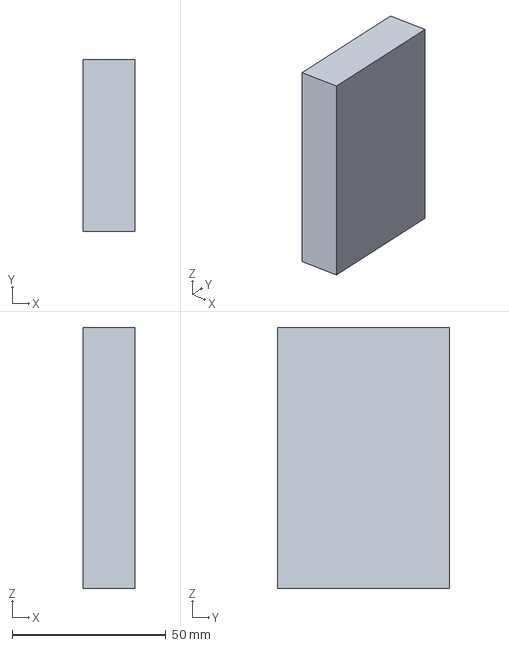
[picture p142: CAD file, 2026-10-12]
cad/exports/L/step/compute_Pi_5.step
17.0 x 56.0 x 85.0 mm
