ratul-hasibulkarim/Pipe-crawller/cad/exports/M/step/belt_tensioner.step

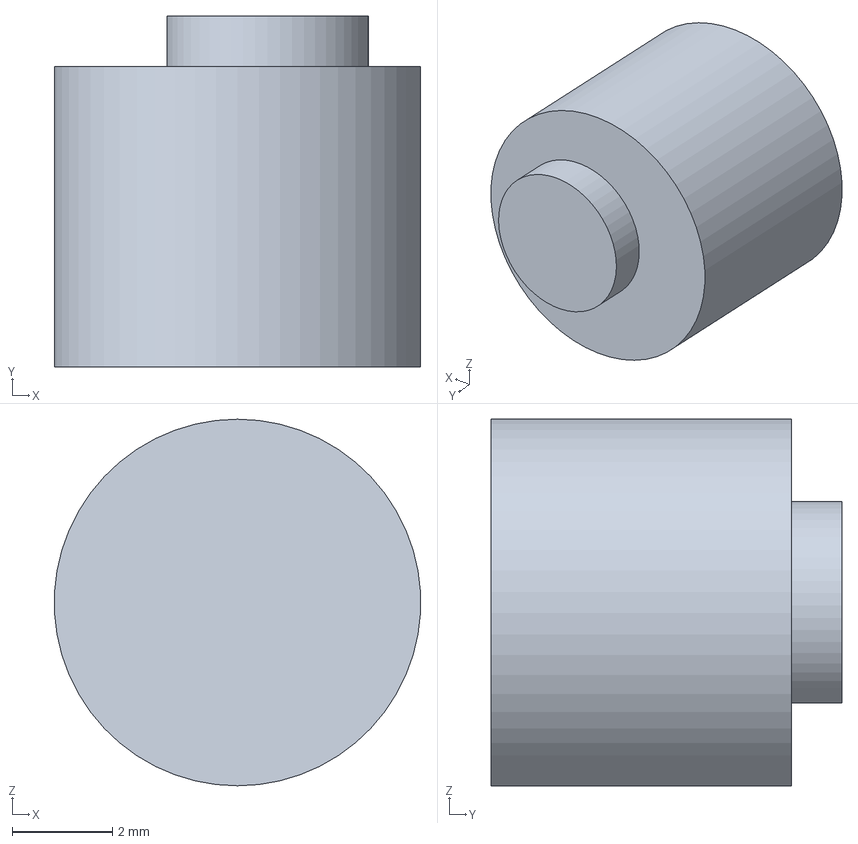
[picture p143: CAD file, 2026-10-12]
cad/exports/M/step/belt_tensioner.step
7.31 x 7.00 x 7.32 mm
