ratul-hasibulkarim/Pipe-crawller/cad/exports/S/step/worm_sector.step

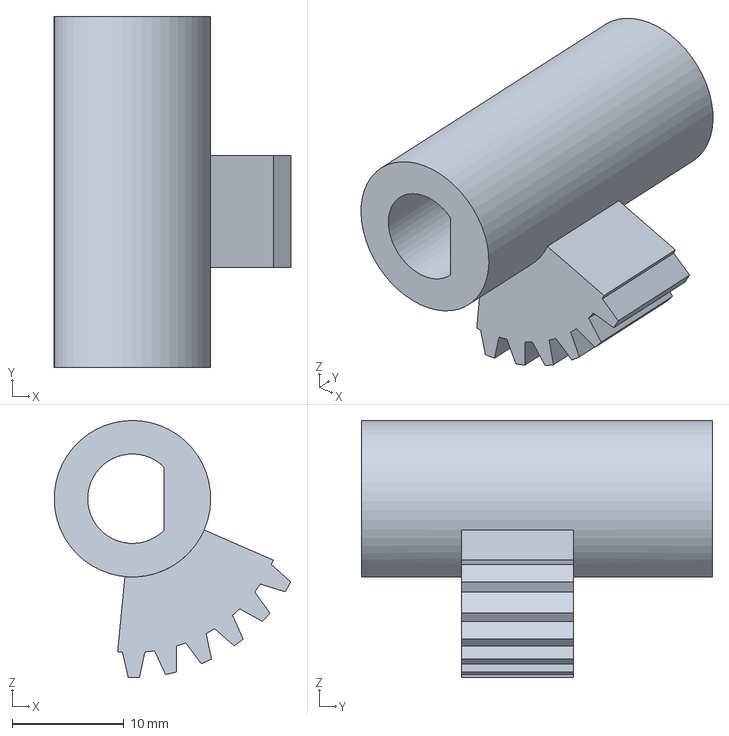
[picture p144: CAD file, 2026-10-12]
cad/exports/S/step/worm_sector.step
21.2 x 31.4 x 23.0 mm
