ratul-hasibulkarim/Pipe-crawller/cad/exports/L/step/drive_worm_gearbox_21to1.step

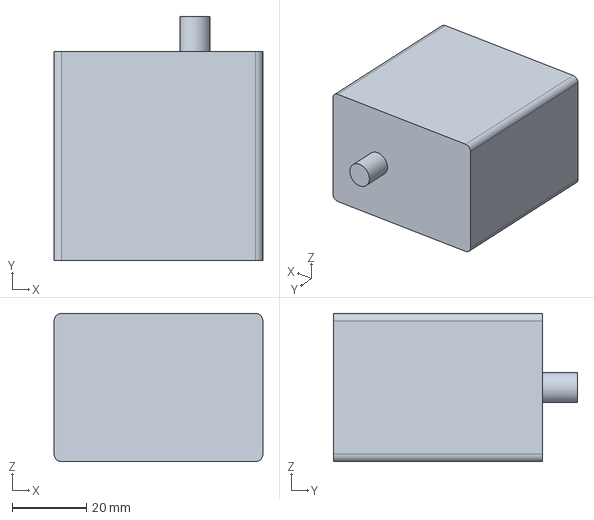
[picture p145: CAD file, 2026-10-12]
cad/exports/L/step/drive_worm_gearbox_21to1.step
56.4 x 65.9 x 40.0 mm
