ratul-hasibulkarim/Pipe-crawller/cad/exports/M/step/service_hatch_gasket.step

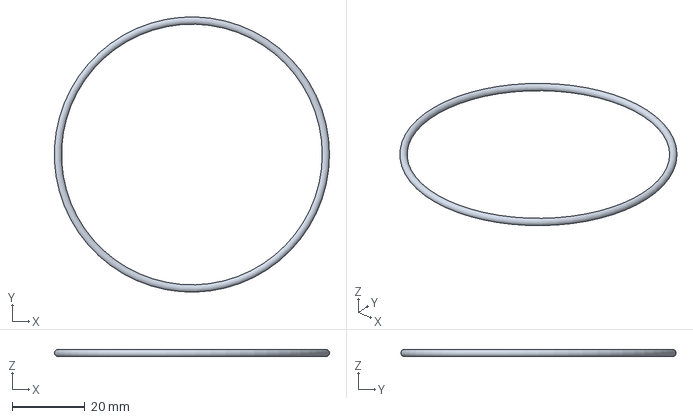
[picture p146: CAD file, 2026-10-12]
cad/exports/M/step/service_hatch_gasket.step
75.5 x 75.6 x 2.00 mm
