ratul-hasibulkarim/Pipe-crawller/cad/exports/S/step/bevel_crown.step

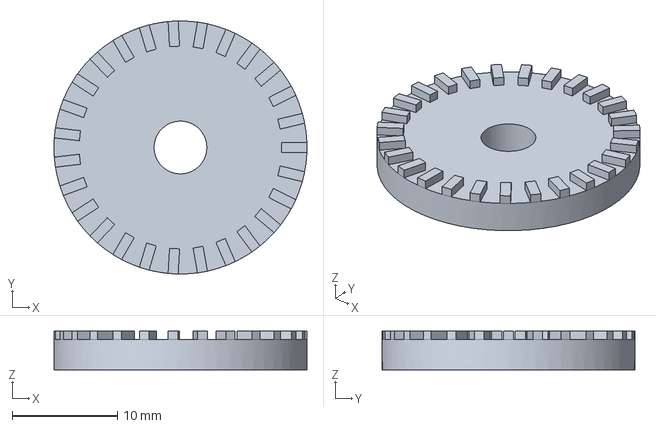
[picture p147: CAD file, 2026-10-12]
cad/exports/S/step/bevel_crown.step
24.0 x 24.0 x 3.68 mm
