ratul-hasibulkarim/Pipe-crawller/cad/exports/L/step/gimbal_pan_yoke.step

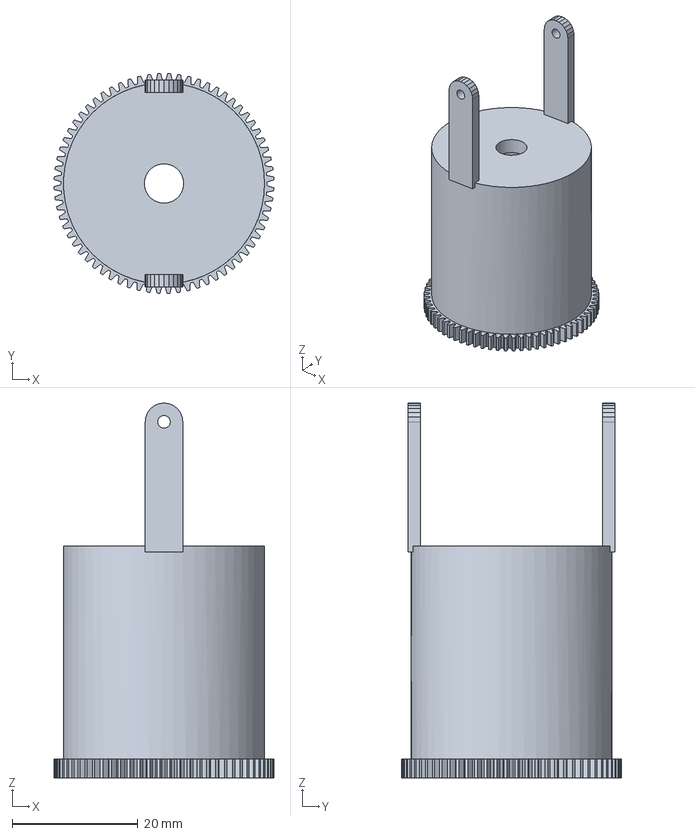
[picture p148: CAD file, 2026-10-12]
cad/exports/L/step/gimbal_pan_yoke.step
35.0 x 35.0 x 59.8 mm
