ratul-hasibulkarim/Pipe-crawller/cad/exports/S/step/lever_plate.step

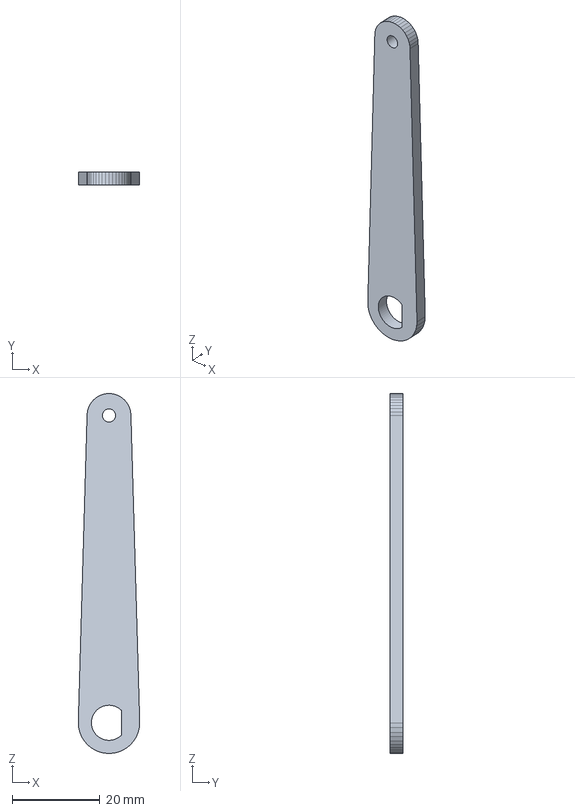
[picture p149: CAD file, 2026-10-12]
cad/exports/S/step/lever_plate.step
14.0 x 3.00 x 82.0 mm
