ratul-hasibulkarim/Pipe-crawller/cad/exports/L/step/bevel_pinion.step

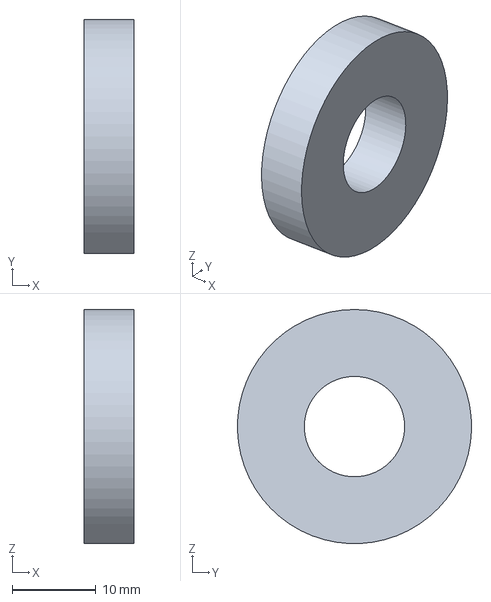
[picture p150: CAD file, 2026-10-12]
cad/exports/L/step/bevel_pinion.step
6.00 x 28.0 x 28.0 mm
