ratul-hasibulkarim/Pipe-crawller/cad/exports/S/step/timing_pulley_GT2.step

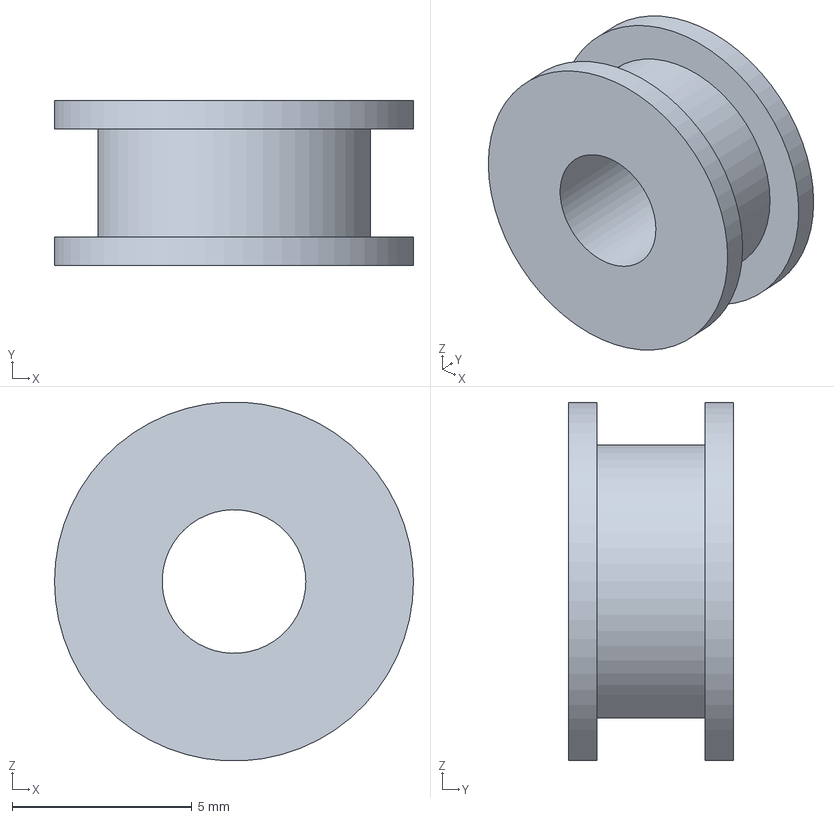
[picture p151: CAD file, 2026-10-12]
cad/exports/S/step/timing_pulley_GT2.step
10.0 x 4.60 x 9.99 mm
