ratul-hasibulkarim/Pipe-crawller/cad/exports/L/step/expansion_worm.step

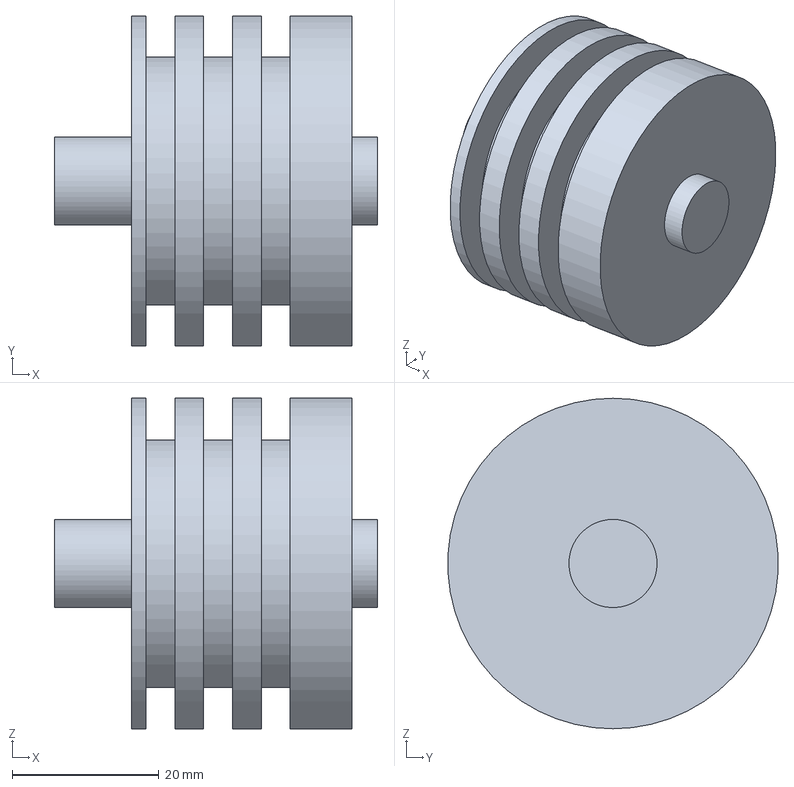
[picture p152: CAD file, 2026-10-12]
cad/exports/L/step/expansion_worm.step
44.0 x 44.9 x 45.0 mm
