ratul-hasibulkarim/Pipe-crawller/cad/exports/S/step/body_rear_shell.step

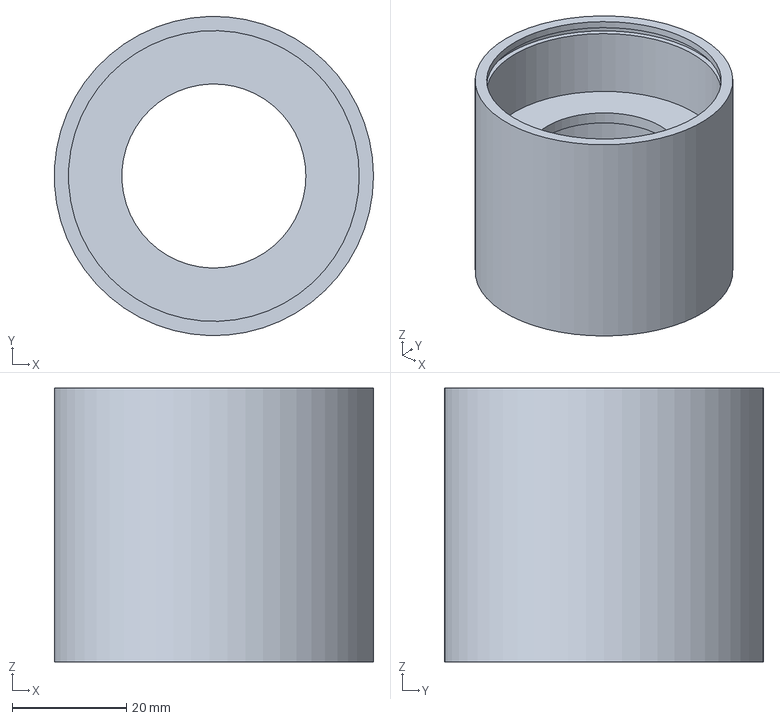
[picture p153: CAD file, 2026-10-12]
cad/exports/S/step/body_rear_shell.step
56.0 x 56.0 x 48.0 mm
