ratul-hasibulkarim/Pipe-crawller/cad/exports/M/step/battery_caddy.step

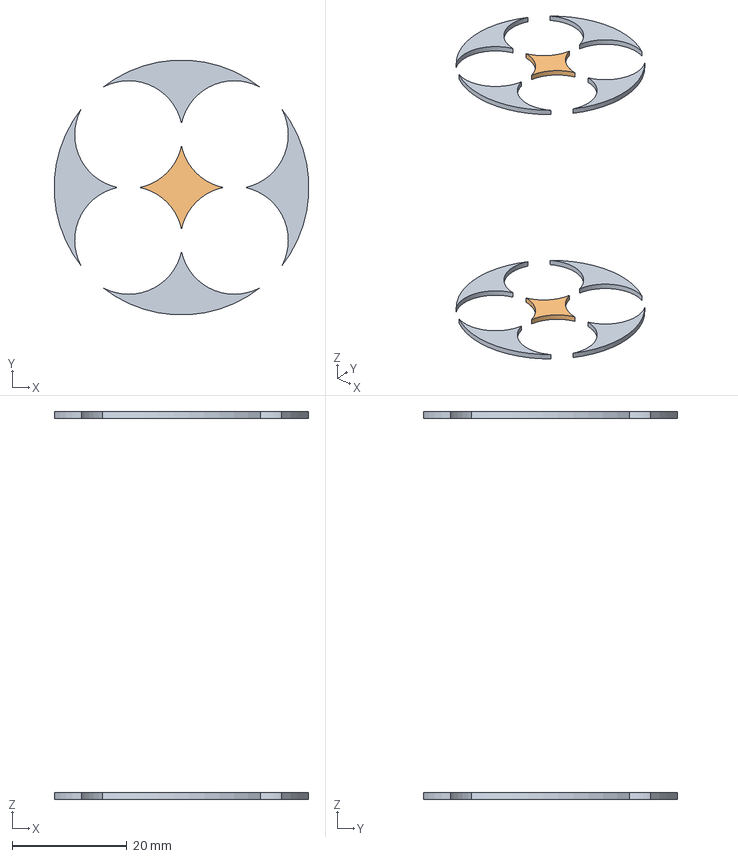
[picture p154: CAD file, 2026-10-12]
cad/exports/M/step/battery_caddy.step
44.3 x 44.3 x 67.6 mm
