ratul-hasibulkarim/Pipe-crawller/cad/exports/S/step/service_hatch_gasket.step

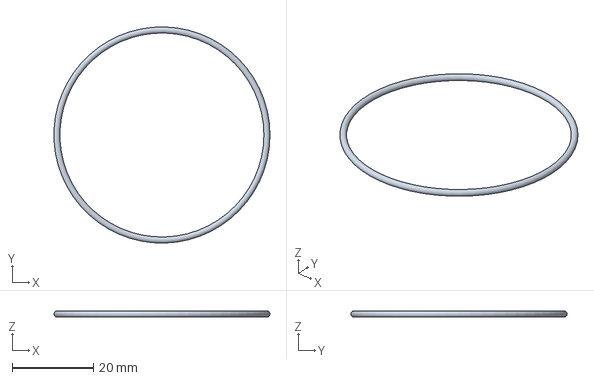
[picture p155: CAD file, 2026-10-12]
cad/exports/S/step/service_hatch_gasket.step
53.1 x 53.1 x 1.50 mm
