ratul-hasibulkarim/Pipe-crawller/cad/exports/L/step/expansion_motor_NEMA23L.step

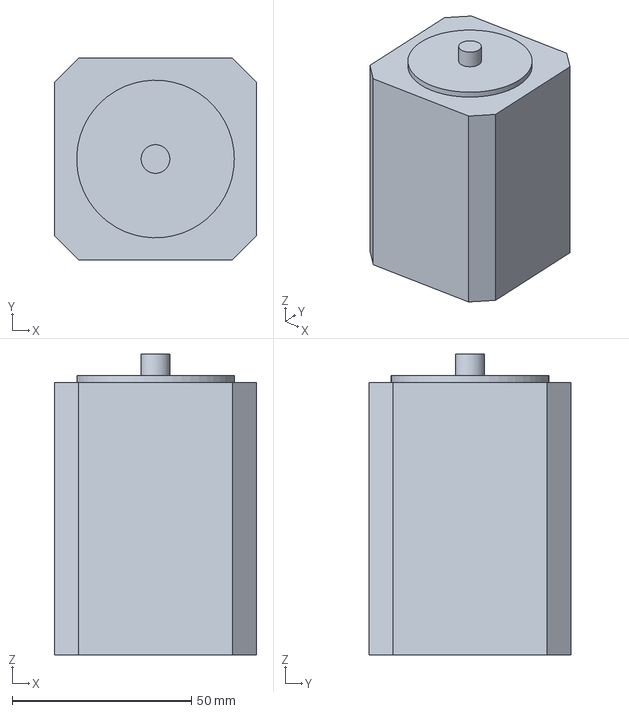
[picture p156: CAD file, 2026-10-12]
cad/exports/L/step/expansion_motor_NEMA23L.step
56.4 x 56.4 x 84.0 mm
