ratul-hasibulkarim/Pipe-crawller/cad/exports/M/step/rocker_plate.step

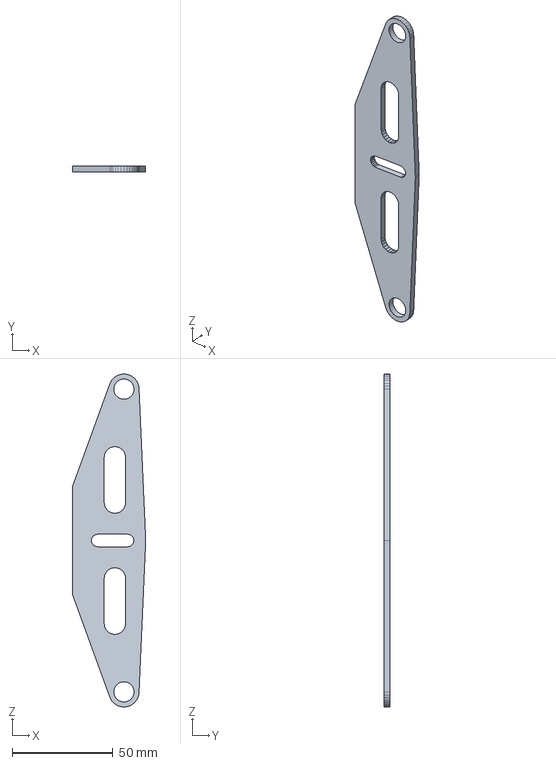
[picture p157: CAD file, 2026-10-12]
cad/exports/M/step/rocker_plate.step
36.4 x 3.00 x 165.0 mm
