ratul-hasibulkarim/Pipe-crawller/cad/exports/S/step/bearing_MR74ZZ.step

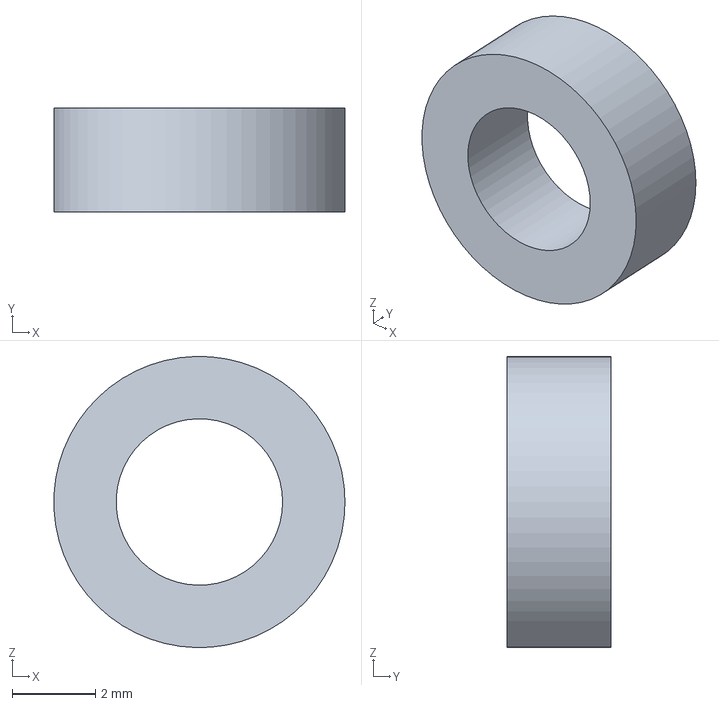
[picture p158: CAD file, 2026-10-12]
cad/exports/S/step/bearing_MR74ZZ.step
7.00 x 2.50 x 7.00 mm
