ratul-hasibulkarim/Pipe-crawller/cad/exports/L/step/belt_tensioner.step

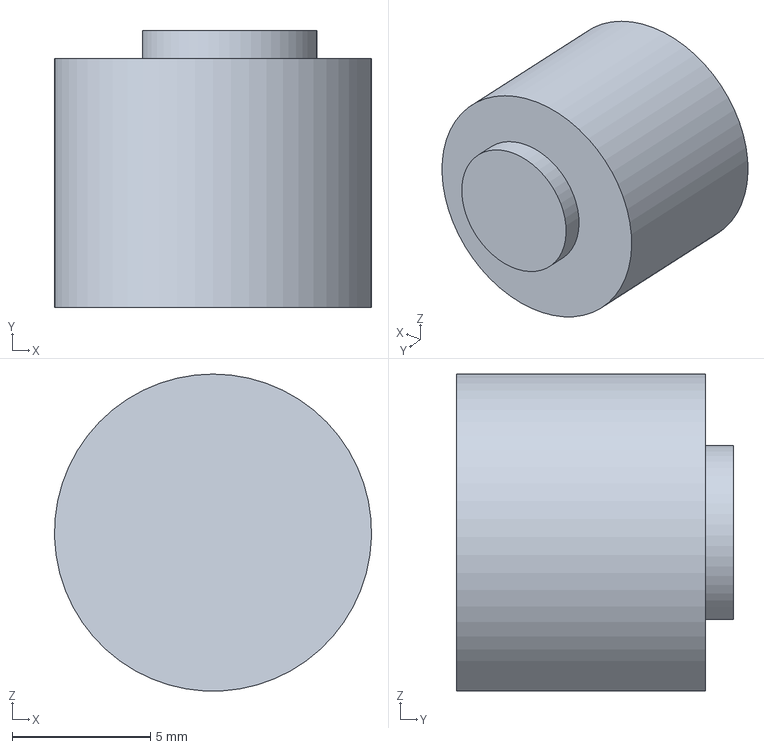
[picture p159: CAD file, 2026-10-12]
cad/exports/L/step/belt_tensioner.step
11.5 x 10.0 x 11.5 mm
