ratul-hasibulkarim/Pipe-crawller/cad/exports/M/step/articulation_yoke_rear.step

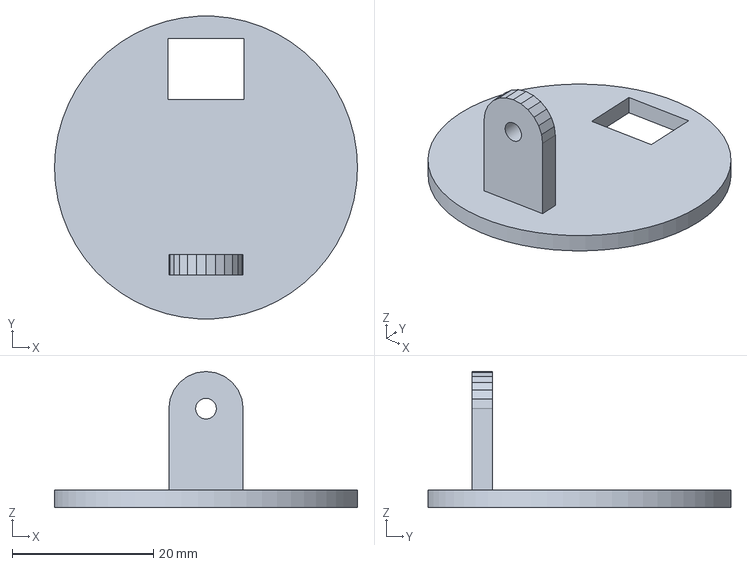
[picture p160: CAD file, 2026-10-12]
cad/exports/M/step/articulation_yoke_rear.step
42.9 x 42.8 x 19.3 mm
