ratul-hasibulkarim/Pipe-crawller/cad/exports/S/step/belt_tensioner.step

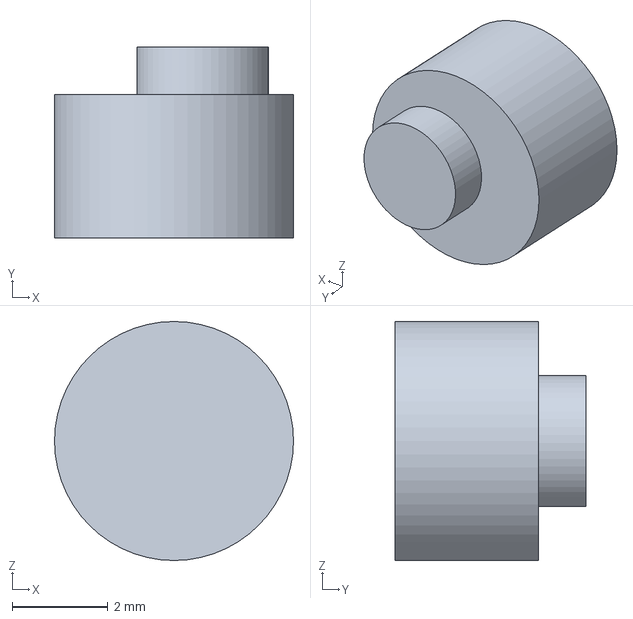
[picture p161: CAD file, 2026-10-12]
cad/exports/S/step/belt_tensioner.step
5.00 x 4.00 x 5.00 mm
