ratul-hasibulkarim/Pipe-crawller/cad/exports/L/step/pan_gearmotor_ga25.step

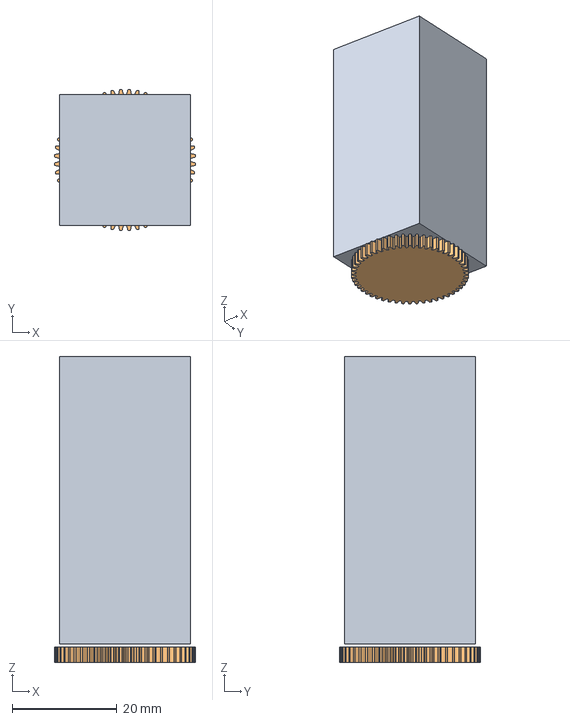
[picture p162: CAD file, 2026-10-12]
cad/exports/L/step/pan_gearmotor_ga25.step
27.0 x 27.0 x 58.5 mm
