ratul-hasibulkarim/Pipe-crawller/cad/exports/M/step/expansion_worm.step

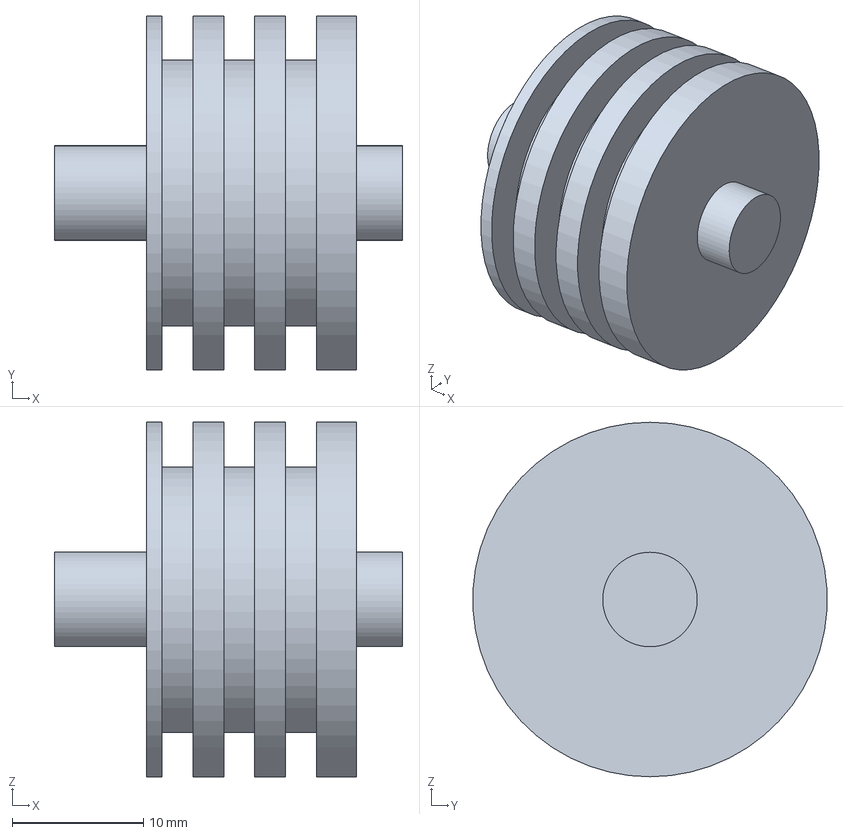
[picture p163: CAD file, 2026-10-12]
cad/exports/M/step/expansion_worm.step
26.5 x 27.0 x 27.0 mm
