ratul-hasibulkarim/Pipe-crawller/cad/exports/S/step/pivot_shaft.step

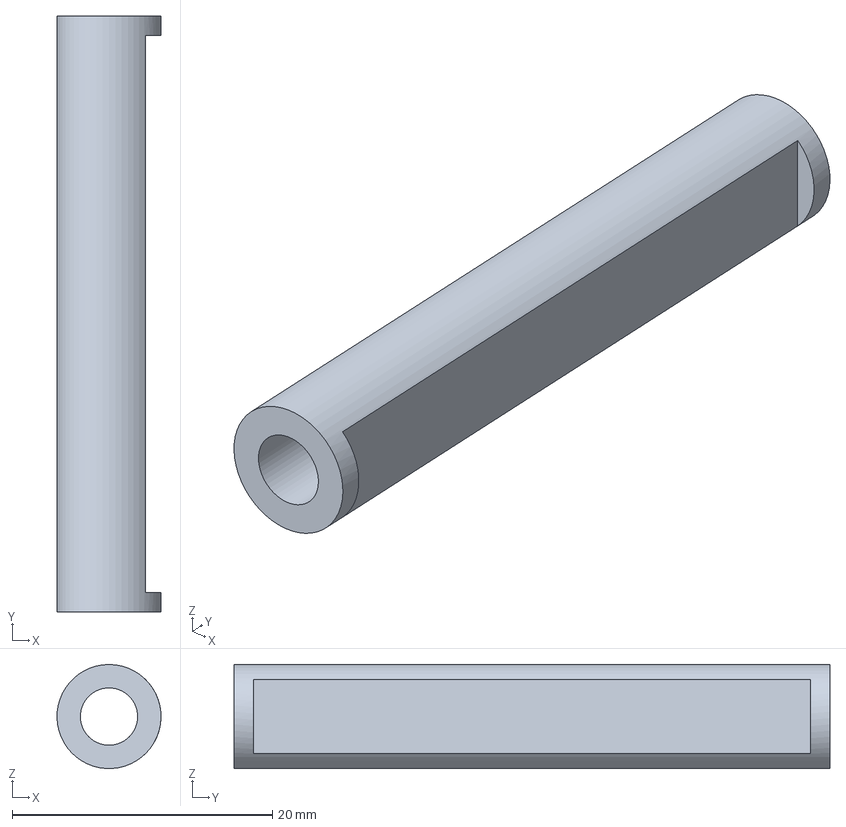
[picture p164: CAD file, 2026-10-12]
cad/exports/S/step/pivot_shaft.step
8.00 x 45.8 x 7.99 mm
