ratul-hasibulkarim/Pipe-crawller/cad/exports/S/step/body_mid_chassis.step

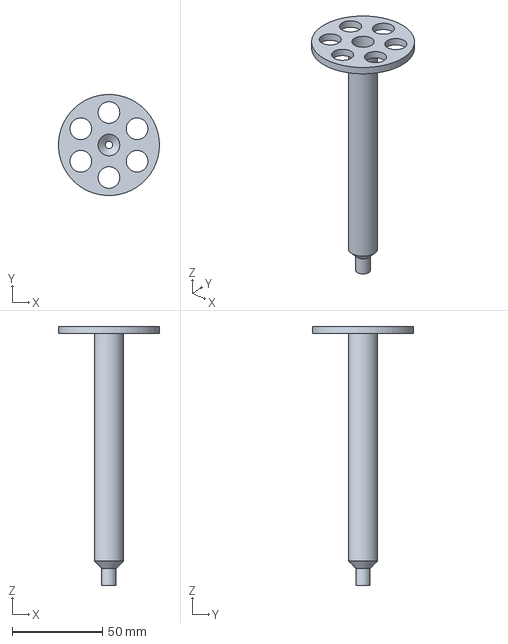
[picture p165: CAD file, 2026-10-12]
cad/exports/S/step/body_mid_chassis.step
55.9 x 56.0 x 143.5 mm
