ratul-hasibulkarim/Pipe-crawller/cad/exports/L/step/articulation_yoke_rear.step

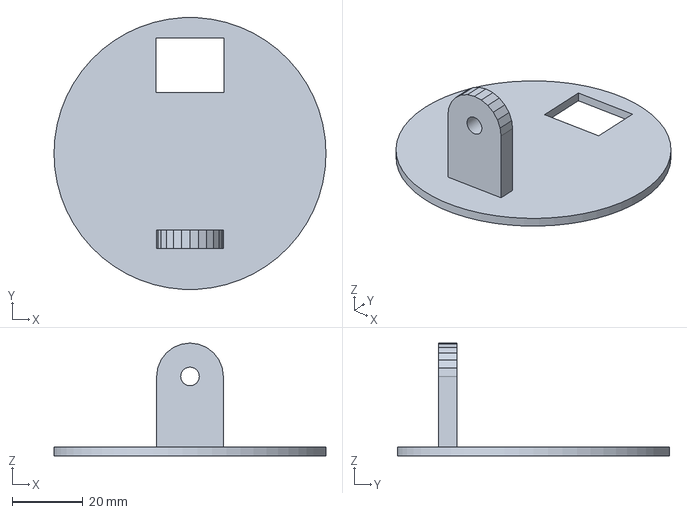
[picture p166: CAD file, 2026-10-12]
cad/exports/L/step/articulation_yoke_rear.step
77.0 x 76.9 x 31.9 mm
