ratul-hasibulkarim/Pipe-crawller/cad/exports/M/step/worm_bearing_block.step

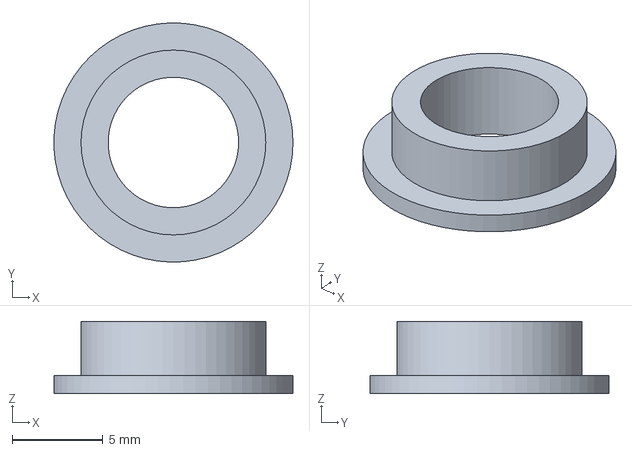
[picture p167: CAD file, 2026-10-12]
cad/exports/M/step/worm_bearing_block.step
13.2 x 13.2 x 4.00 mm
