ratul-hasibulkarim/Pipe-crawller/cad/exports/S/step/drive_stepper_NEMA8.step

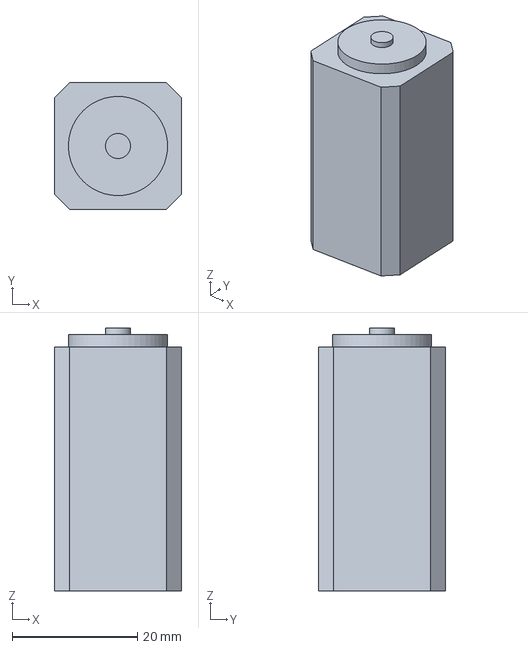
[picture p168: CAD file, 2026-10-12]
cad/exports/S/step/drive_stepper_NEMA8.step
20.3 x 20.3 x 42.0 mm
