ratul-hasibulkarim/Pipe-crawller/cad/exports/L/step/timing_pulley_GT2.step

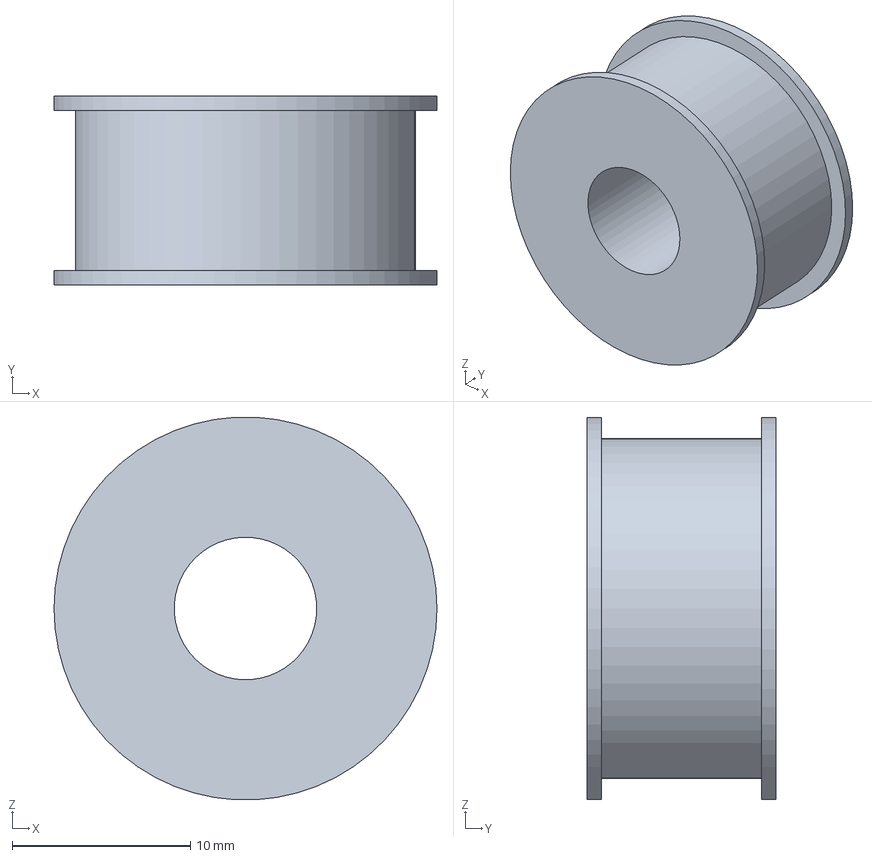
[picture p169: CAD file, 2026-10-12]
cad/exports/L/step/timing_pulley_GT2.step
21.5 x 10.6 x 21.5 mm
