ratul-hasibulkarim/Pipe-crawller/cad/exports/M/step/drive_stepper_NEMA14.step

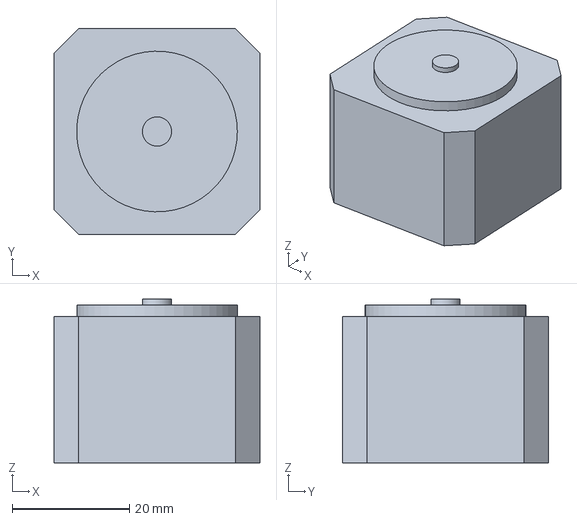
[picture p170: CAD file, 2026-10-12]
cad/exports/M/step/drive_stepper_NEMA14.step
35.2 x 35.2 x 28.0 mm
