ratul-hasibulkarim/Pipe-crawller/cad/exports/S/step/wheel_hub.step

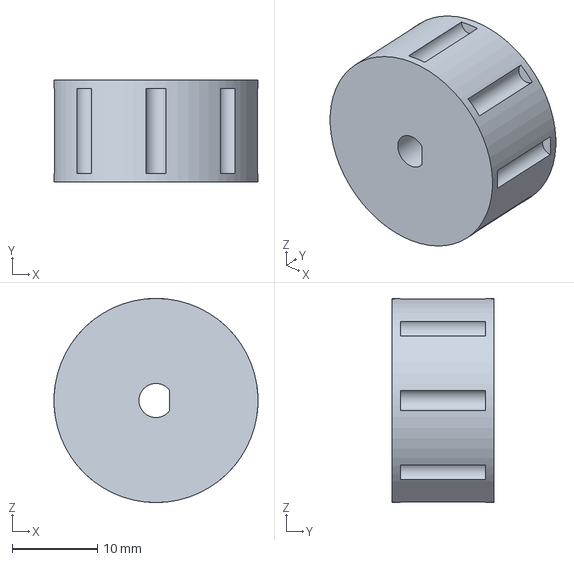
[picture p171: CAD file, 2026-10-12]
cad/exports/S/step/wheel_hub.step
24.0 x 12.0 x 24.0 mm
