ratul-hasibulkarim/Pipe-crawller/cad/exports/L/step/lever_plate.step

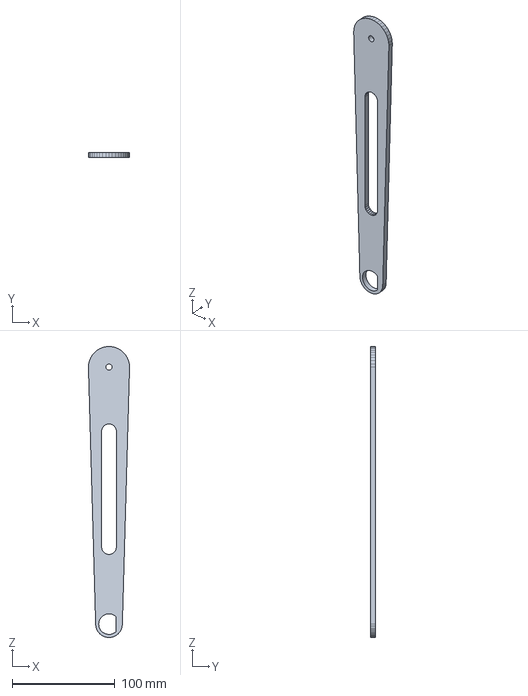
[picture p172: CAD file, 2026-10-12]
cad/exports/L/step/lever_plate.step
40.0 x 5.00 x 283.0 mm
