ratul-hasibulkarim/Pipe-crawller/cad/exports/M/step/camera_window.step

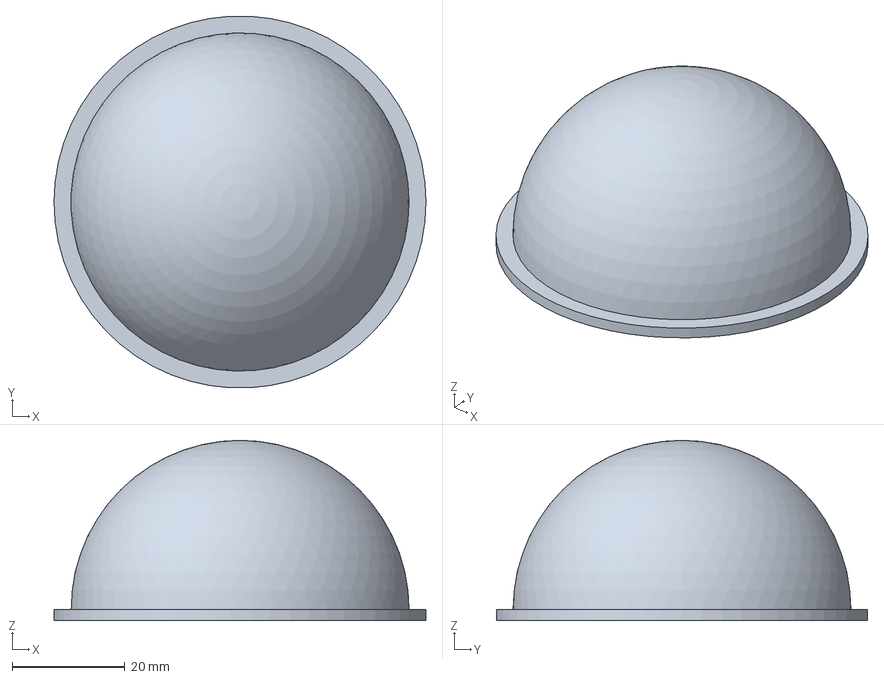
[picture p173: CAD file, 2026-10-12]
cad/exports/M/step/camera_window.step
66.0 x 65.9 x 32.0 mm
