ratul-hasibulkarim/Pipe-crawller/cad/exports/L/step/joint_boot.step

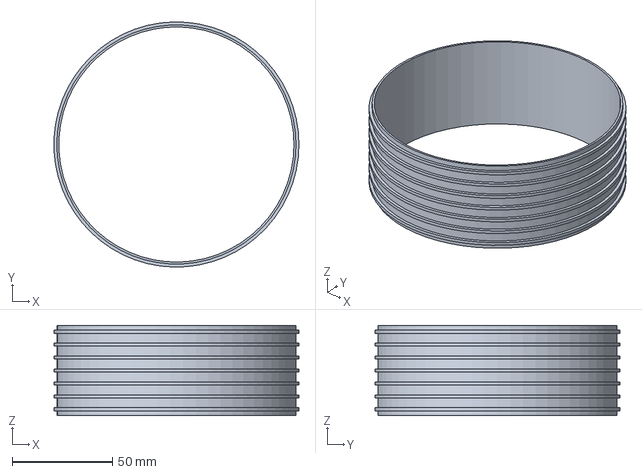
[picture p174: CAD file, 2026-10-12]
cad/exports/L/step/joint_boot.step
121.9 x 122.0 x 45.0 mm
