ratul-hasibulkarim/Pipe-crawller/cad/exports/S/step/expansion_worm.step

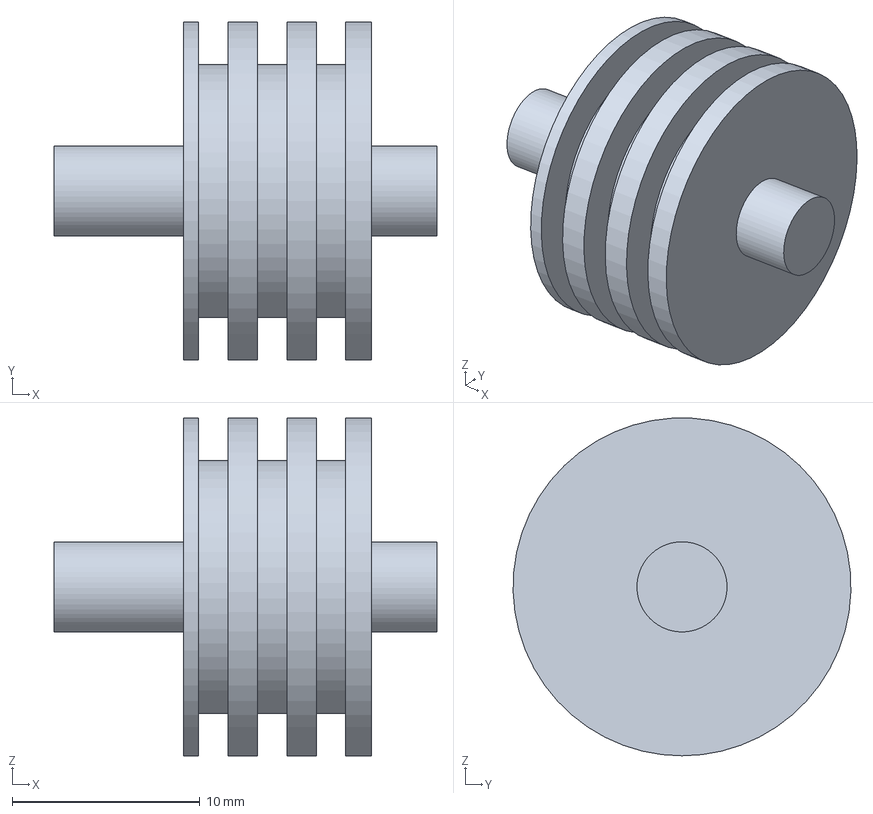
[picture p175: CAD file, 2026-10-12]
cad/exports/S/step/expansion_worm.step
20.4 x 18.0 x 18.0 mm
