ratul-hasibulkarim/Pipe-crawller/cad/exports/L/step/camera_window.step

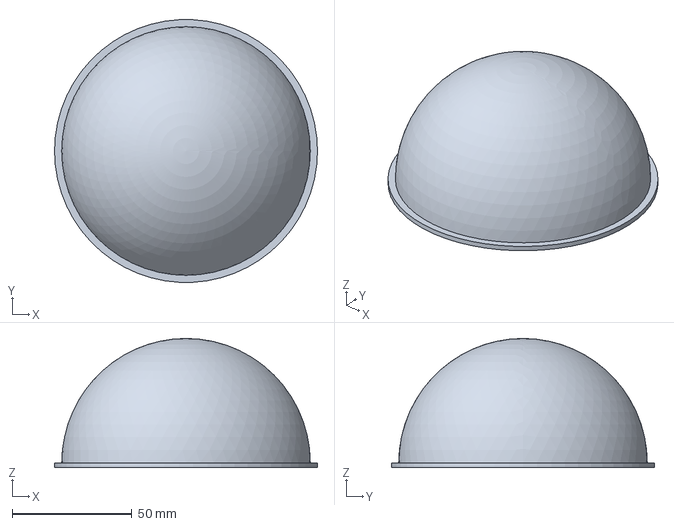
[picture p176: CAD file, 2026-10-12]
cad/exports/L/step/camera_window.step
110.0 x 109.8 x 54.0 mm
