ratul-hasibulkarim/Pipe-crawller/cad/exports/M/step/drive_worm_gearbox_20to1.step

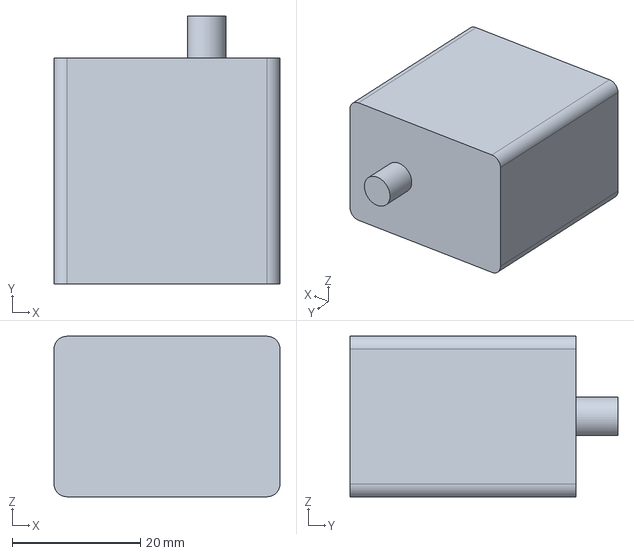
[picture p177: CAD file, 2026-10-12]
cad/exports/M/step/drive_worm_gearbox_20to1.step
35.2 x 41.7 x 25.0 mm
