ratul-hasibulkarim/Pipe-crawller/cad/exports/S/step/compliance_spring_retainer.step

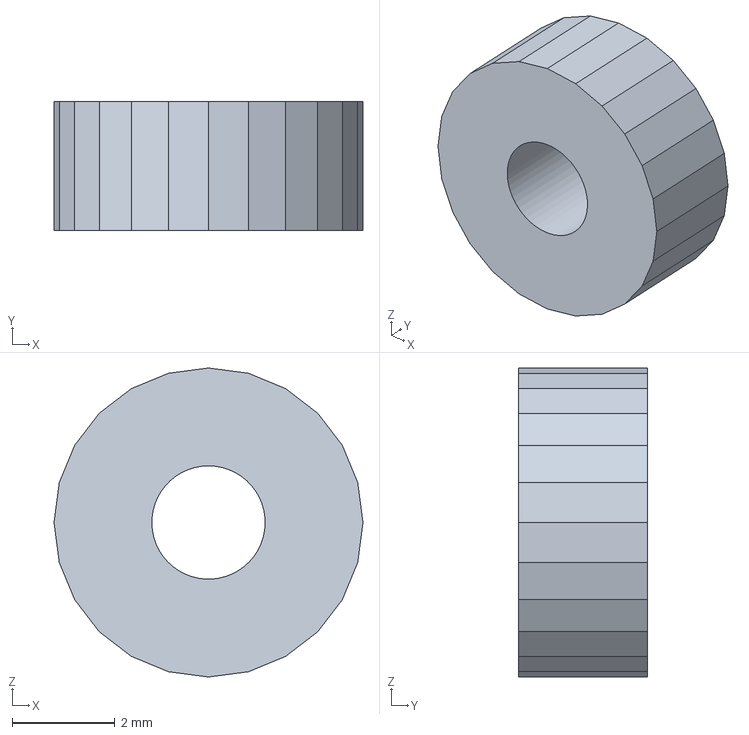
[picture p178: CAD file, 2026-10-12]
cad/exports/S/step/compliance_spring_retainer.step
6.00 x 2.50 x 6.00 mm
