ratul-hasibulkarim/Pipe-crawller/cad/exports/L/step/gearbox_bulkhead.step

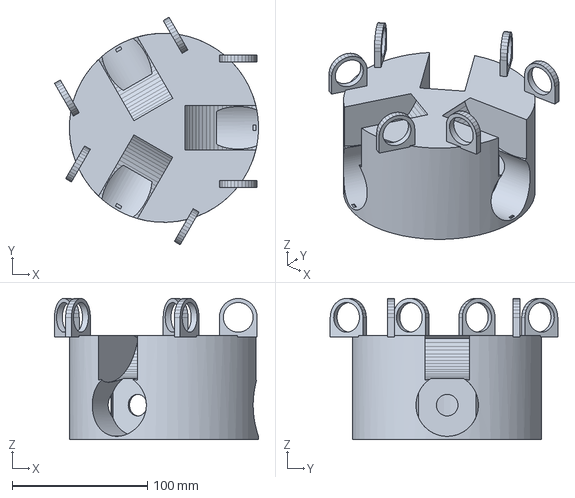
[picture p179: CAD file, 2026-10-12]
cad/exports/L/step/gearbox_bulkhead.step
151.0 x 168.5 x 104.5 mm
