ratul-hasibulkarim/Pipe-crawller/cad/exports/S/step/pipe_size_adapter.step

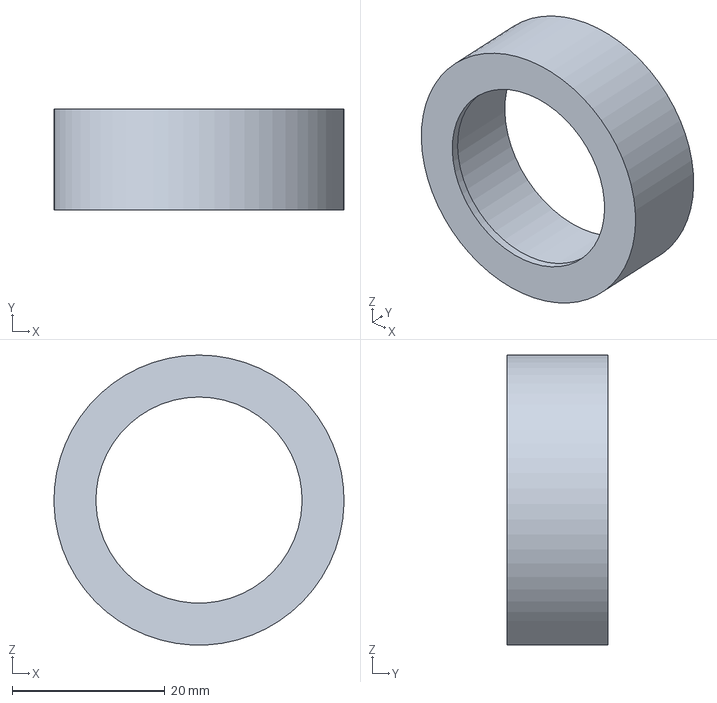
[picture p180: CAD file, 2026-10-12]
cad/exports/S/step/pipe_size_adapter.step
38.0 x 13.2 x 38.0 mm
