ratul-hasibulkarim/Pipe-crawller/cad/exports/L/step/drive_stepper_NEMA23.step

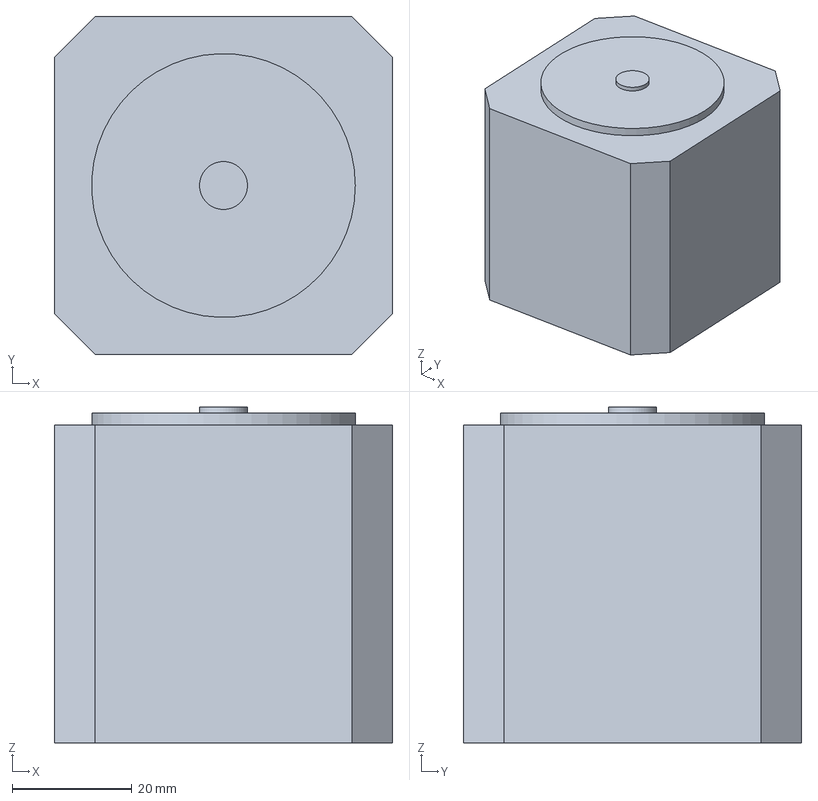
[picture p181: CAD file, 2026-10-12]
cad/exports/L/step/drive_stepper_NEMA23.step
56.4 x 56.4 x 56.0 mm
