ratul-hasibulkarim/Pipe-crawller/cad/exports/M/step/timing_pulley_GT2.step

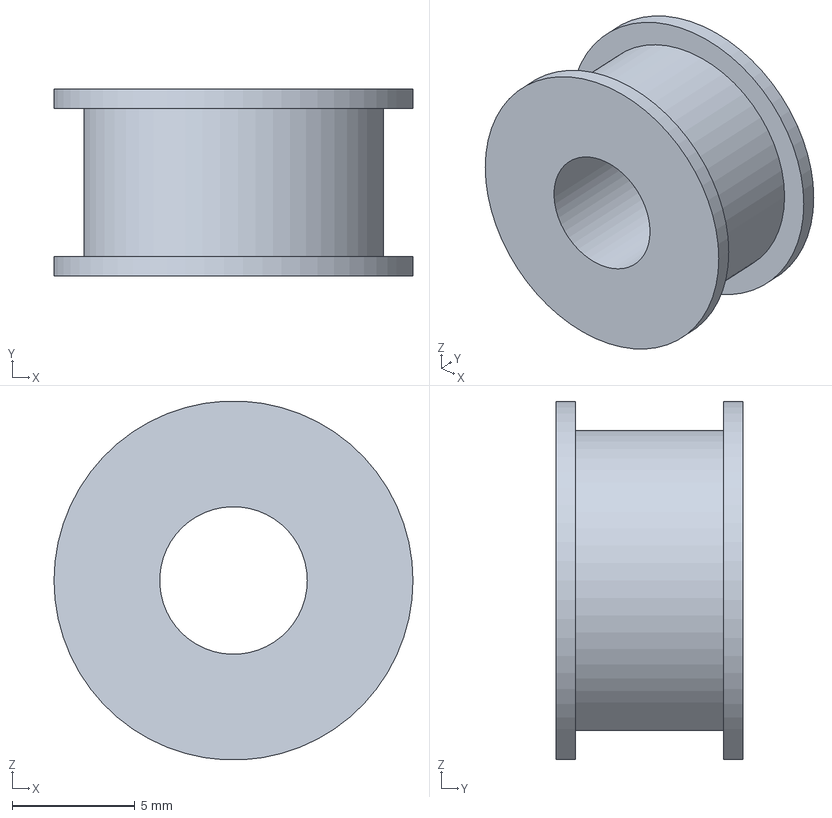
[picture p182: CAD file, 2026-10-12]
cad/exports/M/step/timing_pulley_GT2.step
14.6 x 7.60 x 14.6 mm
