ratul-hasibulkarim/Pipe-crawller/cad/exports/S/step/wheel_axle.step

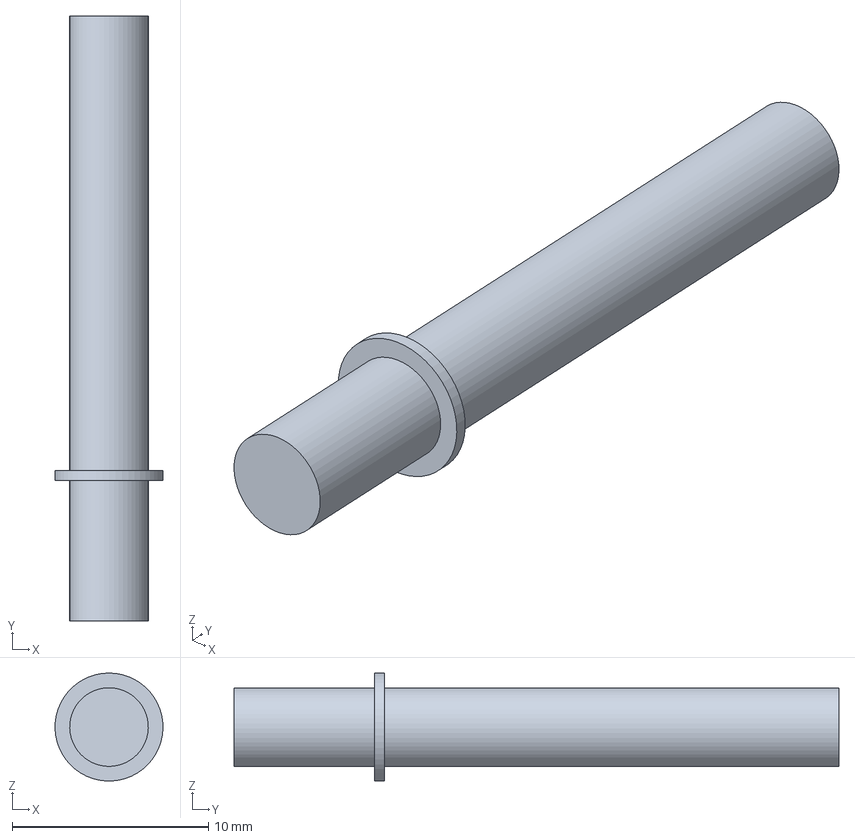
[picture p183: CAD file, 2026-10-12]
cad/exports/S/step/wheel_axle.step
5.50 x 30.8 x 5.49 mm
