ratul-hasibulkarim/Pipe-crawller/cad/exports/L/step/slide_bushing.step

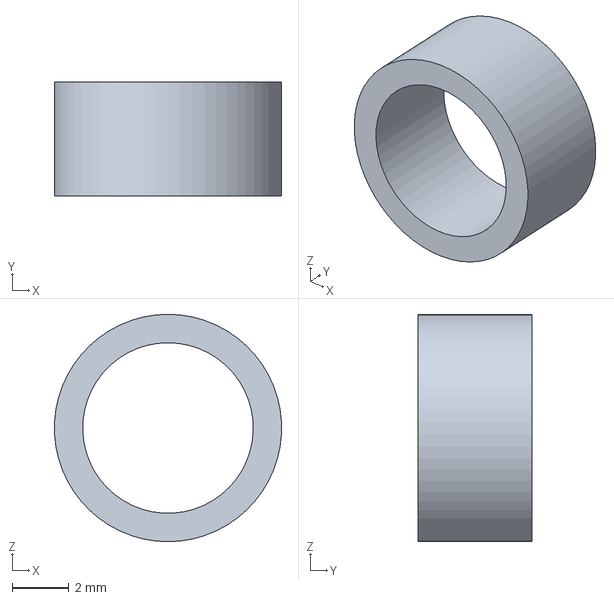
[picture p184: CAD file, 2026-10-12]
cad/exports/L/step/slide_bushing.step
7.99 x 4.00 x 8.00 mm
