ratul-hasibulkarim/Pipe-crawller/cad/exports/S/step/expansion_motor_NEMA14.step

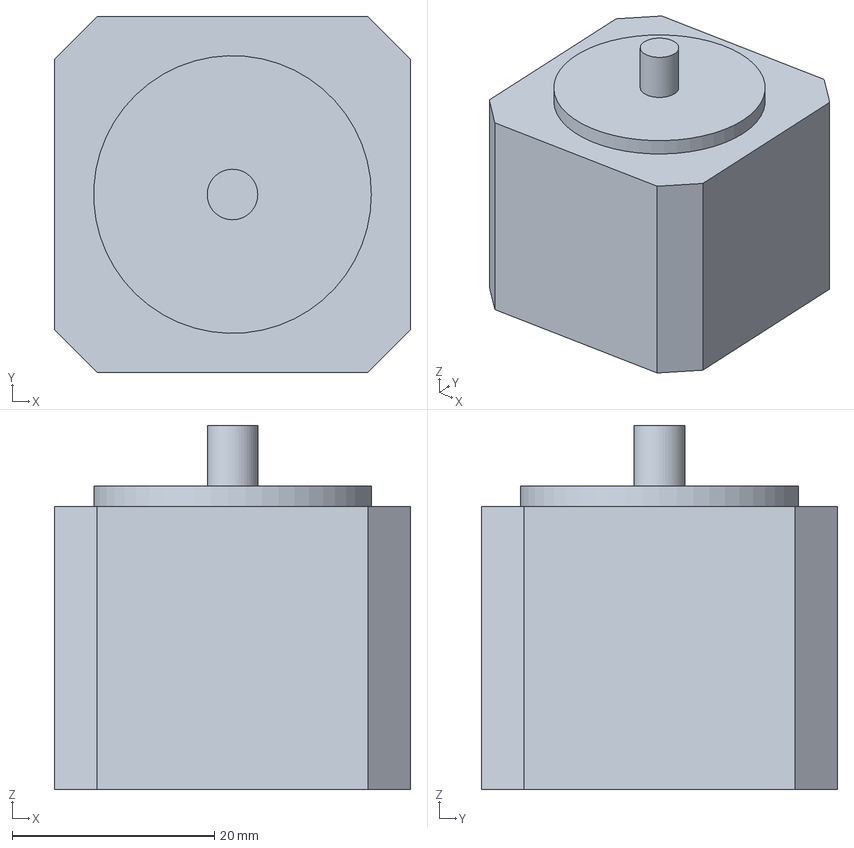
[picture p185: CAD file, 2026-10-12]
cad/exports/S/step/expansion_motor_NEMA14.step
35.2 x 35.2 x 36.0 mm
