ratul-hasibulkarim/Pipe-crawller/cad/exports/L/step/articulation_yoke_front.step

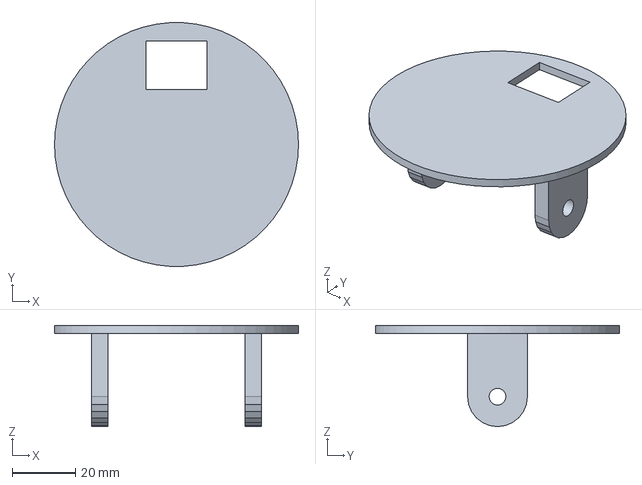
[picture p186: CAD file, 2026-10-12]
cad/exports/L/step/articulation_yoke_front.step
77.0 x 76.9 x 31.9 mm
