ratul-hasibulkarim/Pipe-crawller/cad/exports/L/step/electronics_tray.step

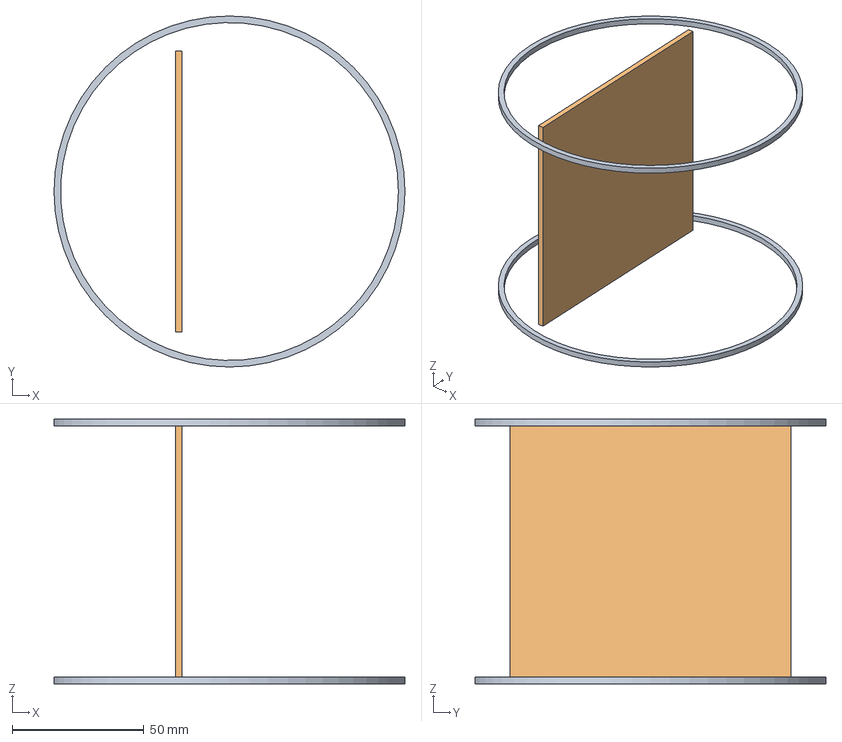
[picture p188: CAD file, 2026-10-12]
cad/exports/L/step/electronics_tray.step
133.0 x 133.0 x 100.2 mm
