ratul-hasibulkarim/Pipe-crawller/cad/exports/M/step/bearing_MR106ZZ.step

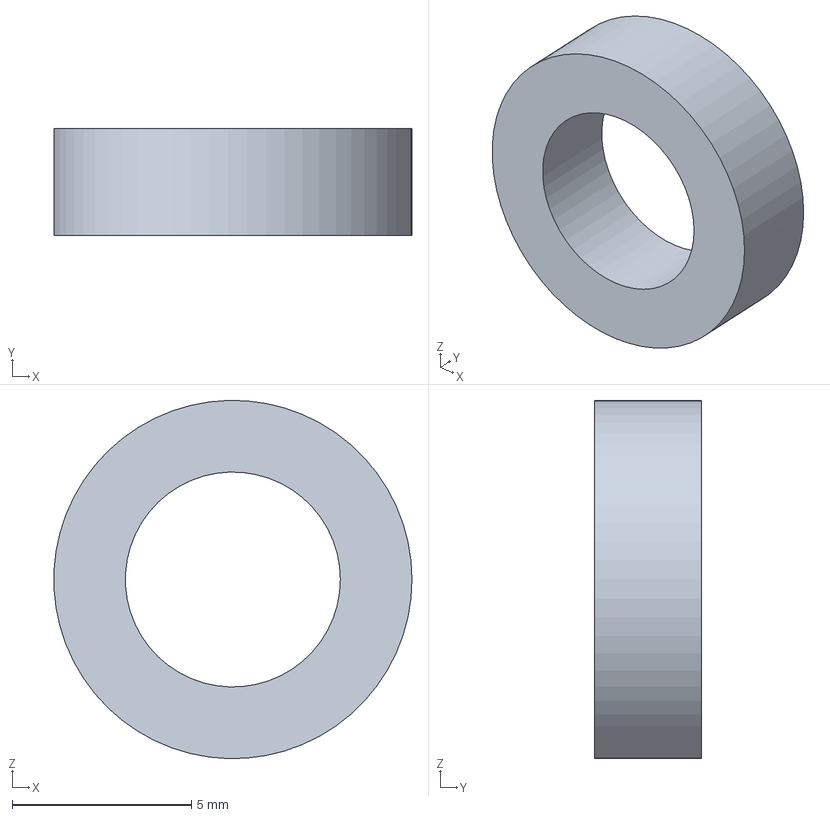
[picture p189: CAD file, 2026-10-12]
cad/exports/M/step/bearing_MR106ZZ.step
9.99 x 3.00 x 10.00 mm
