ratul-hasibulkarim/Pipe-crawller/cad/exports/S/step/gearbox_bulkhead.step

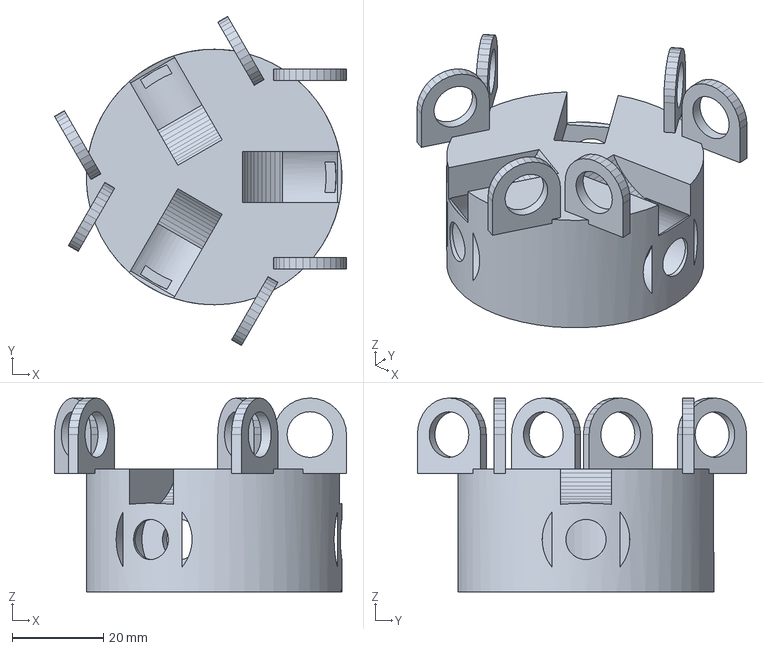
[picture p190: CAD file, 2026-10-12]
cad/exports/S/step/gearbox_bulkhead.step
64.0 x 72.1 x 42.5 mm
