ratul-hasibulkarim/Pipe-crawller/cad/exports/L/step/drive_motor_mount.step

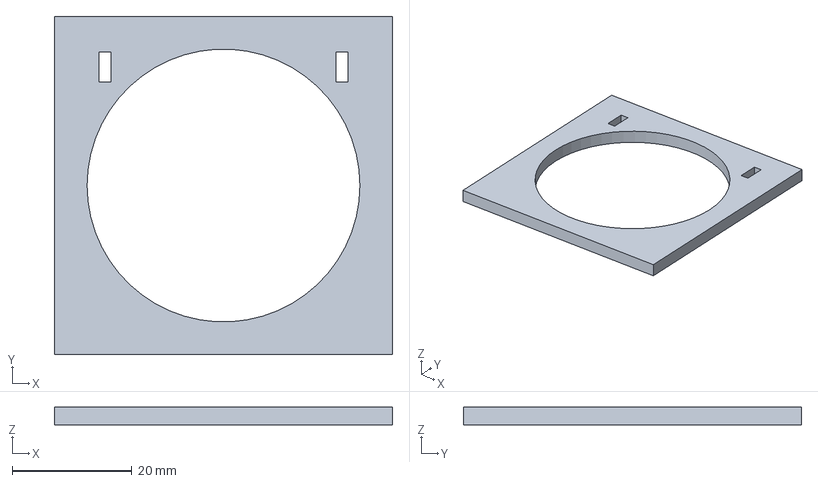
[picture p191: CAD file, 2026-10-12]
cad/exports/L/step/drive_motor_mount.step
56.4 x 56.4 x 3.00 mm
