ratul-hasibulkarim/Pipe-crawller/cad/exports/M/step/articulation_spider.step

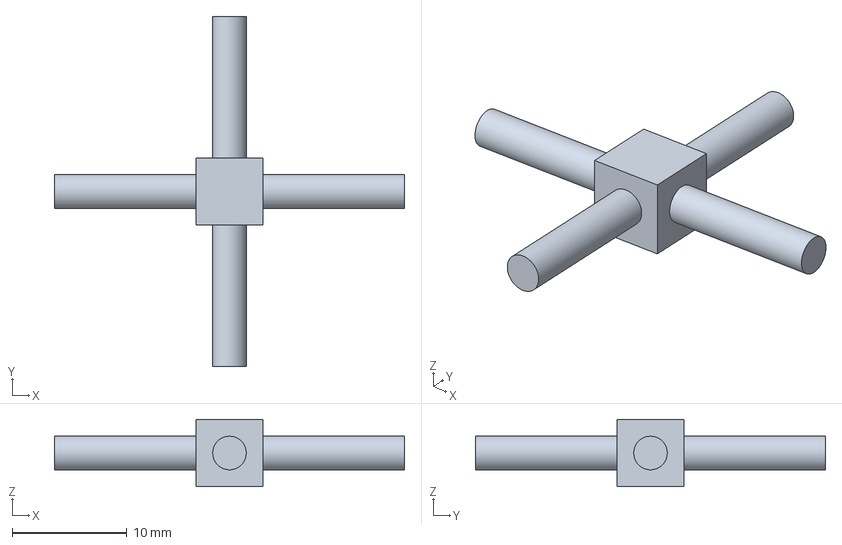
[picture p192: CAD file, 2026-10-12]
cad/exports/M/step/articulation_spider.step
30.4 x 30.4 x 5.85 mm
