ratul-hasibulkarim/Pipe-crawller/cad/exports/S/step/slide_bushing.step

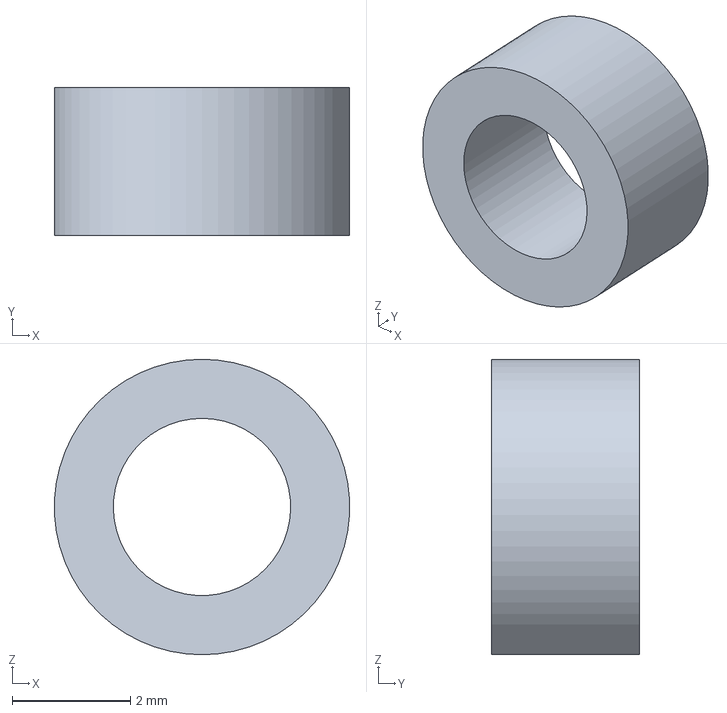
[picture p193: CAD file, 2026-10-12]
cad/exports/S/step/slide_bushing.step
4.99 x 2.50 x 5.00 mm
