ratul-hasibulkarim/Pipe-crawller/cad/exports/L/step/body_mid_chassis.step

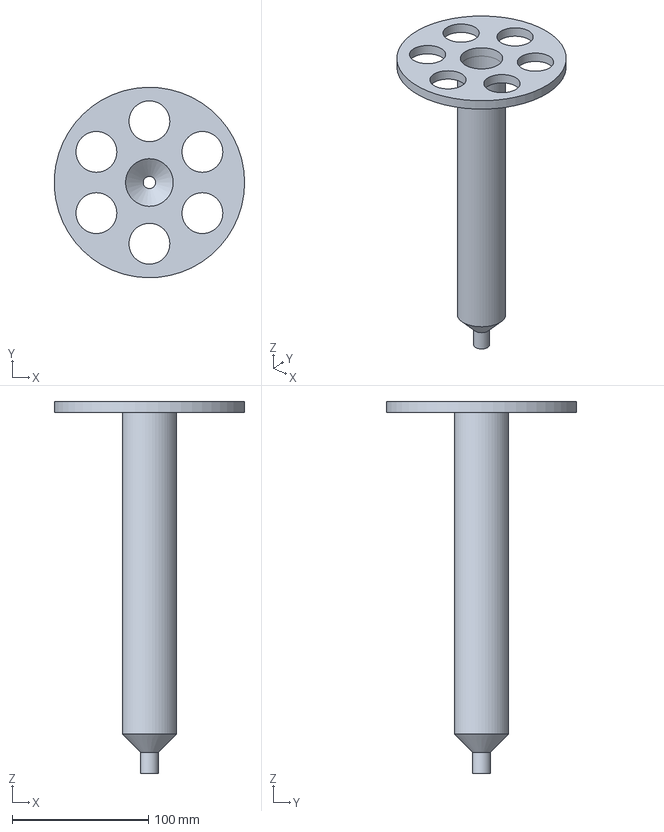
[picture p194: CAD file, 2026-10-12]
cad/exports/L/step/body_mid_chassis.step
139.9 x 139.9 x 273.5 mm
