ratul-hasibulkarim/Pipe-crawller/cad/exports/M/step/wheel_axle.step

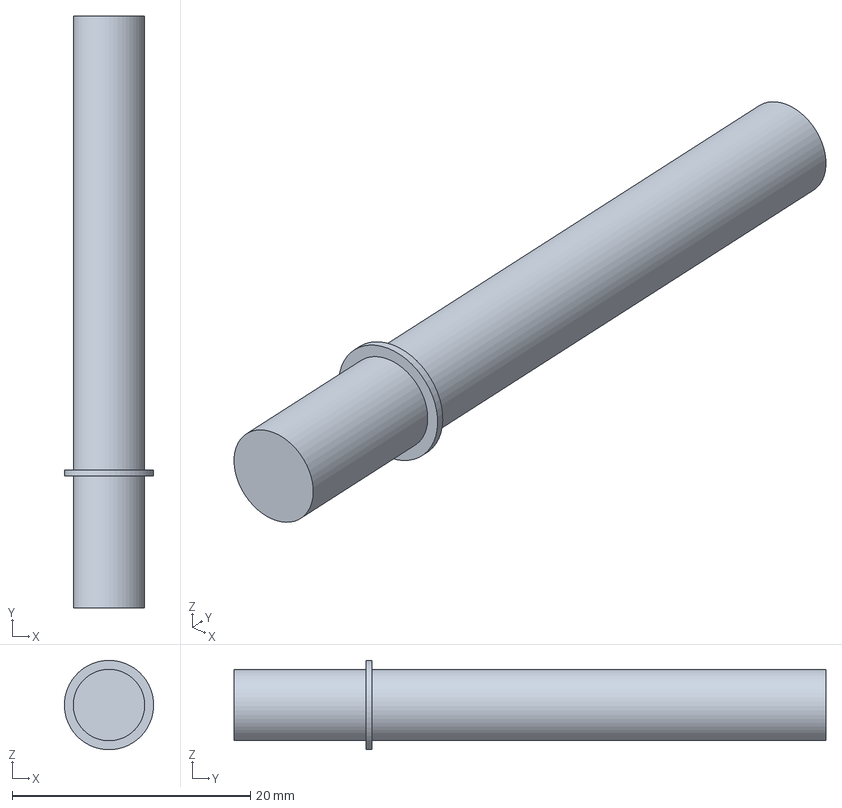
[picture p195: CAD file, 2026-10-12]
cad/exports/M/step/wheel_axle.step
7.50 x 49.7 x 7.49 mm
