ratul-hasibulkarim/Pipe-crawller/cad/exports/S/step/stub_pin.step

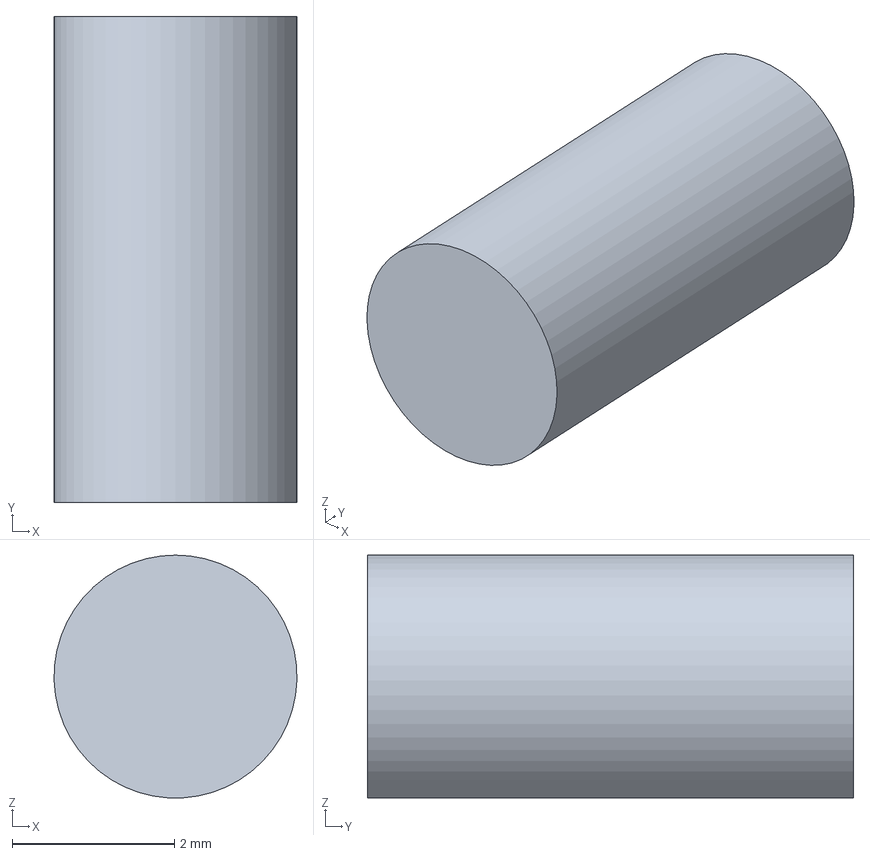
[picture p196: CAD file, 2026-10-12]
cad/exports/S/step/stub_pin.step
3.00 x 6.00 x 3.00 mm
