ratul-hasibulkarim/Pipe-crawller/cad/exports/L/step/body_rear_shell.step

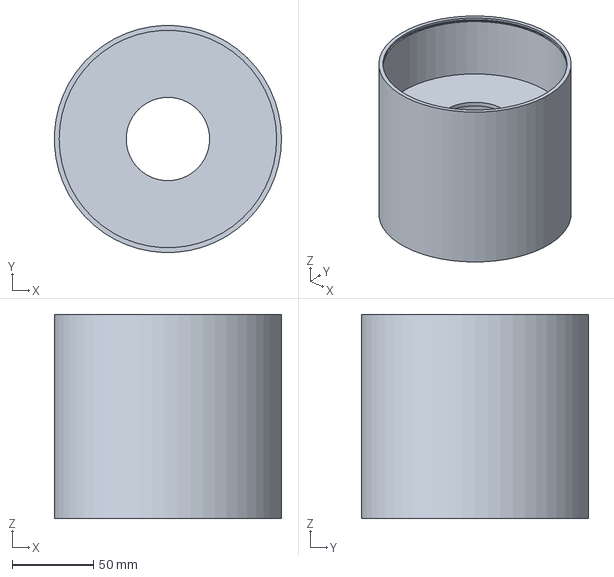
[picture p197: CAD file, 2026-10-12]
cad/exports/L/step/body_rear_shell.step
139.9 x 139.9 x 126.0 mm
