ratul-hasibulkarim/Pipe-crawller/(list of files, cad)

Other CAD files:
cad/exports/M/step/gimbal_tilt_cradle.step
cad/exports/S/step/mcu_board_RP2040.step
cad/exports/L/step/slip_ring_6w.step
cad/exports/L/step/gimbal_tilt_cradle.step
cad/exports/M/step/cell_18650.step
cad/exports/M/step/slip_ring_6w.step
cad/exports/M/step/buck_48v_12v_5v.step
cad/exports/L/step/buck_48v_12v_5v.step
cad/exports/L/step/camera_module.step
cad/exports/M/step/gimbal_pan_yoke.step
cad/exports/S/step/tilt_servo_nano.step
cad/exports/M/step/camera_module.step
cad/exports/M/step/mcu_board_RP2040.step
cad/exports/M/step/slide_bushing.step
cad/exports/M/step/pan_gearmotor_n20.step
cad/exports/L/step/led_ring_mount.step
cad/exports/L/step/rocker_plate.step
cad/exports/M/step/bevel_crown.step
cad/exports/M/step/expansion_motor_NEMA17.step
cad/exports/M/step/lever_plate.step
cad/exports/S/step/tether_strain_relief.step
