ratul-hasibulkarim/Pipe-crawller/docs/assembly_manual.md

# PIPEBOT-X assembly manual

Generated by `cad/build.py` from `params/bot_params.yaml`. Part names match the STEP files in
`cad/exports/<size>/step/` and the BOM (`docs/bom.csv`). Torques are for A2 SHCS into 6061;
into heat-set inserts use 60 %. Use medium threadlocker on every screw in the arm and gearbox.

| Thread | Torque into Al (N·m) | Into insert (N·m) |
|---|---|---|
| M2 | 0.25 | 0.15 |
| M2.5 | 0.45 | 0.27 |
| M3 | 0.80 | 0.48 |
| M4 | 1.80 | 1.08 |

## Size S (102-200 mm pipe)

### A. Gearbox and rear pod (flooded gearbox: pack with marine grease, NLGI 2)
1. Press 2x `worm_bearing_block` into each of the three radial bores of `gearbox_bulkhead`.
2. Slide `bevel_pinion` onto each `expansion_worm` shaft (set screw on the flat), insert the shafts from the outside.
3. Fit `bevel_crown` on the `planetary_*` output shaft; bolt planetary to the `expansion_motor_*` face (M2.5, 0.45 N·m).
4. Insert motor+planetary into `body_rear_shell` from the rear until the motor face seats on the internal ring; screw the shell to the gearbox (O-ring `service_hatch_gasket` greased).
5. Check by hand: turning the motor shaft turns all three worms; with the motor unpowered, a worm cannot be back-driven from the sector side (self-lock).
6. Route the tether through `tether_strain_relief`, clamp the Kevlar member in the collet (pull test 200 N for 60 s), fit the cap with its O-ring.

### B. Arms (repeat x3)
7. Slide the `pivot_shaft` through lug, `lever_plate`, `worm_sector`, `lever_plate`, lug; E-clips both ends. Mesh the sector at the retracted end tooth (expansion at min).
8. Assemble the rocker: press thin-section bearings into both `rocker_plate`s, fit `wheel_axle`s through bearings, `wheel_hub`+`wheel_tread`s and the GT2 `timing_pulley`s on the belt side.
9. Bolt `drive_stepper_*` + `drive_motor_mount` + `drive_worm_gearbox_*` between the rocker plates; fit `drive_belt_GT2`, tension with `belt_tensioner` (deflection 1 mm at 5 N on the long span).
10. Insert `slide_bushing`s + `stub_pin`s, drop the grip spring in each slot, close with `compliance_spring_retainer` (hall sensor faces the magnet in the pin).
11. Pin the rocker to the lever tip. Check: rocker pitches freely +/-10 deg and slides +/-5 mm against the spring.

### C. Spine, joint, front pod
12. Bolt `body_mid_chassis` (spine) to the gearbox front face; pass all wires through the spine (no wire crosses an arm joint).
13. S is tether-powered: no battery.
14. Fit `articulation_yoke_rear`, `articulation_spider`, `articulation_yoke_front`; slide `joint_boot` over and clamp. Leave a 30 mm service loop of the wiring inside the boot.
15. Fit compute board, controller PCB and buck on `electronics_tray`; slide the tray into `body_front_shell`.
16. Gimbal: `slip_ring_6w` and `pan_gearmotor_*` to the tray front; `tilt_servo_*` into `gimbal_pan_yoke`; camera into `gimbal_tilt_cradle`; cradle pins into yoke arms. Check +/-90 deg tilt hard stops and continuous pan.
17. `led_ring_mount` with 4 white + 2 IR LEDs and the front VL53L1X; `camera_window` dome with O-ring; `nose_bumper` into its groove.

### D. Final checks
18. Mass 1.671 kg incl. wiring allowance (target 1.8 kg); CG radial offset 0.13 mm.
19. Run `tests/acceptance` T4 (diameter sweep) dry before the first pipe run; then T1 hold test.
20. IP68: 30 min at 1 m (T13) with the gearbox flooded and the dry pods sealed.

## Size M (152-320 mm pipe)

### A. Gearbox and rear pod (flooded gearbox: pack with marine grease, NLGI 2)
1. Press 2x `worm_bearing_block` into each of the three radial bores of `gearbox_bulkhead`.
2. Slide `bevel_pinion` onto each `expansion_worm` shaft (set screw on the flat), insert the shafts from the outside.
3. Fit `bevel_crown` on the `planetary_*` output shaft; bolt planetary to the `expansion_motor_*` face (M3, 0.80 N·m).
4. Insert motor+planetary into `body_rear_shell` from the rear until the motor face seats on the internal ring; screw the shell to the gearbox (O-ring `service_hatch_gasket` greased).
5. Check by hand: turning the motor shaft turns all three worms; with the motor unpowered, a worm cannot be back-driven from the sector side (self-lock).
6. Route the tether through `tether_strain_relief`, clamp the Kevlar member in the collet (pull test 200 N for 60 s), fit the cap with its O-ring.

### B. Arms (repeat x3)
7. Slide the `pivot_shaft` through lug, `lever_plate`, `worm_sector`, `lever_plate`, lug; E-clips both ends. Mesh the sector at the retracted end tooth (expansion at min).
8. Assemble the rocker: press thin-section bearings into both `rocker_plate`s, fit `wheel_axle`s through bearings, `wheel_hub`+`wheel_tread`s and the GT2 `timing_pulley`s on the belt side.
9. Bolt `drive_stepper_*` + `drive_motor_mount` + `drive_worm_gearbox_*` between the rocker plates; fit `drive_belt_GT2`, tension with `belt_tensioner` (deflection 1 mm at 5 N on the long span).
10. Insert `slide_bushing`s + `stub_pin`s, drop the grip spring in each slot, close with `compliance_spring_retainer` (hall sensor faces the magnet in the pin).
11. Pin the rocker to the lever tip. Check: rocker pitches freely +/-10 deg and slides +/-5 mm against the spring.

### C. Spine, joint, front pod
12. Bolt `body_mid_chassis` (spine) to the gearbox front face; pass all wires through the spine (no wire crosses an arm joint).
13. Slide the 2x2 18650 pack in `battery_caddy` into the spine (M only).
14. Fit `articulation_yoke_rear`, `articulation_spider`, `articulation_yoke_front`; slide `joint_boot` over and clamp. Leave a 30 mm service loop of the wiring inside the boot.
15. Fit compute board, controller PCB and buck on `electronics_tray`; slide the tray into `body_front_shell`.
16. Gimbal: `slip_ring_6w` and `pan_gearmotor_*` to the tray front; `tilt_servo_*` into `gimbal_pan_yoke`; camera into `gimbal_tilt_cradle`; cradle pins into yoke arms. Check +/-90 deg tilt hard stops and continuous pan.
17. `led_ring_mount` with 4 white + 2 IR LEDs and the front VL53L1X; `camera_window` dome with O-ring; `nose_bumper` into its groove.

### D. Final checks
18. Mass 4.024 kg incl. wiring allowance (target 4.2 kg); CG radial offset 0.21 mm.
19. Run `tests/acceptance` T4 (diameter sweep) dry before the first pipe run; then T1 hold test.
20. IP68: 30 min at 1 m (T13) with the gearbox flooded and the dry pods sealed.

## Size L (300-650 mm pipe)

### A. Gearbox and rear pod (flooded gearbox: pack with marine grease, NLGI 2)
1. Press 2x `worm_bearing_block` into each of the three radial bores of `gearbox_bulkhead`.
2. Slide `bevel_pinion` onto each `expansion_worm` shaft (set screw on the flat), insert the shafts from the outside.
3. Fit `bevel_crown` on the `planetary_*` output shaft; bolt planetary to the `expansion_motor_*` face (M4, 1.80 N·m).
4. Insert motor+planetary into `body_rear_shell` from the rear until the motor face seats on the internal ring; screw the shell to the gearbox (O-ring `service_hatch_gasket` greased).
5. Check by hand: turning the motor shaft turns all three worms; with the motor unpowered, a worm cannot be back-driven from the sector side (self-lock).
6. Route the tether through `tether_strain_relief`, clamp the Kevlar member in the collet (pull test 200 N for 60 s), fit the cap with its O-ring.

### B. Arms (repeat x3)
7. Slide the `pivot_shaft` through lug, `lever_plate`, `worm_sector`, `lever_plate`, lug; E-clips both ends. Mesh the sector at the retracted end tooth (expansion at min).
8. Assemble the rocker: press thin-section bearings into both `rocker_plate`s, fit `wheel_axle`s through bearings, `wheel_hub`+`wheel_tread`s and the GT2 `timing_pulley`s on the belt side.
9. Bolt `drive_stepper_*` + `drive_motor_mount` + `drive_worm_gearbox_*` between the rocker plates; fit `drive_belt_GT2`, tension with `belt_tensioner` (deflection 1 mm at 5 N on the long span).
10. Insert `slide_bushing`s + `stub_pin`s, drop the grip spring in each slot, close with `compliance_spring_retainer` (hall sensor faces the magnet in the pin).
11. Pin the rocker to the lever tip. Check: rocker pitches freely +/-10 deg and slides +/-5 mm against the spring.

### C. Spine, joint, front pod
12. Bolt `body_mid_chassis` (spine) to the gearbox front face; pass all wires through the spine (no wire crosses an arm joint).
13. Fit the 4S2P ring pack (`battery_caddy`) around the expansion motor (L only).
14. Fit `articulation_yoke_rear`, `articulation_spider`, `articulation_yoke_front`; slide `joint_boot` over and clamp. Leave a 30 mm service loop of the wiring inside the boot.
15. Fit compute board, controller PCB and buck on `electronics_tray`; slide the tray into `body_front_shell`.
16. Gimbal: `slip_ring_6w` and `pan_gearmotor_*` to the tray front; `tilt_servo_*` into `gimbal_pan_yoke`; camera into `gimbal_tilt_cradle`; cradle pins into yoke arms. Check +/-90 deg tilt hard stops and continuous pan.
17. `led_ring_mount` with 4 white + 2 IR LEDs and the front VL53L1X; `camera_window` dome with O-ring; `nose_bumper` into its groove.

### D. Final checks
18. Mass 14.92 kg incl. wiring allowance (target 15.0 kg); CG radial offset 0.11 mm.
19. Run `tests/acceptance` T4 (diameter sweep) dry before the first pipe run; then T1 hold test.
20. IP68: 30 min at 1 m (T13) with the gearbox flooded and the dry pods sealed.
