ratul-hasibulkarim/Pipe-crawller/cad/exports/L/params_solidworks.txt

"arm_angle_deg" = 120deg
"body_dia_mm" = 140mm
"cad_belt_pulley_pitch_dia_mm_L" = 19.1
"cad_belt_pulley_pitch_dia_mm_M" = 12.2
"cad_belt_pulley_pitch_dia_mm_S" = 7.6
"cad_belt_thickness_mm_L" = 1.6
"cad_belt_thickness_mm_M" = 1.4
"cad_belt_thickness_mm_S" = 1.4
"cad_bevel_module_mm_L" = 2
"cad_bevel_module_mm_M" = 1
"cad_bevel_module_mm_S" = 0.8
"cad_bevel_pinion_teeth_L" = 12
"cad_bevel_pinion_teeth_M" = 10
"cad_bevel_pinion_teeth_S" = 12
"cad_bulkhead_mm_L" = 8
"cad_bulkhead_mm_M" = 5
"cad_bulkhead_mm_S" = 4
"cad_bumper_height_mm_L" = 12
"cad_bumper_height_mm_M" = 8
"cad_bumper_height_mm_S" = 6
"cad_cap_min_mm" = 6mm
"cad_dome_outer_radius_mm_L" = 52
"cad_dome_outer_radius_mm_M" = 30
"cad_dome_outer_radius_mm_S" = 21
"cad_dome_wall_mm_L" = 3
"cad_dome_wall_mm_M" = 2
"cad_dome_wall_mm_S" = 1.5
"cad_drive_gearbox_len_mm_L" = 40
"cad_drive_gearbox_len_mm_M" = 25
"cad_drive_gearbox_len_mm_S" = 18
"cad_fillet_mm" = 1mm
"cad_interference_tolerance_mm3" = 0.5
"cad_led_ring_thickness_mm_L" = 8
"cad_led_ring_thickness_mm_M" = 6
"cad_led_ring_thickness_mm_S" = 5
"cad_lug_thickness_mm_L" = 5
"cad_lug_thickness_mm_M" = 3
"cad_lug_thickness_mm_S" = 2.5
"cad_mass_allowance_frac" = 0.12
"cad_min_wall_mm" = 2.5mm
"cad_moving_clearance_mm" = 0.5mm
"cad_pin_dia_mm_L" = 6
"cad_pin_dia_mm_M" = 4
"cad_pin_dia_mm_S" = 3
"cad_pivot_shaft_dia_mm_L" = 20
"cad_pivot_shaft_dia_mm_M" = 12
"cad_pivot_shaft_dia_mm_S" = 8
"cad_planetary_len_mm_L" = 50
"cad_planetary_len_mm_M" = 30
"cad_planetary_len_mm_S" = 20
"cad_stroke_samples" = 9
"cad_tread_sleeve_mm_L" = 10
"cad_tread_sleeve_mm_M" = 6
"cad_tread_sleeve_mm_S" = 4
"cad_worm_length_mm_L" = 30
"cad_worm_length_mm_M" = 16
"cad_worm_length_mm_S" = 10
"calc_arm_structural_load_n" = 344.168
"calc_bend_radius_mm" = 900mm
"calc_expansion_motor_torque_nm" = 0.838341
"calc_grip_limit_n" = 246.068
"calc_grip_per_arm_n" = 233.571
"calc_lever_torque_max_nm" = 86.9375
"calc_sector_tooth_force_n" = 2373.2
"cg_offset_mm" = 8mm
"compliance_travel_mm" = 5mm
"drive_axle_dia_mm" = 8mm
"drive_worm_rated_torque_nm" = 10
"drive_worm_ratio" = 21
"expansion_bevel_ratio" = 2.75
"expansion_planetary_ratio" = 10
"expansion_sector_face_mm" = 32mm
"expansion_sector_module_mm" = 2.5mm
"expansion_sector_teeth" = 36
"expansion_worm_pitch_dia_mm" = 40mm
"layout_front_pod_mm" = 235mm
"layout_joint_max_angle_deg" = 45deg
"layout_joint_mm" = 45mm
"layout_mid_zone_mm" = 260mm
"layout_rear_pod_mm" = 250mm
"layout_spine_dia_mm" = 40mm
"layout_spine_wall_mm" = 2mm
"layout_wall_mm" = 3mm
"lever_angle_extended_deg" = 68.7488deg
"lever_angle_retracted_deg" = 10.8361deg
"lever_length_mm" = 250mm
"lever_pivot_radius_mm" = 55mm
"lever_plate_height_mm" = 40mm
"lever_plate_thickness_mm" = 5mm
"mass_target_kg" = 15
"max_grip_force_per_arm_n" = 250
"max_speed_mm_s" = 70
"pipe_id_max_mm" = 650mm
"pipe_id_min_mm" = 300mm
"power_battery_parallel" = 2
"power_battery_series" = 6
"power_buck_5v_a" = 5
"power_buck_motor_a" = 20
"power_cell_ah" = 3.5
"power_compute_avg_w" = 9
"power_compute_peak_w" = 12
"power_motor_rail_v" = 24
"rocker_axle_offset_mm" = 12mm
"rocker_belt_width_mm" = 9mm
"rocker_contact_stiffness_n_mm" = 370
"rocker_plate_thickness_mm" = 4mm
"rocker_pod_drop_mm" = 12mm
"rocker_spring_rate_n_mm" = 3.2
"wheel_crown_radius_mm" = 45mm
"wheel_dia_mm" = 70mm
"wheel_reach_extended_dia_mm" = 670mm
"wheel_reach_retracted_dia_mm" = 298mm
"wheel_width_mm" = 30mm
"wheelbase_mm" = 230mm
