ratul-hasibulkarim/Pipe-crawller/(commit log)

2026-10-11 Fix line length in design calcs
    Claude-Session: https://claude.ai/code/session_01Se2iKuEF2MCtp3b6pXc9of
    [design_calcs.py]
2026-10-12 Worm-sector mechanism, parametric CAD (S/M/L), protocol, firmware core and SIL simulator
    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
    [articulation_spider.step, articulation_yoke_front.step, articulation_yoke_rear.step, assembly.step, battery_caddy.step, bearing_MR106ZZ.step, bearing_MR128ZZ.step, bearing_MR74ZZ.step]
2026-10-12 Firmware: RP2040 HAL (compiles for S/M/L), native Unity tests, sag-aware grip logic
    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
    [expansion_loop.cpp, expansion_loop.h, main.cpp, robot.cpp, rp2040_hal.cpp]
2026-10-12 Acceptance T1-T15 on the simulator, Makefile, CI; fixes found in simulation
    Grip sensor saturation limit, horizontal sag load sizing, median-arm squeeze,
    slide/tread-corrected diameter, stroke margins (S/M min ID re-rated), stepper +
    encoder lever fusion, geometry thermal model, per-material friction. Docs: real-world
    issues/FMEA, SolidWorks and simulation guide.
    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
    [articulation_spider.step, articulation_yoke_front.step, articulation_yoke_rear.step, assembly.step, battery_caddy.step, bearing_MR106ZZ.step, bearing_MR128ZZ.step, bearing_MR74ZZ.step]
2026-10-12 Docs: test plan, theory of operation, operator manual, wiring diagram, README
    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
